Reve7339/FP_Robotics/articulo.pdf

Diseno e Implementaci ˜ | on de un Brazo Rob ´ | otico de ´
| 3 GDL para Corte Laser No-Coplanar ´

Ivan Yerry Hinojosa Zegarra EAP Ingeniería Mecatronica ´ Universidad Continental
Huancayo, Perú
72241950@continental.edu.pe

Brayan Omar Duran Arroyo
EAP Ingeniería Mecatronica ´ Universidad Continental
Huancayo, Perú
72542899@continental.edu.pe

Carlos Benedic Sosa Carhuamaca EAP Ingeniería Mecatronica ´ Universidad Continental
Huancayo, Perú
60847160@continental.edu.pe

Jorge Andre Tapia Patinõ
EAP Ingeniería Mecatronica ´ Universidad Continental
Huancayo, Perú
60761518@continental.edu.pe
Resumen—El presente artículo detalla el diseno, simulaci ˜ | on´
y construccion f ´ | ísica de un brazo manipulador antropomorfico ´
de 3 grados de libertad (GDL) orientado al corte y perfilado laser no-coplanar. El objetivo principal ha sido desarrollar ´ un sistema capaz de seguir trayectorias tridimensionales sobre superficies cilíndricas e irregulares mediante un emisor laser en ´ su efector final, controlado por un microcontrolador ESP32. Se han implementado los modelos de cinematica directa, inversa ´ y Jacobiana para garantizar el posicionamiento espacial en los tres ejes (X, Y, Z) y conservar la distancia focal del laser. La ´
estructura física se fabrico en impresi ´ | on 3D a partir de mallas ´
STL, con un firmware desarrollado en C++. La validacion´
cinematica se realiz ´ | o mediante simulaci ´ | on virtual en ROS 2 y ´
Gazebo de forma puramente offline.
Index Terms—Cinematica, brazo rob ´ | otico, ESP32, C++, ROS ´
2, simulacion virtual. ´
I. INTRODUCCION´

En la industria moderna, los brazos roboticos son he- ´ rramientas fundamentales para tareas de precision como la ´
soldadura y el corte laser. Comprender la cinem ´ | atica detr ´ | as´
de estos mecanismos es el primer paso para su control y programacion [1]. Este proyecto busca aplicar los conceptos ´ teoricos de modelado de robots —tales como matrices de ´
transformacion homog ´ | enea, representaci ´ | on de orientaci ´ | on y ´
cinematica diferencial— en un caso de uso pr ´ | actico. ´
Al estructurar el modelo con 3 grados de libertad (GDL)
(rotacion en la base, elevaci ´ | on en el hombro y elevaci ´ | on en ´
el codo), se simplifico el an ´ | alisis geom ´ | etrico sin perder la ´
capacidad de posicionar el efector final en un volumen de trabajo tridimensional. Ademas, el proyecto utiliza un emisor ´ laser de baja potencia (Clase 1/2) como efector final. A ´ diferencia de procesos de contacto como la soldadura por
arco, el laser permite una validaci ´ | on cinem ´ | atica de “no- ´
contacto”. Esto simplifica el control al eliminar la necesidad de
compensar fuerzas de friccion o colisiones mec ´ | anicas directas ´
contra la pieza de trabajo, permitiendo un seguimiento de trayectoria preciso y eficiente. Este enfoque es crucial para el corte y grabado sobre superficies irregulares y curvadas en tres dimensiones, donde el brazo debe seguir contornos tridimensionales curvos sobre una superficie no plana manteniendo constante la distancia focal del haz laser, una ´
operacion inviable para m ´ | aquinas cartesianas 2D tradicionales. ´
El desarrollo del software, simulacion, firmware embebido e ´ interfaz web se encuentra disponible de forma publica en el ´ repositorio de GitHub del proyecto [2].

II. OBJETIVOS

A. Objetivo General

Desarrollar, simular y construir un brazo robotico articulado ´ de 3 GDL orientado a procesos de corte laser no-coplanar ´ sobre superficies curvas e irregulares, validando los modelos
cinematicos en simulaci ´ | on virtual (ROS 2/Gazebo) y, de forma ´
independiente, en el prototipo físico controlado por un ESP32.
B. Objetivos Específicos

Definir los parametros de Denavit-Hartenberg y resolver ´ analíticamente la cinematica directa, inversa y Jacobiana ´ para garantizar el seguimiento espacial tridimensional (X, Y, Z) y la evasion de singularidades en superficies ´ no planas.
Modelar la estructura física en URDF/Xacro y simular el comportamiento del sistema utilizando el sistema operativo de robots (ROS 2, por sus siglas en ingles) y ´ Gazebo de manera exclusivamente virtual, sin conexion´ física con el prototipo.
Fabricar los eslabones y la base del robot utilizando tecnologías de impresion 3D a partir de archivos STL. ´ Implementar el control de bajo nivel del hardware mediante un microcontrolador ESP32, utilizando C++ para accionar las articulaciones físicas del prototipo.

III. MODELADO CINEMATICO ´

Se utiliza la convencion de Denavit-Hartenberg (D-H) cl ´ | asi- ´
ca para describir la geometría y cinematica del brazo manipu- ´ lador antropomorfico de 3 GDL. ´
A. Justificacion de la Morfolog ´ | ía y Comparacion de Alter- ´
nativas
El brazo robotico desarrollado se destina a la aplicaci ´ | on´
de corte y perfilado laser no-coplanar sobre piezas cil ´ | índricas.
Específicamente, el objetivo es seguir trayectorias espaciales complejas sobre una superficie cilíndrica con un diametro real ´ de 5,3 cm (radio Rtubo = 26,5 mm) montada sobre un soporte de 60 mm de altura. La pieza cilíndrica esta posicionada a ´ una distancia nominal de xtubo = 350 mm y una altura de base ztubo = 60 mm con respecto al origen de la base del robot. Para esta tarea, es indispensable posicionar el efector final de manera tridimensional (X, Y, Z) controlando dinami- ´ camente la altura del cabezal para mantener una distancia de enfoque constante normal al cilindro, evitando colisiones con la estructura del tubo.
Las restricciones físicas del proyecto imponen el uso de actuadores servo de bajo costo (dos MG996R y un MG90S) con un presupuesto de torque limitado. Esto restringe la masa
del efector final, lo que justifica la seleccion de un diodo l ´ | aser ´
semiconductor ligero de estado solido ( ´ | 10 g) que no introduce
esfuerzos inerciales significativos a diferencia de herramientas de mecanizado por contacto.
Con el fin de justificar la seleccion de la morfolog ´ | ía
antropomorfica de 3 GDL (RRR), se analizaron diferentes ´
arquitecturas roboticas est ´ | andar de 3 GDL (Tabla I). ´

Tabla I
COMPARACION DE ´ | MORFOLOGÍAS DE 3 GDL PARA CORTE LASER DE ´
PIEZAS CILÍNDRICAS
Morfología | Config. | Ventajas | Desventajas
Cartesiana | PPP | Alta | rigidez
| | mecanica, ´
| | linealidad | directa
en X, Y, Z.
Gran | volumen
| | | ocupado
| | | (footprint),
incapacidad | de
| | | esquivar obstaculos ´
sin | colisionar
| | | lateralmente.
SCARA | RRP | Alta velocidad en
plano horizontal.

Carrera vertical
(Z) reducida para
| | | geometrías curvas
| | | con gran pendiente
| | | vertical.

Cilíndrica / Polar RPP / RRP Facil alcance radial ´
| | y vertical. | La columna verti-
| | | cal rígida interfie-
| | | re físicamente con
| | | piezas curvas adya-
| | | centes.

Antropomorfica ´
(Seleccionada)

RRR Excelente relacion´
espacio de trabajo
/ huella base, flexibilidad para rodear el tubo y evitar colisiones.
| | | Ecuaciones
| | | cinematicas ´
no | lineales | y
| | | acoplamiento
| | | dinamico. ´
La morfología antropomorfica RRR resulta id ´ | | onea para esta ´
aplicacion al permitir que el brazo se “enrosque” o alcance ´ por encima de la curvatura de la pieza cilíndrica sin que sus eslabones interfieran con ella, manteniendo una alta rigidez en un diseno compacto. Su espacio de trabajo esperado se ˜ caracteriza por una envoltura esferica truncada determinada ´ por los límites de las articulaciones físicas del prototipo:
Articulacion 1 (Base): ´ | θ1 ∈ [−90◦
| | , 90◦ ] (debido a la
restriccion f ´ | ísica de 180◦ del servomotor).
Articulacion 2 (Hombro): ´ | θ2 ∈ [−90◦
| | , 90◦ ] (restringido
en firmware a [−10◦

, 90◦
] por seguridad estructural).
Articulacion 3 (Codo): ´ | θ3 ∈ [−90◦
| | , 90◦ ] (restringido en
firmware a [−120◦

, 10◦
] para evitar colision con el plano ´ de soporte).
Alcance radial maximo: ´ | Rmax | = a2 + a3 + a4 =
322,000 mm
B. Sistemas de Referencia y Parametros D-H ´

Se definen cuatro sistemas de referencia locales {0}, {1}, {2} y {3} asociados a cada articulacion m ´ ovil y al efector final ´ de la estructura, coincidiendo con los marcos de simulacion. ´

d1 = 60 mm: Altura del pedestal de la base.
d2 = 36 mm: Altura del hombro.
a2 = 15 mm: Desfase radial base-hombro.
a3 = 146 mm: Longitud del primer eslabon m ´ | ovil. ´
a4 = 161 mm: Longitud del segundo eslabon m ´ | ovil. ´
d4 = −7 mm: Desplazamiento transversal del efector.
θ1: Angulo de rotaci ´ | on de la base (alrededor del eje ´
vertical Z0).
θ2: Angulo del hombro. ´
θ3: Angulo del codo. ´
La convencion cl ´ | asica de D-H establece que la matriz de ´
transformacion homog ´ | enea entre eslabones consecutivos se ´
calcula mediante:

T

i−1
i =

cos θi | − sin θi cos αi | sin θi sin αi | ai cos θi
sin θi | cos θi cos αi | − cos θi sin αi | ai sin θi
0 | sin αi | cos αi | di
0 | 0 | 0 | 1

| | | (1)
A partir de los sistemas de referencia y dimensiones físicas asignados, se obtiene la Tabla de Parametros D-H (Tabla II). ´
La Fig. 1 ilustra la disposicion geom ´ | etrica de estos par ´ | ametros ´
sobre el modelo físico del brazo en su configuracion de reposo ´ (θ1 = θ2 = θ3 = 0).

Tabla II
PARAMETROS DE ´ | DENAVIT-HARTENBERG REALES DEL PROTOTIPO
Eslabon ( ´ | i) | di (mm) | θi | ai (mm) | αi
1 (0 → 1) | d1 + d2 = 96 θ1 | a2 = 15 | 90◦
2 (1 → 2) | 0 | θ2 | a3 = 146 | 0
3 (2 → 3) | d4 = −7 | θ3 | a4 = 161 | 0

Láser

Haz Láser

θ1

θ2 | θ3

d1
60 mm

d2
36 mm

a2 = 15 mm

a3 = 146 mm | a4 = 161 mm

a2 + a3 + a4 = 322 mm

d4 = −7 mm

Eje X (Rojo)

Eje Z (Azul)

Eje Y (Verde)

X0

Z0

Y0
{0}

X1 Z1

Y1

{1}
X2 Z2

Y2

{2}
X3 Z3

Y3

{3}

Figura 1. Disposicion geom ´ | etrica del brazo rob ´ | otico l ´ | aser en configuraci ´ | on´
de reposo (θ1 = θ2 = θ3 = 0). Se indican los sistemas de referencia D-H {0}–{3}, las longitudes de eslabon´ a3, a4, los desplazamientos d1, d2 y el desfase transversal d4.

B1. Mapeo de Variables Articulares y Desfases Geometri- ´ cos: Es fundamental destacar que las variables articulares θi de la Tabla II corresponden al modelo teorico de Denavit- ´ Hartenberg (donde el brazo totalmente extendido horizontal-
mente define los angulos de hombro y codo ´ | θ2 = θ3 = 0).
Sin embargo, en la construccion f ´ | ísica del prototipo y en el
modelo descriptor URDF de ROS 2/Gazebo, los servomotores se calibran en posiciones angulares relativas a sus ejes de montaje estructural. La correspondencia matematica exacta ´
entre los angulos te ´ | oricos de D-H ( ´ | θ

∗
2

, θ∗
3
) y los angulos f ´ | ísicos
comandados a los servomotores (θ2, θ3) esta definida por los ´ desfasajes angulares mecanicos ´ ϕ2 ≈ 59,017◦
(1,030041 rad)
y ϕ3 ≈ −10,966◦
(−0,191392 rad):

θ

∗
2 = θ2 + ϕ2 | (2)
θ

∗
3 = θ3 + ϕ3 − ϕ2 | (3)

Donde θ

∗
2 y θ

∗
3

son los angulos efectivos utilizados en las ´
matrices de transformacion homog ´ | enea y en el c ´ | alculo de ci- ´
nematica directa anal ´ | ítica, mientras que θ2 y θ3 son los angulos ´
comandados desde el software de control a las articulaciones físicas del robot.
C. Cinematica Directa ´

Sustituyendo los parametros de la Tabla II en (1), se ob- ´
tienen las matrices de transformacion homog ´ | enea individuales ´
para cada articulacion y eslab ´ | on: ´

T

0
1 =

cos θ1 | 0 | sin θ1 | a2 cos θ1
sin θ1 | 0 − cos θ1 | a2 sin θ1
0 | 1 | 0 | d1 + d2
0 | 0 | 0 | 1

(4)

T

1
2 =

cos θ2 | − sin θ2 | 0 a3 cos θ2
sin θ2 | cos θ2 | 0 a3 sin θ2
0 | 0 | 1 | 0
0 | 0 | 0 | 1

(5)

T

2
3 =

cos θ3 | − sin θ3 | 0 a4 cos θ3
sin θ3 | cos θ3 | 0 a4 sin θ3
0 | 0 | 1 | d4
0 | 0 | 0 | 1

(6)

Multiplicando consecutivamente estas matrices se obtiene
la matriz de transformacion homog ´ | enea total del efector final ´
respecto a la base del robot T

0
3 = T

0
| 1 T

1
2 T
2/3. Definimos
esta matriz en funcion de las coordenadas del efector final ´ [xE, yE, zE]

T dadas en (8)-(10):

T

0
3 =

C1C23 | −C1S23 | S1 | xE
S1C23 | −S1S23 | −C1 | yE
S23 | C23 | 0 | zE
0 | 0 | 0 | 1

(7)

donde se utiliza la notacion compacta ´ | C1 = cos θ1, S1 =
sin θ1, C23 = cos(θ2 + θ3) y S23 = sin(θ2 + θ3).
El vector de posicion del efector final ´ | PE = [xE, yE, zE]

T
esta dado por: ´

xE = cos θ1 (a2 + a3 cos θ2 + a4 cos(θ2 + θ3)) + d4 sin θ1 (8)
yE = sin θ1 (a2 + a3 cos θ2 + a4 cos(θ2 + θ3)) − d4 cos θ1 (9)
zE = d1 + d2 + a3 sin θ2 + a4 sin(θ2 + θ3) (10)

Para verificar la consistencia del modelo matematico de- ´
sarrollado, se evaluan las ecuaciones de cinem ´ | atica directa ´
bajo la configuracion de reposo del prototipo (con todas las ´ articulaciones en sus posiciones centrales θ1 = 0, θ2 = 0, θ3 = 0). En este estado, al sustituir los valores y las constantes físicas en (8)-(10), se obtiene:

xE = a2 + a3 cos(0) + a4 cos(0)
= 15 + 146 + 161 = 322 mm | (11)
yE = −d4 = 7 mm | (12)
zE = d1 + d2 + a3 sin(0) + a4 sin(0)
= 60 + 36 + 0 + 0 = 96 mm | (13)

Estos resultados analíticos coinciden exactamente con las coordenadas de la brida (efector final) obtenidas directamente
del arbol de transformadas (TF) de la simulaci ´ | on virtual de ´
ROS 2 (X = 322 mm, Y = 7 mm, Z = 96 mm). Esto valida
la precision del modelo cinem ´ | atico de 4 sistemas propuesto ´
para el guiado de trayectorias.
Para hallar la distancia total en 3D desde el origen del sistema de referencia {0} hasta el efector final en esta posicion´
de reposo, se descompone el calculo geom ´ | etrico en dos etapas ´
mediante el teorema de Pitagoras: 1) Primero, se considera ´ la proyeccion bidimensional sobre el plano longitudinal del ´ brazo (vista lateral, Fig. 2), omitiendo temporalmente el desplazamiento transversal d4. En esta vista, el vector de posicion´ proyectado tiene componentes (xplane, zplane), donde:
xplane = a2 + a3 + a4 = 15 + 146 + 161 = 322 mm | (14)
zplane = d1 + d2 = 60 + 36 = 96 mm | (15)

La distancia proyectada Dplane actua como la hipotenusa de ´
este primer triangulo rect ´ | angulo en el plano vertical: ´

Dplane =

q
x

2
plane + z

2
plane
=

p
322² + 96²

=

√
112900 = 336 mm

(16)

Es de destacar que esta combinacion de par ´ | ametros f ´ | ísicos
produce un valor entero exacto de 336 mm para la hipotenusa del plano de movimiento longitudinal. 2) Segundo, para determinar la distancia tridimensional real, se toma Dplane como el primer cateto y el desfase lateral d4 = 7 mm como el segundo
cateto de un nuevo triangulo rect ´ | angulo en el espacio 3D. La ´
hipotenusa resultante representa la distancia total del efector final al origen:

Dtotal =

q
D²
plane + d

2
4
=

p
336² + 7²

=

√
112949 ≈ 336,08 mm

(17)

Este metodo valida geom ´ | etricamente que las coordenadas ´
tridimensionales calculadas mediante el formalismo D-H son consistentes con la morfología del hardware real.

X0 (mm)

Z0 (mm)

d1 = 60

d2 = 36

a2 | = 15 H | a3 = 146 | C | a4 = 161 | E′

xplane = 322 mm

zplane = 96 mm

Dplane = 336 mm

Figura 2. Deduccion geom ´ | etrica de la distancia proyectada en vista lateral ´
(Dplane) en configuracion de reposo ( ´ | θ1 = 0, θ2 = 0, θ3 = 0). Los eslabones
se alinean horizontalmente formando un triangulo rect ´ | angulo con catetos de ´
322 mm y 96 mm, resultando en una distancia proyectada exacta de 336 mm.
D. Cinematica Inversa y An ´ | alisis de M ´ | ultiples Soluciones ´
La resolucion de la cinem ´ | atica inversa consiste en determi- ´
nar los angulos f ´ | ísicos de los servomotores (θ1, θ2, θ3) a partir
de una posicion cartesiana deseada ´ | | PE = [xE, yE, zE]

T
. Para
ello, desacoplamos el efecto de la rotacion de la base y del ´ desfase transversal d4 de la siguiente manera:
1) Calculo de ´ | θ1 (Rotacion de la Base): ´ | Geometricamente, ´
definimos el radio proyectado plano Rp como la longitud de la proyeccion horizontal de los eslabones principales del brazo ´ en el suelo (desde el eje central de rotacion de la base hasta la ´ punta del brazo). A partir de la cinematica directa en (8)-(9), ´
este radio esta determinado por los eslabones f ´ | | ísicos ai y los
angulos del hombro y codo como: ´
Rp = a2 + a3 cos θ2 + a4 cos(θ2 + θ3) | (18)
Para desacoplar el angulo de la base ´ | θ1, consideramos la
posicion de la punta del brazo en el marco de referencia local ´ del brazo {1} (el cual gira con la base un angulo ´ θ1). En dicho plano local, la coordenada a lo largo del brazo es x1 = Rp y la coordenada transversal debida al desfase transversal de la herramienta es y1 = −d4. La transformacion de estas ´ coordenadas locales al marco global {0} de la base se realiza
mediante una matriz de rotacion alrededor del eje vertical ´ | Z0:
xE
yE
=
cos θ1 | − sin θ1
sin θ1 | cos θ1

Rp
−d4
(19)

Al resolver el producto de la matriz anterior, obtenemos las ecuaciones de la cinematica directa: ´

xE = Rp cos θ1 + d4 sin θ1 | (20)
yE = Rp sin θ1 − d4 cos θ1 | (21)

Elevando al cuadrado y sumando ambas expresiones, el angulo ´ θ1 se elimina mediante la identidad trigonometrica funda- ´ mental sin²
θ1 + cos²
θ1 = 1, lo que nos permite calcular
directamente el valor numerico de ´ | Rp a partir de la coordenada
cartesiana de consigna (xE, yE):

x

2
E + y

2
E = R

2
p + d

2
4 =⇒ Rp =

q
x

2
E + y

2
E − d

2
4

(22)

Realizando la sustitucion de variables polares en el plano ´
XY mediante xE | = R cos β y yE | = R sin β (donde
R =

p
x

2
E + y

2
E

y β = atan2(yE, xE)), las ecuaciones se transforman en:

R cos(β − θ1) = Rp | (23)
R sin(β − θ1) = −d4 | (24)

Dividiendo ambas expresiones trigonometricas, obtenemos el ´
angulo diferencial respecto a la proyecci ´ | on cartesiana: ´
β − θ1 = atan2(−d4, Rp) | (25)
Despejando θ1, se deriva la solucion anal ´ | ítica exacta:
θ1 = atan2(yE, xE) − atan2(−d4, Rp) | (26)
2) Calculo de ´ | θ3 (Elevacion del Codo): ´ | Se define la proyec-
cion en el plano longitudinal del brazo. El radio proyectado ´ corregido r (distancia horizontal desde el eje del hombro al efector) y la altura corregida respecto al hombro z

′
se formulan
como:
r = Rp − a2 | (27)

z

′ = zE − (d1 + d2) | (28)

Aplicando la ley de los cosenos en el triangulo formado por ´ los eslabones a3 y a4 en el plano del brazo para resolver el
angulo del codo ´ | θ3:

r

2 + z

′2 = a

2
3 + a

2

4 − 2a3a4 cos(180◦ − θ3) (29)

Considerando que cos(180◦ − θ3) = − cos θ3, se tiene:

r

2 + z

′2 = a

2
3 + a

2
4 + 2a3a4 cos θ3 | (30)

Despejando el termino del coseno se obtiene: ´

cos θ3 =

r

2 + z

′2 − a

2
3 − a

2
4
2a3a4
= Ψ | (31)
Para la existencia de una solucion f ´ | ísica real libre de numeros ´
complejos, se debe cumplir estrictamente −1 ≤ Ψ ≤ 1. Físicamente, un valor fuera de este rango denota que la coordenada cartesiana solicitada se encuentra fuera del alcance del manipulador (ya sea por estar muy lejana o excesivamente cercana a la base). En lugar de calcular el angulo directamente ´
mediante la funcion de arco coseno ( ´ | θ3 = arc cos Ψ), la cual
presenta inestabilidad numerica en las fronteras ( ´ | Ψ ≈ ±1)
e incertidumbre respecto al signo del angulo, se recurre al ´
calculo del seno de ´ | θ3 mediante la identidad trigonometrica ´
fundamental, sin θ3 = ±

√
1 − Ψ². Esto permite resolver el
angulo de forma num ´ | ericamente robusta en todo el rango ´
[−π, π] mediante el operador arcotangente de dos argumentos:
| θ3 = atan2
±

p
1 − Ψ², Ψ
| | (32)

donde el signo positivo (+) representa la configuracion de ´ codo abajo (Elbow Down) y el signo negativo (−) representa la de codo arriba (Elbow Up).
En el firmware del microcontrolador ESP32 y en la interfaz
grafica, se selecciona de forma exclusiva la configuraci ´ | | on´
de codo arriba (utilizando el signo negativo). Esta decision´
de diseno mec ˜ | anico y de control evita colisiones f ´ | ísicas del
eslabon distal con la mesa de trabajo o la base de soporte, ´ asegurando un despeje maximo de la herramienta y mejorando ´ la operabilidad en superficies no planas.
3) Calculo de ´ | θ2 (Elevacion del Hombro): ´ | Una vez obtenido
θ3, se descompone la posicion cartesiana en el plano del brazo: ´
r = a3 cos θ2 + a4 cos(θ2 + θ3) | (33)
| z
′ = a3 sin θ2 + a4 sin(θ2 + θ3) | (34)

Expandiendo las identidades trigonometricas de la suma de ´
angulos y agrupando los t ´ | erminos: ´
r = (a3 + a4 cos θ3) cos θ2 − (a4 sin θ3) sin θ2 | (35)
z

′ = (a3 + a4 cos θ3) sin θ2 + (a4 sin θ3) cos θ2 (36)

Definiendo las constantes auxiliares sintonizadas k1 = a3 + a4 cos θ3 y k2 = a4 sin θ3, se reescribe el sistema lineal como:

| r = k1 cos θ2 − k2 sin θ2 | (37)
| z
| ′ = k1 sin θ2 + k2 cos θ2 | (38)
Resolviendo el sistema algebraico para los terminos de ´ | sin θ2
y cos θ2:
| sin θ2 =

k1z

′ − k2r
k

2
1 + k

2
2
| | (39)
| cos θ2 =

k1r + k2z

′
k

2
1 + k

2
2
| | (40)

Dividiendo ambas expresiones se determina de manera unica ´
el angulo de elevaci ´ | on del hombro: ´
| θ2 = atan2 (k1z | ′ − k2r, k1r + k2z ′
) | (41)
Alternativamente, aplicando el metodo geom ´ | etrico directo ´
para un manipulador planar de 2 GDL (con eslabones a3 y a4),
el angulo del hombro ´ | θ2 se formula a partir de la diferencia
de angulos en el tri ´ | angulo del brazo: ´

θ2 = atan2(z

| ′
, r) − atan2(a4 sin θ3, a3 + a4 cos θ3) (42)
La equivalencia matematica entre la soluci ´ | on algebraica (41) ´
y la solucion geom ´ | etrica (42) se demuestra mediante la ´

identidad de la diferencia de arcotangentes, atan2(A, B) − atan2(C, D) = atan2(AD − BC, BD + AC), lo que valida la coherencia cinematica del modelo embebido en el micro- ´ controlador.
D1. Gestion de L ´ | ímites Articulares y Puntos Inalcanza-
bles: Para garantizar la integridad física del manipulador y
evitar fallas críticas de ejecucion en el resolvedor matem ´ | atico: ´
Deteccion de Coordenadas Fuera de Alcance: ´ | El
algoritmo evalua el valor de ´ | Ψ en (31) antes de calcular
la raíz cuadrada en (32). Si |Ψ| > 1,0, la coordenada solicitada se encuentra geometricamente fuera de ´ la frontera de alcance del robot (muy lejana o muy cercana a la base). En este caso, el software descarta la consigna cartesiana, genera una alerta visual de tipo OUT_OF_RANGE y detiene el movimiento del laser. Se ´
aplica una pequena tolerancia de ˜ | ±0,005 para compensar
errores de truncamiento decimal de punto flotante en las fronteras extremas del espacio de trabajo.
Filtro de Límites Articulares: Una vez calculada la terna (θ1, θ2, θ3), se comprueba que se cumplan las restricciones físicas de giro de los actuadores del prototipo real (limitados a un rango de operacion f ´ ísica de 180◦ ):

−90◦ ≤ θ1 ≤ 90◦
(43)
−90◦ ≤ θ2 ≤ 90◦
(44)
−90◦ ≤ θ3 ≤ 90◦
(45)

Adicionalmente, el firmware del ESP32 restringe de for-
ma mas estricta estos m ´ | argenes angulares para garantizar ´
la seguridad del hardware frente a sobrecorrientes o colisiones con la mesa de trabajo:

−10◦ ≤ θ2 ≤ 90◦
(46)
−120◦ ≤ θ3 ≤ 10◦
(47)

Cualquier consigna que viole estos límites se descarta au-
tomaticamente para evitar colisiones mec ´ | anicas directas ´
o sobre-esfuerzo de los servomotores.
E. Jacobiano, Singularidades y Caracterizacion del Espacio ´ de Trabajo

La cinematica diferencial del manipulador relaciona las ´ velocidades del espacio articular con las velocidades lineales del efector en el espacio cartesiano. Para obtener la matriz Jacobiana Jv ∈ R

3×3
, se recurre al metodo geom ´ | etrico (pro- ´
ductos vectoriales basados en los sistemas de referencia D-H), siendo el mas conveniente por su simplicidad en articulaciones ´ rotacionales, expresandose columna por columna como: ´
Jvi = zi−1 × (pe − pi−1) | (48)

Al aplicar esta metodología a nuestro manipulador de 3 GDL, se definen los ejes de rotacion en el sistema de referencia ´ global:

z0 =

0
0
1
- , z1 = z2 =

sin θ1
− cos θ1
0
- (49)

y los vectores de posicion relativos del efector ´ | pe respecto a
la base p0 y al codo p2:

pe − p0 =

Rp cos θ1 + d4 sin θ1
Rp sin θ1 − d4 cos θ1
ze
| (50)

pe − p2 =

a4 cos(θ2 + θ3) cos θ1 + d4 sin θ1 a4 cos(θ2 + θ3) sin θ1 − d4 cos θ1 a4 sin(θ2 + θ3)

- (51)

donde Rp = a2 + a3 cos θ2 + a4 cos(θ2 + θ3) es el radio proyectado del brazo. Al calcular los productos vectoriales cruzados, se obtienen las columnas de la velocidad lineal:

Jv1 = z0 × (pe − p0) =

−Rp sin θ1 + d4 cos θ1
Rp cos θ1 + d4 sin θ1
0
- (52)

Jv3 = z2 × (pe − p2) =

−a4 cos θ1 sin(θ2 + θ3)
−a4 sin θ1 sin(θ2 + θ3)
a4 cos(θ2 + θ3)
- (53)

Al agrupar las tres columnas del manipulador, se conforma la matriz Jacobiana lineal final:

Jv =

−S1Rp + d4C1 | −C1(a3S2 + a4S23) −C1a4S23
C1Rp + d4S1 | −S1(a3S2 + a4S23) −S1a4S23
0 | a3C2 + a4C23 | a4C23
| | (54)
donde se emplea la notacion compacta ´ | Si , Ci | , S23 y C23 para
representar los senos y cosenos directos. Esto demuestra de
forma analítica que el metodo geom ´ | etrico entrega exactamente ´
el mismo resultado que la diferenciacion anal ´ | ítica.
E1. Calculo Simplificado del Determinante: ´ | | El determi-
nante de la matriz Jacobiana Jv es una herramienta analítica clave para determinar las singularidades cinematicas del robot. ´ Para calcularlo de forma simplificada, se realiza la expansion´ por cofactores a lo largo de la tercera fila de Jv en (54). Dado que esta fila posee un elemento nulo (J31 = 0), el determinante se reduce a la suma de dos terminos: ´

det(Jv) = −J32(J11J23 − J13J21) + J33(J11J22 − J12J21)
| | (55)
Este calculo se puede simplificar sustancialmente mediante ´ tres pasos clave:
1. Eliminacion de la orientaci ´ | on de la base ( ´ | θ1): Al
expandir los productos cruzados dentro de los parentesis ´
de (55), se factoriza de forma natural el termino ´ | sin²
| | θ1+
cos²
θ1 (utilizando la notacion compacta ´ | S

2
| | 1+C 2/1). Por la
identidad pitagorica fundamental, este t ´ | ermino es igual ´
a 1, eliminando por completo la influencia de θ1:
J11J23 − J13J21 = a4S23Rp | (56)
J11J22 − J12J21 = (a3S2 + a4S23)Rp | (57)

Esto demuestra analíticamente que la orientacion angular ´ de la base no afecta las singularidades de posicionamiento del brazo.
2. Agrupamiento de terminos en el plano: ´ | | Al sustituir
las simplificaciones anteriores y los coeficientes de la tercera fila J32 = a3C2 +a4C23 y J33 = a4C23 en (55),
se cancelan los terminos que contienen ´ | a
2/4, reduciendo
la expresion a: ´
det(Jv) = a3a4Rp(S2C23 − C2S23) | (58)
o de forma equivalente en terminos trigonom ´ | etricos ´
expandidos:

det(Jv) = a3a4Rp(sin θ2 cos(θ2 + θ3)
− cos θ2 sin(θ2 + θ3)) | (59)
3. Identidad del seno de la diferencia de angulos: ´
Utilizando la conocida identidad trigonometrica ´ | | sin(A−
B) = sin A cos B − cos A sin B (donde definimos A = θ2 y B = θ2 + θ3, de modo que A − B = −θ3 y sin(−θ3) = − sin θ3), se llega de forma directa a la formulacion final compacta del determinante: ´
det(Jv) = −a3a4Rp sin θ3 | (60)

Esta expresion demuestra que el determinante es independiente ´ del desfase transversal d4, lo que significa que el descentramiento lateral de la herramienta no influye en las condiciones de bloqueo del brazo.
E2. Cinematica Diferencial Inversa y Aplicaci ´ | on Num ´ | eri- ´
ca: Para controlar la velocidad de avance del cabezal laser a ´ lo largo del contorno y mantener un haz de corte homogeneo, ´ se calcula la cinematica diferencial inversa, la cual relaciona ´ la velocidad cartesiana lineal de consigna P˙ = [ ẋ, y,˙ z˙]
T
con las velocidades angulares requeridas en las articulaciones q˙ = [ ˙θ1,

˙θ2,

˙θ3]
T
a traves de ´ q˙ = J

−1

v P˙
Debido a que el determinante de Jv se dedujo en (60), es posible invertir la matriz de forma analítica desacoplando el movimiento en el plano radial y transversal. Al proyectar la velocidad cartesiana sobre el marco giratorio de la base, la velocidad angular de la base y la tasa de cambio del radio proyectado se expresan como:

˙θ1 =

−x˙ sin θ1 + ẏ cos θ1
Rp

(61)

R˙
p = ẋ cos θ1 + ẏ sin θ1 − d4
˙θ1 | (62)

Con el valor de R˙
p y la velocidad vertical deseada z˙, se resuelve el sistema coplanar para el hombro y el codo empleando la inversa de la submatriz planar Jplanar:

˙θ2 =

a

′

4C23R˙
p + a

′
4S23z˙
a3a

′
4S3

(63)

˙θ3 =

−(a3C2 + a

′

4C23)R˙
p − (a3S2 + a

′
4S23) ż
a3a

′
4S3

(64)

donde se emplea la notacion compacta ´ | S3 = sin θ3, C2 =
cos θ2, S2 = sin θ2, C23 = cos(θ2 +θ3) y S23 = sin(θ2 +θ3).
A modo de verificacion pr ´ | actica de estas ecuaciones de ve- ´
locidad, se evalua num ´ | ericamente el comportamiento din ´ | ami- ´
co del manipulador real con el eslabon extendido del l ´ | aser ´
a

′

4 = 361 mm en la configuracion articular ´ | θ1 = 0, θ2 = 30◦
(0,5236 rad) y θ3 = −45◦
(−0,7854 rad), asumiendo un requerimiento de velocidad lineal pura en sentido transversal

(eje Y ) de P˙ = [0, 100, 0]T mm/s (equivalente a un barrido transversal de 10 cm/s sobre la pieza):
1) Calculo del radio proyectado ´ | Rp:

Rp = a2 + a3 cos θ2 + a

′
4

cos(θ2 + θ3)
= 15 + 146 cos(30◦

) + 361 cos(−15◦
)
≈ 15 + 126,44 + 348,69 = 490,13 mm
2) Determinacion de las velocidades articulares: ´ Sustituyendo en (61) con sin(0) = 0 y cos(0) = 1:

˙θ1 =

−0 · 0 + 100 · 1
490,13

≈ 0,2040 rad/s (≈ 11,69◦
/s)

A partir del valor de ˙θ1, calculamos R˙
p mediante (62):

R˙
p = 0 · 1 + 100 · 0 − (−7) · 0,2040 ≈ 1,428 mm/s

Con R˙
p = 1,428 mm/s y z˙ = 0, resolvemos las velocidades angulares del hombro y del codo a traves´ de (63) y (64):

˙θ2 =

361 cos(−15◦
) · 1,428 + 0
146 · 361 sin(−45◦)

=

497,93
−37267,4

≈ −0,0134 rad/s (≈ −0,77◦
/s)

˙θ3 =

−(146 cos(30◦

) + 361 cos(−15◦
)) · 1,428 − 0
146 · 361 sin(−45◦)

=

−678,53
−37267,4

≈ 0,0182 rad/s (≈ 1,04◦
/s)
Este calculo demuestra c ´ | omo se distribuye vectorialmente la ´
velocidad de consigna cartesiana en las juntas mecanicas, ´ permitiendo que el software en la computadora host controle la dinamica del movimiento sin saturar el torque de los ´ servomotores físicos.
E3. Analisis F ´ ísico de Singularidades: Las singularidades cinematicas son configuraciones o ”posturas. ´

específicas donde
el robot se bloquea y pierde la capacidad de moverse en al-
guna direccion del espacio. Matem ´ | aticamente ocurren cuando ´
det(Jv) = 0, lo que provoca que el sistema exija velocidades infinitas en los servomotores para realizar movimientos cartesianos mínimos, generando sobrecorrientes y fallos. En este manipulador se identifican dos singularidades críticas: Singularidad del Codo (sin θ3 = 0 =⇒ θ3 = 0 ó θ3 = −π): Ocurre cuando el brazo esta completamente estira- ´ do o totalmente encogido. En esta posicion, el efector no ´
puede realizar ningun movimiento en la direcci ´ | on radial ´
del brazo (no puede estirarse ni encogerse mas). Si se ´ le ordena avanzar en esa direccion, los servomotores del ´ hombro y del codo tendrían que moverse a una velocidad teoricamente infinita para obedecer la consigna, lo que ´
en la practica produce un bloqueo mec ´ | anico del brazo, ´
picos extremos de corriente electrica que pueden da ´ | nar ˜
los motores y el reinicio del microcontrolador ESP32 debido a la sobrecarga.
Singularidad de la Base (Rp = 0): Ocurre cuando el codo se repliega de tal manera que el efector final queda alineado exactamente sobre el eje vertical de rotacion de ´ la base (Z0). En esta pose, si se le ordena al laser un ´ movimiento horizontal perpendicular al brazo, la base
tendría que girar instantaneamente un ´ | angulo de ´ | 90◦
(velocidad de giro teoricamente infinita, ´

˙θ1 → ∞). Esto
genera fuertes oscilaciones, vibraciones inestables y la perdida del control de posicionamiento en el prototipo ´ físico.
E4. Caracterizacion y An ´ | alisis Gr ´ | afico del Espacio de ´
Trabajo: El espacio de trabajo util del brazo manipulador ´
antropomorfico est ´ | a delimitado geom ´ | etricamente por los al- ´
cances mínimos y maximos de la cadena cinem ´ | atica, truncados ´
por las restricciones angulares de los servomotores. La Fig. 3 representa la seccion transversal de la envolvente de trabajo ´ en el plano vertical (Rp–Z).

Hombro

Codo

Límite θ2 = 90◦

Límite θ2 = −10◦

Rmax

= 307,0 mm

Rmin

Rp (mm)

Z (mm)

Camara ´

Soporte

Cilindro

Laser ´

Sing. Base (Rp = 0)

Sing. Codo Extendido (θ3 = 0◦)

Sing. Codo Plegado (θ3 = −180◦)

Figura 3. Espacio de trabajo (seccion transversal ´ | Rp–Z) con eslabones en
posicion de enfoque y l ´ | ímites de θ2 ∈ [−10◦, 90◦]. Se destacan en líneas
discontinuas rojas las zonas de singularidad del Jacobiano: base (Rp = 0) y codo (fronteras Rmin y Rmax).
F. Generacion de Trayectorias y Planificaci ´ | on en el Espacio ´
Cartesiano
Para garantizar la calidad y precision del corte l ´ | aser, se ´
implementa una planificacion en el espacio cartesiano. La ´ trayectoria requerida sobre la pieza cilíndrica se discretiza en una secuencia ordenada de puntos tridimensionales. Para cada punto de esta secuencia, la computadora host calcula la
solucion exacta del modelo de cinem ´ | atica inversa y transmite ´
los angulos de articulaci ´ | on resultantes al microcontrolador ´
ESP32 a una frecuencia constante de 20 Hz.
El algoritmo de planificacion proyecta cada p ´ | íxel del dibujo
2D (px, py) en una imagen de dimensiones Wu × Hu a una coordenada cartesiana tridimensional sobre la superficie del cilindro (xs, ys, zs) usando el mapeo inverso:
xs = Xc − Rc cos θ | (65)

ys = Yc −

px
Wu − 1

− 0,5

- Wflat | (66)
zs = Zc + Rc sin θ | (67)

donde Xc = 500 mm, Yc = 0 mm, Zc = 55 mm es la
posicion central del cilindro, ´ | Rc = 15 mm es su radio, Wflat =
60 mm es el ancho plano extendido y θ = θmax −

py
Hu−1

·2θmax
(con θmax = 1,25 rad) representa la rotacion angular del ´ envoltorio.
Para que el haz laser corte de manera efectiva, el efec- ´ tor final físico (punto de salida del haz en la brida) debe situarse a una distancia focal constante de df = 200 mm respecto a la superficie del cilindro. Para implementar esta
restriccion sin agregar complejidad geom ´ | etrica al resolvedor ´
de cinematica inversa, se aplica una compensaci ´ | on virtual del ´
largo del eslabon terminal en el resolvedor IK. En lugar de ´
resolver la cinematica inversa con la longitud f ´ | | ísica del tercer
eslabon´ a4 = 161 mm, el resolvedor utiliza un eslabon ficticio ´ extendido:

a

′
4 = a4 + df = 161 + 200 = 361 mm | (68)

Al ingresar las coordenadas de superficie (xs, ys, zs) como
objetivo en la cinematica inversa usando ´ | a

′
4
| | , la junta del
codo se posiciona de tal forma que la brida física se situá exactamente a 200 mm normales de la superficie del cilindro, manteniendo constante el enfoque del laser durante todo el ´ movimiento.
A modo de ejemplo numerico de aplicaci ´ | on del algoritmo ´
de planificacion de trayectorias, se realiza el c ´ | alculo completo ´
para un punto de consigna ubicado en el centro de la imagen de entrada (px = 100, py = 100) en una cuadrícula de 200×200 píxeles (Wu = 200, Hu = 200):
1) Calculo de la coordenada angular ´ | | θ sobre el cilindro:

θ = 1,25 −

100
199
| · 2,50 ≈ −0,0063 rad
2) Mapeo a coordenadas cartesianas 3D sobre la superficie mediante (65)-(67):

xs = 500 − 15 cos(−0,0063) ≈ 485,00 mm

ys = 0 −

100
199

− 0,5

- 60 ≈ −0,15 mm

zs = 55 + 15 sin(−0,0063) ≈ 54,91 mm

3) Compensacion focal y resoluci ´ | on de la cinem ´ | atica inver- ´
sa:
- Radio proyectado en la base Rp: Usando el eslabon´ extendido a

′
4 = 361 mm, calculamos el radio proyectado Rp:

rs =

p
x

2
s + y

2
s
=

p
485,00² + (−0,15)² ≈ 485,00 mm

Rp =

q
r

2
s − d

2
4
=

p
485,00² − (−7)² ≈ 484,95 mm
- Angulo de la articulaci ´ | on de la base ´ | θ1:

θ1 = atan2(−0,15, 485) − atan2(7, 484,95)
| ≈ −0,0147 rad (≈ −0,84◦
)
- Variables coplanares corregidas respecto al hombro:

xc = Rp − a2 = 484,95 − 15 = 469,95 mm
zc = zs − (d1 + d2) = 54,91 − 96 = −41,09 mm
- Angulo de la articulaci ´ | on del codo ´ | θ3 (configuracion´
codo-arriba):
Ψ = 469,95² + (−41,09)² − 146² − 361²
| 2 · 146 · 361
≈ 0,6724
θ3 = atan2
−

p

1 − 0,6724², 0,6724

≈ −0,8335 rad (≈ −47,76◦
)
- Angulo de la articulaci ´ | on del hombro ´ | θ2:

k1 = a3 + a

′
4
| cos θ3
= 146 + 361(0,6724) ≈ 388,74 mm k2 = a

′
4

sin θ3
= 361 sin(−0,8335) ≈ −267,22 mm θ2 = atan2(k1zc − k2xc, k1xc + k2zc)
| ≈ 0,5147 rad (≈ 29,49◦
)

El resolvedor cartesiano ejecuta estas operaciones para cada punto de la trayectoria en la laptop de forma instantanea y sin ´
experimentar ningun retraso en los c ´ | alculos, transmitiendo de ´
manera determinista los angulos articulares al microcontrola- ´ dor mediante conexion serie. ´

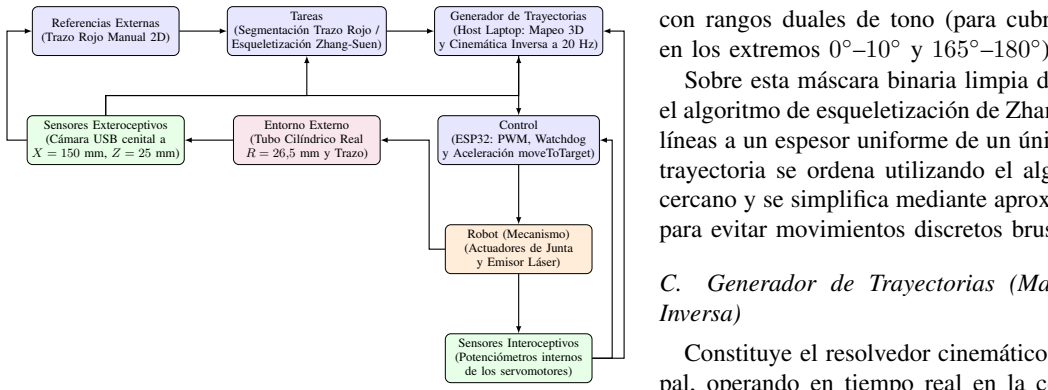
[picture p1: figure]
Referencias Externas (Trazo Rojo Manual 2D); Sensores Exteroceptivos; Tareas (Segmentacion Trazo Rojo / ´ Esqueletizacion Zhang-Suen) ´; Entorno Externo (Tubo Cilíndrico Real R = 26,5 mm y Trazo); Generador de Trayectorias (Host Laptop: Mapeo 3D y Cinematica Inversa a 20 Hz) ´; Control (ESP32: PWM, Watchdog y Aceleracion moveToTarget) ´; Robot (Mecanismo) (Actuadores de Junta y Emisor Laser) ´; Sensores Interoceptivos (Potenciometros internos ´ de los servomotores); en los extremos 0; Inversa)

(Camara USB cenital a ´ X = 150 mm, Z = 25 mm)

Figura 4. Esquema funcional de lazo de control del brazo robotico de 3 GDL ´ para corte y grabado laser no-coplanar en formato de columna simple (media ´ pagina). ´

IV. ARQUITECTURA Y ESQUEMA FUNCIONAL DEL ROBOT

Para comprender de manera integral la operacion y el guiado ´
automatico del manipulador rob ´ | otico de 3 GDL, se estructur ´ | ó
una arquitectura de control en lazo cerrado basada en el flujo de informacion entre las consignas de usuario, los resolvedores ´
matematicos del host, el controlador f ´ | | ísico de bajo nivel y los
sistemas de retroalimentacion sensorial. En la Fig. 4 se detalla ´ el esquema funcional propuesto, el cual adapta el modelo de control en lazo cerrado clasico con sensores exteroceptivos e ´ interoceptivos.
A continuacion, se detalla el funcionamiento de cada uno ´
de los bloques y su integracion en el sistema f ´ | ísico real:
A. Referencias Externas (Trazo Rojo Manual 2D)
Este bloque representa la consigna de entrada o la trayectoria de referencia deseada en el espacio de la tarea. En el sistema desarrollado, si bien en el entorno de simulacion´ virtual se cargaban letras o vectores predefinidos, en la realidad la referencia consiste en un trazo continuo dibujado a mano alzada con un rotulador de color Rojo directamente sobre la superficie cilíndrica de trabajo. El brazo robotico debe detectar ´ y seguir físicamente este contorno dibujado, permitiendo una
interaccion directa y guiada por el trazo real en la pieza f ´ | | ísica.
B. Tareas (Segmentacion Trazo Rojo y Esqueletizaci ´ | on´
Zhang-Suen)
Es la primera etapa de procesamiento de software ejecutada en la computadora host (laptop). Su objetivo es procesar la
informacion de imagen capturada por la c ´ | amara USB cenital ´
y extraer de forma determinista la trayectoria geometrica ´ ordenada del trazo físico. Inicialmente, el sistema realiza una mascarilla cian sobre la imagen para aislar y modelar la
posicion tridimensional del cilindro f ´ | | ísico (cuyo cuerpo es
de color cian). Posteriormente, para la tarea de guiado de corte, el software segmenta específicamente el Trazo Rojo manual aplicando una mascara de color en el espacio HSV ´ con rangos duales de tono (para cubrir la transicion de rojo ´ ).
Sobre esta mascara binaria limpia del trazo rojo, se ejecuta ´ el algoritmo de esqueletizacion de Zhang-Suen para reducir las ´
líneas a un espesor uniforme de un unico p ´ | | íxel. Finalmente, la
trayectoria se ordena utilizando el algoritmo del vecino mas´ cercano y se simplifica mediante aproximacion poligonal RDP ´ para evitar movimientos discretos bruscos en los actuadores.
C. Generador de Trayectorias (Mapeo 3D y Cinematica ´

Constituye el resolvedor cinematico y de trayectoria princi- ´ pal, operando en tiempo real en la computadora host a una frecuencia constante de 20 Hz. Este bloque recibe la ruta de píxeles secuenciada y realiza las siguientes operaciones consecutivas en la CPU de la laptop:
1. Proyeccion espacial sobre el cilindro mediante las ecua- ´ ciones de mapeo inverso (65)-(67), transformando las coordenadas de píxeles (px, py) a coordenadas cartesianas tridimensionales reales (xs, ys, zs) en milímetros sobre la superficie curva.
2. Aplicacion de la compensaci ´ | on de la distancia de ´
enfoque, la cual utiliza el eslabon extendido virtual ´ a

′
4 = a4 + df = 361 mm de (68) en lugar de la longitud física de la brida (a4 = 161 mm), forzando
mecanicamente al cabezal del l ´ | aser a permanecer a una ´
distancia focal constante de 200 mm perpendicular a la superficie cilíndrica.
3. Resolucion del resolvedor cinem ´ | atico inverso anal ´ | ítico
codo-arriba para cada punto de la trayectoria 3D, pro-
duciendo la secuencia de angulos articulares ´ | | (θ1, θ2, θ3)
que se transmiten de manera determinista al hardware a
traves de la conexi ´ | on serial. ´
El resolvedor cartesiano ejecuta estas operaciones en la CPU del host de forma síncrona, eliminando los retrasos de calculo ´ en el lazo.
D. Control (Microcontrolador ESP32)

Este bloque representa el controlador digital de bajo nivel de hardware embebido en el microcontrolador físico ESP32. Su funcion principal es recibir las posiciones articulares ´ (θ1, θ2, θ3) en radianes provenientes del host, validar que cumplan estrictamente con las restricciones de límites angulares físicos para evitar colisiones estructurales, y convertirlas a anchos de pulso de microsegundos de la senal PWM para ˜ accionar los servomotores físicos. La recepcion se implementa ´ a traves de la interfaz UART a 115200 bps mediante tramas ´ de texto estructuradas.
Adicionalmente, el controlador ejecuta tres rutinas críticas en su bucle periodico: ´
Aceleracion moveToTarget(): ´ | Un algoritmo de interpo-
lacion lineal s ´ | íncrono que divide los cambios angulares
repentinos en incrementos maximos de ´ | | 15 µs (≈ 1,35◦ )
espaciados por retardos temporales fijos de 15 ms, eliminando los picos de corriente instantaneos en la fuente ´

de alimentacion externa que provocan ca ´ | ídas de tension´
y el apagado del microcontrolador.
Conmutacion S ´ | íncrona del Laser: ´ | Gestiona de manera
coordinada el pin digital GPIO 25 para encender y apagar el haz de luz coherente de forma sincronizada con el perfil cinematico de movimiento, previniendo marcas ´ quemadas accidentales en fases de reposo.
Watchdog de Seguridad: Un temporizador por software que comprueba la llegada periodica de comandos seriales. ´ Si transcurren mas de ´ 1000 ms sin recibir comandos validos del host, el microcontrolador desactiva inme- ´ diatamente el laser digital para prevenir quemaduras ´ incidentales o incendios en la pieza de trabajo por perdida ´ de conexion. ´
E. Robot (Mecanismo)

Consiste en la planta física y mecanica del brazo manipu- ´
lador antropomorfico de 3 GDL. Est ´ | a estructurado por la base ´
giratoria y los eslabones articulados fabricados en impresion´ 3D FDM utilizando plastico PETG de alta rigidez, los tres ´ servomotores que actuan sobre las juntas activas (un MG996R ´ en la base, un MG996R en el hombro y un MG90S en el codo) y el emisor de diodo laser montado en la brida final. ´ Este bloque ejecuta mecanicamente los comandos angulares de ´ junta transformando las senales el ˜ ectricas de PWM en torques ´ de eje que desplazan angularmente los eslabones, posicionando espacialmente el emisor y proyectando el haz de luz sobre el entorno cilíndrico.
F. Entorno Externo (Pieza Cilíndrica de Trabajo)

Es el plano y volumen físico sobre el cual interacciona la herramienta final del robot. En este sistema de estudio, el entorno consiste en un tubo cilíndrico de radio real Rtubo = 26,5 mm
(diametro ´ | 5,3 cm) montado sobre un soporte horizontal con
una altura de base de 60 mm y situado a una distancia radial fija de xtubo = 350 mm con respecto al origen de la base del brazo. La superficie del tubo cilíndrico es la que recibe la
proyeccion de la trayectoria y experimenta la alteraci ´ | on f ´ | ísica
(grabado o corte termico) provocada por la colisi ´ | on del haz ´
de luz laser enfocado. Su geometr ´ | ía introduce una variacion´
no lineal de altura en funcion del radio de giro. ´
G. Sensores Exteroceptivos (Camara USB Cenital) ´

Este bloque de sensores proporciona el lazo de realimen-
tacion visual externo. Una c ´ | amara USB f ´ | ísica externa está
montada de forma rígida a una distancia fija de X = 150 mm y una altura de Z = 25 mm con respecto a la base del
robot. La camara captura continuamente la escena f ´ | ísica (el
cilindro y el trazo dibujado) y transmite la senal de video ˜ (RGB de 640x480 píxeles a 30 fps) a la laptop host. El software utiliza este feed de video optico cenital para cerrar el ´ lazo, permitiendo la auto-deteccion del color cian de la pieza ´
cilíndrica, el calculo de la homograf ´ | ía y la proyeccion inversa ´
de dibujo plano sobre el contorno físico curvo en tiempo real, compensando cualquier error de alineacion estructural. ´
H. Sensores Interoceptivos (Potenciometros de Servomoto- ´ res)
Constituyen el lazo de realimentacion interno de posici ´ | on´
de las articulaciones del manipulador. Cada servomotor físico (MG996R y MG90S) cuenta en su interior con un potenciome- ´
tro analogico de precisi ´ | on montado solidariamente al eje de ´
salida de los engranajes reductores y un controlador de control
local analogico integrado. El potenci ´ | ometro lee constantemen- ´
te el angulo de giro real de la junta mec ´ | anica y el circuito ´
comparador del servo ajusta instantaneamente la tensi ´ | on del ´
motor de corriente continua para anular la diferencia respecto a la senal de referencia PWM comandada por el ESP32. ˜ Esta realimentacion ocurre internamente en cada servomotor ´ a una frecuencia de aproximadamente 1 kHz, garantizando un posicionamiento articular preciso frente a torques de gravedad y fuerzas dinamicas externas sin sobrecargar el procesador del ´ ESP32.
V. METODOLOGÍA Y ALCANCE
La ejecucion del proyecto se estructur ´ | o en dos fases meto- ´
dologicas consecutivas: ´
A. Fase 1: Modelado Mecanico y Simulaci ´ | on Virtual ´

Se disenaron las piezas tridimensionales del manipulador ˜ en CAD. Los modelos tridimensionales de los eslabones se exportaron en formato STL para el proceso de manufactura, y se compilaron en un archivo descriptor URDF (con formato de mallas colisionables e inerciales). En el entorno de ROS 2
y Gazebo, se programo un nodo de simulaci ´ | on independiente ´
para validar computacionalmente los modelos de cinematica ´ directa e inversa, garantizando que el seguimiento de las trayectorias cartesianas de corte ocurra libre de colisiones
mecanicas directas o singularidades. Esta simulaci ´ | on en ROS ´
2 y Gazebo se mantiene de forma puramente virtual, sin establecer conexiones directas de comunicacion o control hacia ´ el prototipo físico.
B. Fase 2: Fabricacion e Integraci ´ | on de Hardware ´
La estructura mecanica se fabric ´ | o mediante impresi ´ | on 3D ´
FDM de los archivos STL utilizando plastico PETG con un ´ patron de relleno de alta densidad (40 % o superior) para ´ absorber esfuerzos de flexion. Se integraron los actuadores ´ en sus correspondientes articulaciones físicas: un servomotor MG996R en la base (giro izquierdo/derecha), un servomotor MG996R en el hombro (para soportar el torque gravitacional) y un servomotor MG90S en el codo.
VI. IMPLEMENTACION DE ´ | SOFTWARE Y ALGORITMOS DE
| CONTROL

El ecosistema de software del manipulador se divide en tres capas fundamentales que operan coordinadamente de forma puramente virtual para el entorno de simulacion (la ´ interfaz web interactiva de usuario, el generador síncrono de trayectorias en ROS 2 y el puente de comunicacion de red): ´

A. Arquitectura de Comunicacion e Intercambio de Datos ´ El ecosistema de software opera en un esquema coordinado donde la interfaz de usuario interactiva y el resolvedor
dinamico de la simulaci ´ | on f ´ | ísica se comunican en tiempo real
a traves de un puente HTTP y t ´ | opicos de ROS 2. El flujo de ´
datos e integracion de los componentes clave se describe a ´ continuacion: ´
Capa de Interfaz Grafica (Frontend): ´ | Implementa-
da en HTML/JS (app.js), captura la interaccion del ´ operador mediante barras de desplazamiento para los angulos articulares o entradas cartesianas tridimensiona- ´
les de posicion ( ´ | X, Y, Z) calculadas localmente mediante
cinematica inversa. Cuando ocurre un cambio, la funci ´ | on´
sendJointsToROS() serializa los angulos de las ar- ´ ticulaciones J1, J2, J3 (en grados sexagesimales) dentro de un objeto JSON y realiza una peticion HTTP POST ´ throttleada (con un intervalo mínimo de 50 ms) hacia el endpoint local de la API /api/move.
Capa del Puente de Red (Web Bridge): El script en Python web_bridge.py inicializa de forma concurrente un servidor HTTP en el puerto 8080 y un nodo de ROS 2. Al recibir la peticion POST en la ruta ´ /api/move, el manejador de peticiones del servidor decodifica el objeto JSON, recupera los valores angulares y ejecuta la funcion´ publish_joints() del nodo.
Esta funcion convierte de forma instant ´ | anea las variables ´
articulares de grados sexagesimales a radianes y las
publica en el topico ´ /arm_controller/commands
de ROS 2.
Capa de Simulacion Virtual (ROS 2 / Gazebo): ´ | El
resolvedor físico y dinamico de Gazebo est ´ | a suscrito ´
de forma nativa a /arm_controller/commands. Al
recibir los radianes de consigna, los controladores de posicion articulares virtuales aplican torques proporcionales ´ para llevar los eslabones simulados del robot a la pose deseada.
Generacion de Trayectorias Aut ´ | onomas: ´ | De manera
paralela e independiente de la interfaz grafica, el script ´ trajectory_generator.py publica directamente
en el topico ´ | /arm_controller/commands a una
frecuencia de 50 Hz. Este nodo interpola entre una secuencia programada de keyframes utilizando un perfil de velocidad cosenoidal (S-curve), permitiendo realizar
validaciones dinamicas autom ´ | aticas dentro del simulador ´
físico Gazebo de forma desacoplada del frontend web.
B. Interfaz Web de Control e Interaccion Din ´ amica (app.js) ´ La interfaz de usuario esta desarrollada en JavaScript de ´ cliente puro y HTML5. Permite realizar simulacion en l ´ ínea y resolvedor de cinematica inversa interactiva. El algoritmo ´
detallado de la cinematica inversa se presenta en el C ´ | odigo 1 ´
en el Apendice A. Los componentes de la capa de interfaz ´ web realizan las siguientes tareas:
Lienzo de Dibujo Interactivo (Canvas): La rutina drawRobot() proyecta en tiempo real el comportamiento dinamico bidimensional del robot sobre un lienzo ´

Canvas HTML5, mostrando vistas superior (X-Y ) y lateral (X-Z) para dar retroalimentacion visual al operador ´ sobre la trayectoria de corte.
Interpolacion de Suavizado de Movimiento: ´ | | Para
transicionar sin saltos discretos hacia las coordenadas
indicadas, la funcion´ | animateToJoints() aplica
un algoritmo de facilidad cubica ( ´ | Cubic Ease-Out) a
60 cuadros por segundo, emulando el amortiguamiento físico de los servomotores reales.
C. Generador de Trayectorias de Simulacion (trajec- ´ tory generator.py)
El nodo generador de trayectorias en Python modela el
perfil cinematico de interpolaci ´ | on de simulaci ´ | on en ROS 2 ´
y Gazebo. El lazo periodico de control temporal de este script ´
se detalla en el Codigo 2 en el Ap ´ | endice B. Este nodo realiza ´
la generacion y control s ´ | íncrono mediante:
Interpolacion Cosenoidal (S-curve): ´ | | La ecuacion co- ´
senoidal suaviza el incremento de velocidad al inicio y
finalizacion del movimiento de cada eslab ´ | | on, eliminando ´
las aceleraciones abruptas que provocan oscilaciones inerciales o colisiones mecanicas virtuales en el resol- ´ vedor de física de Gazebo.
Bucle Síncrono a 50 Hz: Garantiza una comunicacion´ continua hacia los controladores articulares virtuales a intervalos exactos de 20 ms.
D. Puente de Comunicacion ROS 2 y Control de Hardware ´ (web bridge.py)
La comunicacion intermedia entre la simulaci ´ | | on virtual, la ´
interfaz web y el prototipo físico se centraliza en un script multi-hilo desarrollado en Python. Este puente no solo traduce y publica tramas en ROS 2 para Gazebo, sino que integra el control del hardware físico real mediante las siguientes bases tecnicas: ´
Servidor HTTP Multihilo y Endpoints de Hardware: Inicializa un servidor HTTP en el puerto 8080. Para controlar el prototipo real, expone los endpoints /api/ physical/connect (conexion UART a 115200 bps), ´ /api/physical/move (envío síncrono de comandos a los servomotores), /api/physical/list_ports
(listado y deteccion autom ´ | atica de puertos ´ | /dev/
ttyUSB* / /dev/ttyACM*) y /api/physical/
status (estado de conexion y respuesta del firmware). ´ SerialManager Thread-safe: Implementa una clase
de gestion serial con bloqueos de exclusi ´ | | on mutua ´
(threading.Lock). Esto previene condiciones de carrera cuando se envían tramas síncronas periodicas a la ´ planta física. El puente autodetecta el ESP32 a partir de identificadores VID/PID de conversores USB-TTL típicos (CH340, CP210x) y ofrece reconexion din ´ amica ´ transparente.
Servicios y Streaming de Video en Tiempo Real: Expone el endpoint /api/list_cameras que escanea y enumera los dispositivos de video opticos co- ´
nectados. Ademas, mediante ´ | | /api/real_camera_

stream, sirve un flujo de video cenital en formato multipart/x-mixed-replace (MJPEG) con tasa constan-
te de 16 FPS. Si la camara real (priorizando ´ | /dev/
video2) se desconecta físicamente, el endpoint dibuja dinamicamente un fotograma de error y entra en bucle ´ de reintento automatico sin colapsar el hilo servidor. ´
E. Procesamiento de Imagen, HSV Red Mask y Trayectoria 3D (web bridge.py)
Para permitir que el brazo robotico f ´ ísico siga trazos hechos a mano alzada en el mundo real, se disenõ un pipeline de ´
vision artificial y reconstrucci ´ | on tridimensional: ´
Deteccion y Homograf ´ | ía del Cilindro: Utilizando
OpenCV, se aísla el cuerpo del cilindro de PETG mediante un filtrado por color en el espacio HSV con una mascarilla cian (rango [75, 30, 30] a [140, 255, 255]). Se calcula su caja delimitadora rectangular para proyectar inversamente y desenrollar geometricamente el cilindro ´ físico en un plano de visualizacion ( ´ Wu×Hu = 512×256 píxeles).
Segmentacion del Trazo Rojo y Zhang-Suen: ´ | Una vez
desenrollada la superficie, se extrae el trazo dibujado a mano. Para ello, se aplica una mascarilla de color **Rojo** en el espacio HSV utilizando una union de rangos ´ duales para abarcar la naturaleza periodica del matiz ´ (Hue): de [0, 50, 40] a [10, 255, 255] (límites inferiores) y de [165, 50, 40] a [180, 255, 255] (límites superiores). La mascara resultante se erosiona para remover ruido de ´ bordes y se procesa mediante el algoritmo vectorizado de Zhang-Suen para reducir el trazo a un espesor unitario manteniendo la topología original.
Reconstruccion y Conversi ´ | on Espacial 3D: ´ | Los píxeles
del esqueleto del trazo rojo se ordenan por vecindad y se simplifican mediante Ramer-Douglas-Peucker (RDP). Finalmente, cada píxel (px, py) se proyecta a coordenadas tridimensionales en milímetros sobre la superficie curva real mediante el mapeo inverso cilíndrico, agregando el
estado de conmutacion del emisor l ´ | aser. ´
F. Orquestacion y Lanzamiento de Simulaci ´ | on (gaze- ´
bo.launch.py)
La configuracion y el inicio coordinado de los nodos de ´ simulacion f ´ ísica en ROS 2 se gestionan mediante un archivo de lanzamiento desarrollado en Python. El flujo secuencial
y la configuracion del entorno se detallan en el C ´ | odigo 4 ´
en el Apendice D. Este orquestador realiza las siguientes ´ operaciones:
Carga y Procesamiento Dinamico de URDF/Xacro: ´ El script utiliza la utilidad xacro.process_file() para interpretar el modelo XML parametrizado. Posteriormente, aplica expresiones regulares para remover los comentarios XML redundantes con el fin de prevenir errores en el parser de ROS 2 y evitar inconsistencias en el plugin de Gazebo.
Gestion | de | Rutas | de | Modelos | de | Gazebo: ´
Actualiza dinamicamente la variable de entorno ´

GAZEBO_MODEL_PATH para incluir el directorio local de mallas STL del brazo, garantizando la carga correcta de las geometrías de visualizacion en Gazebo Classic. ´ Secuenciacion de Nodos mediante Manejo de Even- ´ tos: Para evitar condiciones de carrera donde los controladores articulares intentan enlazarse antes de que el robot exista físicamente en la física del simulador, el script utiliza manejadores de eventos
RegisterEventHandler y OnProcessExit. Esto
fuerza que el controlador de posicion de las articulacio- ´
nes (arm_controller) se lance unicamente despu ´ | es´
de que el robot haya sido instanciado por el nodo
spawn_entity.
G. Modelo Descriptor de la Estructura y Actuadores (arm.urdf.xacro)
El diseno estructural, los l ˜ | ímites de movimiento y la confi-
guracion de hardware de control del gemelo virtual se definen ´ jerarquicamente en un archivo descriptor Xacro, presentado en ´
el Codigo 5 en el Ap ´ | endice E. Este descriptor se estructura a ´
partir de los siguientes elementos clave:
Geometría de Eslabones y Mallas STL: Vincula directamente los archivos STL exportados de CAD (base.stl, link1.stl, etc.) escalados a metros (factor 0,001), definiendo la apariencia visual del robot en el simulador.
Límites y Dinamica de Articulaciones: ´ | | Modela los
límites físicos angulares en radianes equivalentes a los límites de los servomotores físicos del prototipo. Adi-
cionalmente, incluye parametros din ´ | amicos de fricci ´ | on y ´
amortiguamiento (friction y damping) para modelar el rozamiento de las articulaciones en Gazebo.
Integracion con ros2 ´ | control: Declara el elemento
<ros2_control> que mapea las interfaces de comando y de estado (posiciones articulares y velocidades) del resolvedor de física de Gazebo Classic
(gazebo_ros2_control/GazeboSystem), permi-
tiendo la inyeccion directa de se ´ | nales desde el puente ˜
de comunicacion HTTP. Esta declaraci ´ | on se comple- ´
menta en la arquitectura de ROS 2 con el archivo de configuracion´ controllers.yaml, el cual especifica la tasa de actualizacion de los bucles de control ´ a 100 Hz y define un controlador síncrono del tipo
JointGroupPositionController asociado a las
tres articulaciones activas del robot.
H. Automatizacion de Configuraci ´ | on y Compilaci ´ | on (se- ´
tup.sh)

Para simplificar la inicializacion del entorno y garantizar ´ la reproducibilidad de las pruebas, se programo un script de ´
automatizacion en Bash. El funcionamiento y la l ´ | ogica de este ´
script se detallan en el Codigo 6 en el Ap ´ | endice F. Este script ´
realiza las siguientes operaciones secuenciales:
Verificacion del Entorno Aislado: ´ | Comprueba la exis-
tencia del contenedor Distrobox (ros2-humble) y, en caso de no encontrarse activo, lo crea automaticamente ´ instalando una base de Ubuntu 22.04.
Compilacion S ´ íncrona del Workspace: Accede al contenedor, carga las variables de entorno de ROS 2 Humble y compila exclusivamente el paquete
arm_simulation mediante el comando colcon build.
Generacion de Scripts Lanzadores: ´ | | | | | | Escribe y otor-
ga permisos de ejecucion a los tres scripts r ´ | api- ´
dos (launch_gazebo.sh, run_trajectory.sh y
start_ui.sh) en la raíz del proyecto para facilitar el uso diario.
I. Scripts Lanzadores del Entorno y Ejecutables

Para agilizar el flujo de trabajo del operador sin requerir la memorizacion de comandos de contenedor o de ROS 2, ´ se desarrollaron tres scripts lanzadores. Su codigo fuente se ´
presenta en el Codigo 7 en el Ap ´ | endice G. Cada script cumple ´
una funcion espec ´ | ífica dentro de la arquitectura distribuida:
Lanzamiento de Simulacion (launch ´ | gazebo.sh): Lim-
pia la variable de entorno PATH para remover rutas de Conda (previniendo conflictos de interprete de Python ´ con las dependencias de ROS 2), carga los entornos locales y ejecuta el launch de Gazebo.
Generador de Trayectorias (run trajectory.sh): Realiza la misma sanitizacion del entorno y ejecuta directa- ´ mente el nodo controlador de interpolacion cosenoidal. ´
Inicio de la Interfaz Grafica (start ´ | ui.sh): Lanza de
manera asíncrona el navegador predeterminado apuntando a http://localhost:8080 y arranca concurrentemente el puente HTTP/ROS 2 (web_bridge.py) en segundo plano.
J. Firmware | Embebido | del | Microcontrolador | Físico
(main.cpp)

Para el control directo y la coordinacion de los actuadores ´ del prototipo físico, se desarrollo un firmware embebido en ´ C++ ejecutado sobre el microcontrolador ESP32. Su imple-
mentacion completa se detalla en el C ´ | odigo 10 en el Ap ´ | endi- ´
ce H. Las principales funcionalidades de control, decodifica-
cion y seguridad implementadas se describen a continuaci ´ | on: ´
Configuracion | de | Perif ´ | ericos | e | Inicializaci ´ | on´
de Actuadores: El firmware utiliza la biblioteca ESP32Servo reservando tres temporizadores de hardware a una frecuencia de control de 50 Hz para
generar las senales de modulaci ˜ | | | on por ancho de pulso ´
(PWM) destinadas a los servomotores de la base (GPIO 27), hombro (GPIO 14) y codo (GPIO 21). Adicionalmente, el pin GPIO 22 se define como una
salida digital para la conmutacion del emisor l ´ | aser. ´
Decodificacion Bidireccional y Parser de Tramas Dua- ´ les: El firmware en su bucle periodico ‘loop()‘ decodifica ´ tramas provenientes de la interfaz serial UART a una tasa de 115200 bps. El parser soporta dos modos de entrada dinamicos: ´
1. Modo Cartesiano (X:val,Y:val,Z:val): El microcontrolador ejecuta localmente el modelo de cinematica ´ inversa analítico codo-arriba. Si las coordenadas se envían en milímetros (valores absolutos > 2,0), el firmware las escala a metros de forma automatica. ´
2. Modo | Directo | de | Juntas
(J1:val,J2:val,J3:val,L:val): | La | interfaz | web
envía directamente los angulos articulares en ´ grados sexagesimales junto con el estado del laser ´ (‘L:0‘ o ‘L:1‘). El firmware los convierte a radianes y asocia el control de PWM de forma directa.
Conversion Articular y Mapeo PWM de Precisi ´ | on: ´ | La
funcion´ | angleToMicroseconds() toma el angulo ´
articular en radianes, valida y restringe su valor segun´ los límites angulares permitidos (para evitar colisiones destructivas) y realiza el mapeo lineal al ancho de pulso:

tµs = 1500 + θ ·

2000
π

(69)

clampando el resultado estrictamente en la banda de seguridad de [500, 2500] µs.
Algoritmo de Movimiento Gradual Simultaneo (mo- ´ veToTarget): Para evitar picos severos de corriente instantanea debido a la inercia del manipulador (que ´ activarían el circuito de proteccion OCP de la fuente ´ ATX, apagando el ESP32), se programo un perfilador ´ de movimiento gradual. La rutina moveToTarget() interpola linealmente el ancho de pulso de los tres
servos en pasos simultaneos m ´ | aximos de ´ | 15 µs (≈ 1,35◦
)
espaciados por retardos temporales fijos de 15 ms, eliminando los transitorios de corriente daninos. ˜ Watchdog por Software y Parada de Emergencia: Para prevenir incendios o marcas incidentales en la pieza de trabajo por fallos de comunicacion en el lazo de control, se im- ´ plemento un temporizador de watchdog por software. Si ´
transcurren mas de ´ | 1000 ms sin la llegada de comandos
validos, el l ´ | aser se apaga autom ´ | aticamente. Asimismo, ´
ante la trama ‘ESTOP‘ o ‘EMERGENCY‘, la rutina triggerEmergency() realiza el apagado inmediato
del emisor laser y desasocia (‘detach()‘) las se ´ | nales PWM ˜
para liberar la tension en los servomotores. ´
K. Scripts de Validacion Cinem ´ | atica y Alineaci ´ | on de Marcos ´
Con el fin de verificar la correccion del URDF, el ´ | arbol de ´
transformaciones (TF) y las ecuaciones cinematicas antes de ´ operar el hardware, se programaron diversos scripts de prueba en Python:
Prueba | Cinematica | y | Comparaci ´ | on | DH ´
(test kinematics.py): | Compara | analíticamente | dos
formulaciones de Denavit-Hartenberg (una estandar y ´ otra con desfases angulares compensados ϕ2 y ϕ3),
validando la consistencia matematica de la cinem ´ | atica ´
directa. El codigo se detalla en el C ´ | odigo 12 en el ´
Apendice J. ´
Validacion | de | Alineaci ´ | on | TF | en | Gazebo ´
(test tf alignment.py): Se conecta como nodo de

ROS 2 para leer las transformaciones del arbol de TFs ´ en tiempo real de la simulacion activa. Comprueba que ´ en la pose cero de calibracion del robot, todos los ejes ´ longitudinales X de las articulaciones sean coplanares
y paralelos (Angulo Pitch ´ | ≈ 0
- y desviacion lateral ´
Y ≈ 0). Su codigo se presenta en el C ´ | odigo 13 en el ´
Apendice K. ´
Verificacion | Anal ´ | ítica | de | URDF
(test urdf tf alignment.py): | Realiza | un | analisis ´
algebraico de las transformaciones de rotacion RPY ´ declaradas en el modelo descriptor URDF/Xacro, comprobando si los ejes longitudinales X resultan paralelos y horizontales en el plano de movimiento
vertical. Su codigo se detalla en el C ´ | odigo 14 en el ´
Apendice L. ´
Lectura | de | Marcos | de | Referencia | Activos
(get tf distances.py): | Consulta | el | servicio | de
transformaciones de ROS 2 en tiempo real para imprimir las traslaciones y cuaterniones de rotacion´ de cada eslabon con respecto a la base del robot. Su ´
implementacion se muestra en el C ´ | odigo 15 en el ´
Apendice M. ´
Parser | de | Geometría | Xacro
(get gazebo distances.py): Analiza el arbol XML ´ del archivo Xacro descriptor del brazo para extraer
automaticamente los l ´ | ímites físicos, desfases de juntas
y longitudes calculadas de los eslabones moviles. Su ´
codigo se detalla en el C ´ | odigo 16 en el Ap ´ | endice N. ´
VII. SELECCION DE ´ | ACTUADORES Y SENSORES
Para garantizar el exito de la implementaci ´ | on f ´ | ísica y
su congruencia con el entorno de simulacion, se detalla la ´ seleccion de componentes de hardware: ´
A. Actuadores
La arquitectura cinematica de 3 GDL resulta id ´ | onea para ´
este caso de estudio; dado que la herramienta es un haz laser ´ unidireccional colineal con el eje de aproximacion, y el objeti- ´ vo es el corte y grabado sobre superficies cilíndricas, el control del posicionamiento cartesiano en los tres ejes (X, Y, Z) es crítico para compensar la curvatura de la pieza y mantener la distancia focal constante del haz. La omision del control ´
de orientacion redundante (pitch/roll) disminuye dr ´ | | | | asticamente ´
el torque estatico requerido en las articulaciones proximales ´ (base y hombro), lo que mitiga las deflexiones estructurales y maximiza la rigidez y repetibilidad del sistema. El disenõ se complementa ubicando estrategicamente actuadores de baja ´ masa en los eslabones distales para minimizar el tensor de inercia del mecanismo.
Actuador de rotacion principal (Base): ´ | Se implementó
un servomotor de alto torque y engranajes metalicos ´ (MG996R) en la base para accionar el giro del brazo a la izquierda y derecha. Este actuador soporta las cargas dinamicas y el momento de inercia de toda la estructura ´ movil. ´
Actuadores de elevacion (Hombro y Codo): ´ | | | Se utilizó
un servomotor de alto torque MG996R para el hombro (articulacion pegada a la base que hace elevar el brazo) ´ para soportar el peso y los esfuerzos de flexion de ´ los eslabones, y un servomotor de engranajes metalicos ´ MG90S en la articulacion del codo para controlar la ´ elevacion distal. ´
Efector final (Modulo L ´ | aser de estado s ´ | olido): ´ | Consis-
te en un diodo laser de baja potencia con l ´ | | ogica transistor- ´
transistor (TTL) de 5V, el cual es conmutado como
un nivel logico de entrada/salida de prop ´ | osito general ´
(GPIO) o vía PWM desde el ESP32. Esto permite una
activacion s ´ | íncrona y de baja latencia acoplada al perfil
cinematico de la trayectoria, emulando la din ´ | amica de ´
interpolacion de un proceso industrial de corte l ´ | | | aser ´
CNC.
B. Sensores
Potenciometros internos: ´ | Los servomotores ya incluyen
sensores de posicion (potenci ´ | ometros) internamente. Esto ´
mantiene el diseno mec ˜ | anico limpio ya que no se requiere ´
acoplar encoders opticos externos para leer los ´ | angulos de ´
las articulaciones, eliminando la necesidad de cableado para sensores externos de posicion o corriente. ´
Camara f ´ | ísica de monitoreo: Se integra una camara ´
USB externa para la captura y monitoreo del proceso de guiado en tiempo real. Físicamente, el lente de la
camara se ubica fijamente a una distancia de ´ | | | 15 cm
(150 mm) desde el origen del sistema de referencia de la base {0} a lo largo de su eje longitudinal X0, y a una altura de 2,5 cm (25 mm) a lo largo del eje vertical Z0. Esta colocacion r ´ ígida permite obtener una visualizacion´ cenital despejada de la superficie cilíndrica a mecanizar.
C. Especificacion de Componentes ´
En la Tabla III se detallan las especificaciones y funciones de los componentes de hardware seleccionados.

Tabla III
ESPECIFICACIONES DE LOS COMPONENTES DE HARDWARE
Componente | Modelo | Funcion en el Sistema ´
Controlador | ESP32 | Control de bajo nivel y
PWM.
Actuador base | MG996R (1 ud.) | Rotacion | izquier- ´
da/derecha.
Actuador hombro | MG996R (1 ud.) | Elevacion del hombro. ´
Actuador codo | MG90S (1 ud.) | Elevacion del codo. ´
Efector final | Diodo Laser (5V) | Haz de corte de baja po- ´
tencia.
Camara | USB/Monitoreo | Captura visual del cilindro ´
de trabajo.
Estructura | PETG | Piezas impresas en 3D.
Alimentacion | Fuente 5V 5A | Energ ´ | ía para actuadores y
laser. ´
D. Presupuesto de Masa y Dimensiones
En la Tabla IV se detalla la masa y dimensiones físicas estimadas para los diferentes componentes del brazo manipulador.

Tabla IV
PRESUPUESTO DE MASA Y DIMENSIONES DE LOS COMPONENTES
Componente | Masa (g) | Cant. | Dimensiones (mm)
ESP32 NodeMCU | 10 | 1 | 48.0 × 26.0 × 12.0
Servo MG996R | 55 | 2 | 40.7 × 19.7 × 42.9
Servo MG90S | 13.4 | 1 | 22.8 × 12.2 × 28.5
Diodo Laser 5V | 10 | 1 ´ | ϕ 12.0 × 35.0
Estructura 3D (PETG) | 350 | 1 | Envolvente ≈ 250 ×
| | | 150
Fuente 5V 5A | 150 | 1 | 110.0 × 78.0 × 36.0
Cables y tornillería | 50 | 1 | N/A
Masa Total | 693 g | (≈ 0.69 kg)
E. Presupuesto y Consumo de Energía

La Tabla V detalla el voltaje nominal y las corrientes de funcionamiento promedio y de pico para estimar la potencia del sistema.

Tabla V
PRESUPUESTO Y CONSUMO DE ENERGÍA DE LOS COMPONENTES
Componente | Voltaje (V) | Corr. Prom. | Corr. Pico
ESP32 | 5.0 | 120 mA | 240 mA
MG996R (2 ud.) | 5.0 | 1000 mA | 5.0 A
MG90S (1 ud.) | 5.0 | 180 mA | 0.8 A
Laser 5V | 5.0 | 30 mA | 30 mA ´
Consumo Promedio | 1.33 A (≈ 6.7 W)
Consumo Pico | 6.07 A (≈ 30.4 W)
F. Estimacion de Costos ´

El presupuesto estimado para la adquisicion de los compo- ´ nentes de hardware requeridos se presenta en la Tabla VI.

Tabla VI
PRESUPUESTO Y ESTIMACION DE ´ | COSTOS
Descripcion | Cant. | Unit. ´ | (S/.) | Total (S/.)
ESP32 NodeMCU | 1 | 20.00 | 20.00
Servomotor MG996R | 2 | 26.00 | 52.00
Servomotor MG90S | 1 | 8.00 | 8.00
Modulo L ´ | aser 5V | 1 | 3.50 | 3.50 ´
Impresion 3D (Estructura) | 1 | 93.00 | 93.00 ´
Cables y tornillería | - | 10.00 | 10.00
Total Estimado | S/. 186.50
G. Esquema de Conexiones Electricas ´

La integracion f ´ ísica del sistema requiere una arquitectura de alimentacion y control claramente definida. El ESP32 es ´ alimentado directamente por la laptop vía USB, mientras
que los servomotores y el diodo laser reciben su tensi ´ | on de ´
operacion de +5 V desde la fuente de PC. El encendido del ´ laser se gestiona mediante un transistor NPN 2N2222 con ´ resistencia de base de 220 Ω, accionado por el pin GPIO 25 del ESP32. La Fig. 5 muestra el esquema completo de conexiones.

VIII. APLICACION´ INDUSTRIAL

A diferencia de los pantografos y cortadoras l ´ | aser carte- ´
sianas convencionales, los cuales estan limitados a trazar tra- ´ yectorias coplanares bidimensionales (2D) en laminas planas, ´
la configuracion antropom ´ | orfica de 3 GDL permite posicionar ´
la herramienta en un espacio tridimensional (X, Y, Z). Esta característica habilita la aplicacion del robot en procesos ´ industriales de corte y grabado sobre superficies irregulares y no coplanares, tales como el perfilado de cuerpos curvados y el calado de piezas cilíndricas.
En la industria de manufactura mecanica, el procesamiento ´ de piezas no planas requiere realizar cortes y grabados con perfiles tridimensionales complejos (por ejemplo, intersecciones de geometrías cilíndricas o marcas en piezas curvas). Al colocar un haz laser en el efector final del robot, es posible ´ realizar este proceso sin contacto mecanico directo. A partir ´ del modelo de la superficie cilíndrica de una pieza de radio Rtubo colocada de forma horizontal a lo largo del eje Y0 a una distancia xtubo y a una altura de desfase ztubo, la coordenada
vertical de corte zE se calcula dinamicamente en funci ´ | on de ´
la posicion radial ´ | xE:

zE = ztubo +

q
R²
tubo − (xE − xtubo)
2 | (70)

El resolvedor de cinematica inversa desarrollado en (26)- ´
(41) calcula de manera instantanea las posiciones articulares ´ (θ1, θ2, θ3) para que el laser siga esta trayectoria no planar, ´ manteniendo la distancia focal constante respecto a la pared de la pieza. Esto demuestra el valor industrial del manipulador propuesto frente a las soluciones cartesianas convencionales de bajo costo, ampliando el alcance de automatizacion hacia ´ geometrías complejas no convencionales.

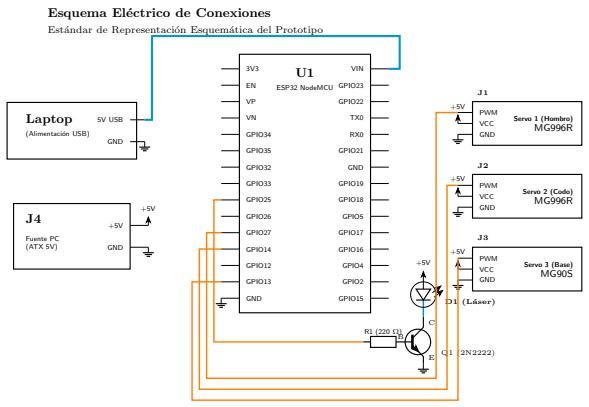
[picture p2: figure]
Laptop; (Alimentación USB); 5V USB; GND; Fuente PC (ATX 5V); ESP32 NodeMCU; GPIO13; GPIO12; GPIO14; GPIO27; GPIO26; GPIO25; GPIO33; GPIO32; GPIO35; GPIO34; GPIO15; GPIO2; GPIO4; GPIO16; GPIO17; GPIO5; GPIO18; GPIO19; GPIO21; GPIO22; GPIO23; VIN; Servo 1 (Hombro) MG996R; PWM VCC GND; Servo 2 (Codo) MG996R; Servo 3 (Base) MG90S; D1 (Láser); Esquema Eléctrico de Conexiones

Estándar de Representación Esquemática del Prototipo

Figura 5. Esquema de conexiones electricas del prototipo. Se detallan las ´ líneas de alimentacion desde la fuente de PC (+5 V y GND) hacia los ´ servomotores Servo 1 (MG996R), Servo 2 (MG996R) y Servo 3 (MG90S), el circuito de control del diodo laser con transistor NPN 2N2222 y resistencia ´
de base de 220 Ω, y la conexion USB de alimentaci ´ | on del ESP32 NodeMCU ´
de 38 pines.

APENDICE ´ | A
CODIGO DEL ´ | RESOLVEDOR DE CINEMATICA ´ | INVERSA EN
| LA INTERFAZ WEB (APP.JS)
1 | function solveIK(x, y, z, customL2) {
2 | const targetX = parseFloat(x);
3 | const targetY = parseFloat(y);
4 | const targetZ = parseFloat(z);
5
6 const currentL2 = (customL2 !== undefined) ? customL2 : L2;
7
8 | if (isNaN(targetX) || isNaN(targetY) || isNaN(targetZ)) {
9 | return { error: ’VALORES_INVALIDOS’, msg: ’Ingresa valores numericos validos.’
};
10 }
11
12 | let r = Math.sqrt(targetX * targetX + targetY * targetY);
13 | if (r < Math.abs(d4)) {
14 | r = Math.abs(d4);
15 | }
16 | const Rp = Math.sqrt(r * r - d4 * d4);
17 | const theta1 = (targetX === 0 && targetY === 0) ? -Math.PI / 2 : Math.atan2(
targetY, targetX) - Math.atan2(-d4, Rp);
18 const j1 = theta1 * 180 / Math.PI;
19
20 | if (j1 < jointsConfig[1].min || j1 > jointsConfig[1].max) {
21 | return { error: ’FUERA DE ALCANCE’, msg: ’Rotacion base J1 fuera de limites
(-165 a 165).’ };
22 }
23
24 | const xc = Rp - a2;
25 | const zc = targetZ - (d1 + d2);
26
27 | const psi_numerator = xc * xc + zc * zc - L1 * L1 - currentL2 * currentL2;
28 | const psi_denominator = 2.0 * L1 * currentL2;
29 | let psi = psi_numerator / psi_denominator;
30
31 | if (psi > 1.0 && psi <= 1.005) {
32 | psi = 1.0;
33 | } else if (psi < -1.0 && psi >= -1.005) {
34 | psi = -1.0;
35 | }
36
37 | if (psi < -1.0 || psi > 1.0) {
38 | return { error: ’FUERA DE ALCANCE’, msg: ’Coordenadas fuera del alcance del
brazo.’ };
39 }
40
41 | const solutions = [-1, 1];
42 | for (let s of solutions) {
43 | const sinTheta3_star = s * Math.sqrt(1.0 - psi * psi);
44 | const theta3_star = Math.atan2(sinTheta3_star, psi);
45
46 | const theta2_star = Math.atan2(zc, xc) - Math.atan2(currentL2 * sinTheta3_star,
L1 + currentL2 * psi);
47
48 | const theta2 = theta2_star;
49 | const theta3 = theta3_star;
50
51 | const j2 = theta2 * 180 / Math.PI;
52 | const j3 = theta3 * 180 / Math.PI;
53
54 | if (j2 >= jointsConfig[2].min && j2 <= jointsConfig[2].max &&
55 | j3 >= jointsConfig[3].min && j3 <= jointsConfig[3].max) {
56 | return { j1, j2, j3 };
57 | }
58 | }
59
60 return { error: ’FUERA DE ALCANCE’, msg: ’Posicion cinematicamente inalcanzable por limites de articulacion.’ };
61 }
Listing 1. Resolvedor interactivo de cinematica inversa en JS (app.js). ´
APENDICE ´ | B
CODIGO DEL ´ | GENERADOR DE TRAYECTORIAS DE
SIMULACION´ (TRAJECTORY GENERATOR.PY)
1 | #!/usr/bin/env python3
2 | import rclpy
3 | from rclpy.node import Node
4 | from std_msgs.msg import Float64MultiArray
5 | import time
6 | import math
7
8 | class TrajectoryGenerator(Node):
9 | def __init__(self):
10 | """
11 | Inicializa el nodo de ROS 2, configura el publicador de comandos de control
| ,
12 | define los keyframes de la secuencia de corte industrial y arranca el
| temporizador de interpolacion.
13 | """
14 | super().__init__(’trajectory_generator’)
15 | self.publisher_ = self.create_publisher(Float64MultiArray, ’/arm_controller
| /commands’, 10)
16
17 | self.rate = 50.0
18 | self.timer = self.create_timer(1.0 / self.rate, self.timer_callback)
19
20 | self.keyframes = [
21 | {"pose": [0.0, 0.0, 0.0], "time": 3.0},
22 | {"pose": [-0.6, 0.4, -0.4], "time": 3.0},
23 | {"pose": [0.6, 0.4, -0.4], "time": 4.0},
24 | {"pose": [0.6, 0.6, -0.7], "time": 2.0},
25 | {"pose": [-0.6, 0.6, -0.7], "time": 4.0},
26 | {"pose": [0.0, 0.0, 0.0], "time": 3.0}
27 | ]
28
29 | self.current_keyframe_idx = 0
30 | self.step_counter = 0
31 | self.total_steps_for_transition = 0
32 | self.start_pose = [0.0, 0.0, 0.0]
33 | self.target_pose = self.keyframes[0]["pose"]
34
35 | self.get_logger().info("Nodo de trayectoria inicializado. Iniciando ciclo
de corte...")
36 | self.prepare_next_transition()
37
38 | def prepare_next_transition(self):
39 | """
40 | Prepara los parametros cinematicos y de interpolacion para la transicion
hacia el
41 | siguiente keyframe de la secuencia, incrementando el indice de trayectoria.
42 | """
43 | self.start_pose = list(self.target_pose)
44 | keyframe = self.keyframes[self.current_keyframe_idx]
45 | self.target_pose = keyframe["pose"]
46 | duration = keyframe["time"]
47
48 | self.total_steps_for_transition = int(duration * self.rate)
49 | self.step_counter = 0
50
51 | self.get_logger().info(
52 | f"Transicionando a Keyframe {self.current_keyframe_idx}: {self.
target_pose} en {duration}s"
53 | )
54
55 | self.current_keyframe_idx = (self.current_keyframe_idx + 1) % len(self.
keyframes)
56
57 | def timer_callback(self):
58 | """
59 | Ejecuta periodicamente la interpolacion cosenoidal (S-curve) entre poses
conjuntas
60 | sucesivas y publica el vector de comandos correspondiente a la tasa del
bucle.
61 | """
62 | if self.step_counter >= self.total_steps_for_transition:
63 | self.prepare_next_transition()
64
65 | t = float(self.step_counter) / float(self.total_steps_for_transition)
66 | smooth_t = (1.0 - math.cos(t * math.pi)) / 2.0
67
68 | current_command = []
69 | for start, target in zip(self.start_pose, self.target_pose):
70 | val = start + (target - start) * smooth_t
71 | current_command.append(val)
72
73 | msg = Float64MultiArray()
74 | msg.data = current_command
75 | self.publisher_.publish(msg)
76
77 | self.step_counter += 1
78
79
80 | def main(args=None):
81 | """
82 | Funcion de entrada que inicializa el entorno de ROS 2, instancia el generador
de trayectoria,
83 | mantiene el ciclo de ejecucion activo y maneja el apagado limpio del nodo.
84 | """
85 | rclpy.init(args=args)
86 | node = TrajectoryGenerator()
87 | try:
88 | rclpy.spin(node)
89 | except KeyboardInterrupt:
90 | node.get_logger().info("Generador de trayectoria detenido por el usuario.")
91 | finally:
92 | node.destroy_node()
93 | rclpy.shutdown()
94
95 | if __name__ == ’__main__’:
96 | main()
Listing 2. Generacion de perfiles S-curve por interpolaci ´ | on cosenoidal ´
y control de keyframes (trajectory generator.py).
APENDICE ´ | C
CODIGO DEL ´ | PUENTE DE COMUNICACION´ ROS 2 -

INTERFAZ WEB (WEB BRIDGE.PY)

1 | def publish_joints(self, j1_deg, j2_deg, j3_deg):
2 | j1_rad = float(j1_deg) * math.pi / 180.0
3 | j2_rad = float(j2_deg) * math.pi / 180.0
4 | j3_rad = float(j3_deg) * math.pi / 180.0
5 | msg = Float64MultiArray()
6 | msg.data = [j1_rad, j2_rad, j3_rad]
7 | self.publisher_.publish(msg)
8 | self.get_logger().info(f’Publicado en ROS -> J1: {j1_rad:.4f} rad, J2: {j2_rad
:.4f} rad, J3: {j3_rad:.4f} rad’)
Listing 3. | Conversion de unidades y env ´ | ío al simulador
(web bridge.py).

APENDICE ´ | D
CODIGO DEL ´ | LANZAMIENTO DE SIMULACION EN ´ | ROS 2
| (GAZEBO.LAUNCH.PY)
1 | import os
2 | from ament_index_python.packages import get_package_share_directory
3 | from launch import LaunchDescription
4 | from launch.actions import IncludeLaunchDescription, RegisterEventHandler
5 | from launch.event_handlers import OnProcessExit
6 | from launch.launch_description_sources import PythonLaunchDescriptionSource
7 | from launch_ros.actions import Node
8 | import xacro
9
10 | def generate_launch_description():
11 | pkg_share = get_package_share_directory(’arm_simulation’)
12 | xacro_file = os.path.join(pkg_share, ’urdf’, ’arm.urdf.xacro’)
13
14 | pkg_share_parent = os.path.dirname(pkg_share)
15 | default_gazebo_models = ’/usr/share/gazebo-11/models:/usr/share/gazebo/models’
16 | if ’GAZEBO_MODEL_PATH’ in os.environ:
17 | os.environ[’GAZEBO_MODEL_PATH’] = pkg_share_parent + ’:’ +
default_gazebo_models + ’:’ + os.environ[’GAZEBO_MODEL_PATH’]
18 | else:
19 | os.environ[’GAZEBO_MODEL_PATH’] = pkg_share_parent + ’:’ +
default_gazebo_models
20
21 | os.environ[’GAZEBO_MODEL_DATABASE_URI’] = ’’
22
23 | import re
24 | robot_description_config = xacro.process_file(xacro_file)
25 | robot_desc = robot_description_config.toxml()
26 | robot_desc = re.sub(r’<!--.*?-->’, ’’, robot_desc, flags=re.DOTALL)
27
28 | robot_state_publisher_node = Node(
29 | package=’robot_state_publisher’,
30 | executable=’robot_state_publisher’,
31 | name=’robot_state_publisher’,
32 | output=’screen’,
33 | parameters=[{’robot_description’: robot_desc, ’use_sim_time’: True}]
34 | )
35
36 | gazebo = IncludeLaunchDescription(
37 | PythonLaunchDescriptionSource([os.path.join(
38 | get_package_share_directory(’gazebo_ros’), ’launch’, ’gazebo.launch.py’
)]),
39 | launch_arguments={’verbose’: ’true’}.items()
40 | )
41
42 | spawn_entity = Node(
43 | package=’gazebo_ros’,
44 | executable=’spawn_entity.py’,
45 | arguments=[’-topic’, ’robot_description’, ’-entity’, ’arm_3gdl’, ’-timeout’
, ’120’],
46 | output=’screen’
47 | )
48
49 | spawn_joint_state_broadcaster = Node(
50 | package="controller_manager",
51 | executable="spawner",
52 | arguments=["joint_state_broadcaster", "--controller-manager", "/
controller_manager"],
53 | output=’screen’
54 | )
55
56 | spawn_arm_controller = Node(
57 | package="controller_manager",
58 | executable="spawner",
59 | arguments=["arm_controller", "--controller-manager", "/controller_manager"
],
60 | output=’screen’
61 | )
62
63 | return LaunchDescription([
64 | gazebo,
65 | robot_state_publisher_node,
66 | spawn_entity,
67 | RegisterEventHandler(
68 | event_handler=OnProcessExit(
69 | target_action=spawn_entity,
70 | on_exit=[spawn_joint_state_broadcaster],
71 | )
72 | ),
73 | RegisterEventHandler(
74 | event_handler=OnProcessExit(
75 | target_action=spawn_joint_state_broadcaster,
76 | on_exit=[spawn_arm_controller],
77 | )
78 | )
79 | ])
Listing 4. | Script de lanzamiento y control secuencial en ROS 2
(gazebo.launch.py).
APENDICE ´ | E
ARCHIVO DE DESCRIPCION´ ESTRUCTURAL Y

ACTUADORES XACRO (ARM.URDF.XACRO)

1 | <?xml version="1.0"?>
2 | <robot xmlns:xacro="http://www.ros.org/wiki/xacro" name="arm_3gdl">
3
4 | <!-- ==================== Materiales de Visualizacion ==================== -->
5 | <material name="abb_orange">
6 | <color rgba="1.0 0.45 0.0 1.0"/>
7 | </material>
8 | <material name="abb_black">
9 | <color rgba="0.12 0.12 0.12 1.0"/>
10 | </material>
11 | <material name="silver">
12 | <color rgba="0.75 0.75 0.75 1.0"/>
13 | </material>
14 | <material name="graphite">
15 | <color rgba="0.25 0.25 0.25 1.0"/>
16 | </material>
17 | <material name="brass">
18 | <color rgba="0.8 0.6 0.2 1.0"/>
19 | </material>
20 | <material name="laser_red">
21 | <color rgba="1.0 0.0 0.0 0.8"/>
22 | </material>
23
24 | <!-- ==================== Base Fija (Mundo) ==================== -->
25 | <link name="world"/>
26 | <joint name="world_to_base" type="fixed">
27 | <parent link="world"/>
28 | <child link="base_link"/>
29 | <origin xyz="0 0 0" rpy="1.57079632679 0 0"/>
30 | </joint>
31
32 | <!-- ==================== Eslabon Base ==================== -->
33 | <link name="base_link">
34 | <inertial>
35 | <mass value="1.0"/>
36 | <origin xyz="0 0 0" rpy="0 0 0"/>
37 | <inertia ixx="0.005" ixy="0.0" ixz="0.0" iyy="0.005" iyz="0.0" izz="0.005"/>
38 | </inertial>
39 | <visual>
40 | <origin xyz="-0.691316 -0.869483 -1.350860" rpy="0 0 0"/>
41 | <geometry>
42 | <mesh filename="package://arm_simulation/meshes/custom_arm/base.stl" scale=
| "0.001 0.001 0.001"/>
43 | </geometry>
44 | <material name="abb_orange"/>
45 | </visual>
46 | </link>
47
48 | <!-- ==================== Articulacion 1 (Rotacion de Base) ====================
| -->
49 | <joint name="joint1" type="revolute">
50 | <origin rpy="-1.57079632679 0 0" xyz="0 0.060 0"/>
51 | <parent link="base_link"/>
52 | <child link="link1"/>
53 | <axis xyz="0 0 1"/>
54 | <limit lower="-2.87979" upper="2.87979" effort="20.0" velocity="1.0"/>
55 | <dynamics damping="1.0" friction="1.0"/>
56 | </joint>
57
58 | <!-- ==================== Eslabon 1 ==================== -->
59 | <link name="link1">
60 | <inertial>
61 | <mass value="0.5"/>
62 | <origin xyz="0 0 0" rpy="0 0 0"/>
63 | <inertia ixx="0.002" ixy="0.0" ixz="0.0" iyy="0.002" iyz="0.0" izz="0.002"/>
64 | </inertial>
65 | <visual>
66 | <origin xyz="-0.691316 1.350860 -0.929483" rpy="1.57079632679 0 0"/>
67 | <geometry>
68 | <mesh filename="package://arm_simulation/meshes/custom_arm/link1.stl" scale
| ="0.001 0.001 0.001"/>
69 | </geometry>
70 | <material name="abb_orange"/>
71 | </visual>
72 | </link>
73
74 | <!-- ==================== Articulacion 2 (Hombro) ==================== -->
75 | <joint name="joint2" type="revolute">
76 | <origin rpy="1.57079632679 0 0" xyz="0.015 0 0.036"/>
77 | <parent link="link1"/>
78 | <child link="link2"/>
79 | <axis xyz="0 0 1"/>
80 | <limit lower="-1.91986" upper="1.91986" effort="25.0" velocity="1.0"/>
81 | <dynamics damping="1.0" friction="1.0"/>
82 | </joint>
83
84 | <!-- ==================== Eslabon 2 ==================== -->
85 | <link name="link2">
86 | <inertial>
87 | <mass value="0.5"/>
88 | <origin xyz="0 0 0" rpy="0 0 0"/>
89 | <inertia ixx="0.002" ixy="0.0" ixz="0.0" iyy="0.002" iyz="0.0" izz="0.002"/>
90 | </inertial>
91 | <visual>
92 | <origin xyz="-0.706231 -0.965655 -1.350860" rpy="0 0 0"/>
93 | <geometry>
94 | <mesh filename="package://arm_simulation/meshes/custom_arm/link2.stl" scale
| ="0.001 0.001 0.001"/>
95 | </geometry>
96 | <material name="abb_orange"/>
97 | </visual>
98 | </link>
99
100 | <!-- ==================== Articulacion 3 (Codo) ==================== -->
101 | <joint name="joint3" type="revolute">
102 | <origin rpy="0 0 0" xyz="0.075158 0.125169 0"/>
103 | <parent link="link2"/>
104 | <child link="link3"/>
105 | <axis xyz="0 0 1"/>
106 | <limit lower="-1.91986" upper="1.22173" effort="20.0" velocity="1.5"/>
107 | <dynamics damping="1.0" friction="1.0"/>
108 | </joint>
109
110 | <!-- ==================== Eslabon 3 ==================== -->
111 | <link name="link3">
112 | <inertial>
113 | <mass value="0.3"/>
114 | <origin xyz="0 0 0" rpy="0 0 0"/>

115 | <inertia ixx="0.001" ixy="0.0" ixz="0.0" iyy="0.001" iyz="0.0" izz="0.001"/>
116 | </inertial>
117 | <visual>
118 | <origin xyz="-0.781487 -1.090987 -1.350860" rpy="0 0 0"/>
119 | <geometry>
120 | <mesh filename="package://arm_simulation/meshes/custom_arm/link3.stl" scale
| ="0.001 0.001 0.001"/>
121 | </geometry>
122 | <material name="abb_orange"/>
123 | </visual>
124 | </link>
125
126 | <!-- ==================== Acoplamiento de Herramienta (Flange y Tool0)
| ==================== -->
127 | <link name="flange"/>
128 | <joint type="fixed" name="joint_3-flange">
129 | <origin xyz="0.158174 -0.030033 -0.007" rpy="0 0 -0.191392"/>
130 | <parent link="link3"/>
131 | <child link="flange"/>
132 | </joint>
133
134 | <link name="tool0"/>
135 | <joint name="flange-tool0" type="fixed">
136 | <origin xyz="0 0 0" rpy="0 1.57079632679 0" />
137 | <parent link="flange" />
138 | <child link="tool0" />
139 | </joint>
140
141 | <!-- ==================== Controladores y Plugins de Gazebo ====================
| -->
142 | <gazebo>
143 | <plugin name="gazebo_ros2_control" filename="libgazebo_ros2_control.so">
144 | <parameters>$(find arm_simulation)/config/controllers.yaml</parameters>
145 | </plugin>
146 | </gazebo>
147
148 | <ros2_control name="GazeboSystem" type="system">
149 | <hardware>
150 | <plugin>gazebo_ros2_control/GazeboSystem</plugin>
151 | </hardware>
152 | <joint name="joint1">
153 | <command_interface name="position">
154 | <param name="min">-2.87979</param>
155 | <param name="max">2.87979</param>
156 | </command_interface>
157 | <state_interface name="position">
158 | <param name="initial_value">0.0</param>
159 | </state_interface>
160 | <state_interface name="velocity"/>
161 | </joint>
162 | <joint name="joint2">
163 | <command_interface name="position">
164 | <param name="min">-1.91986</param>
165 | <param name="max">1.91986</param>
166 | </command_interface>
167 | <state_interface name="position">
168 | <param name="initial_value">0.0</param>
169 | </state_interface>
170 | <state_interface name="velocity"/>
171 | </joint>
172 | <joint name="joint3">
173 | <command_interface name="position">
174 | <param name="min">-1.91986</param>
175 | <param name="max">1.22173</param>
176 | </command_interface>
177 | <state_interface name="position">
178 | <param name="initial_value">0.0</param>
179 | </state_interface>
180 | <state_interface name="velocity"/>
181 | </joint>
182 | </ros2_control>
183
184 | <!-- ==================== Macro para Sistemas de Referencia (RGB)
| ==================== -->
185 | <xacro:macro name="visualize_frame" params="parent prefix xyz:=’0 0 0’ rpy:=’0 0
| 0’ scale:=0.05">
186 | <!-- Eje X (Rojo) -->
187 | <link name="${prefix}_frame_x">
188 | <inertial>
189 | <mass value="0.0001"/>
190 | <origin xyz="0 0 0" rpy="0 0 0"/>
191 | <inertia ixx="1e-9" ixy="0" ixz="0" iyy="1e-9" iyz="0" izz="1e-9"/>
192 | </inertial>
193 | <visual>
194 | <origin xyz="${scale/4} 0 0" rpy="0 1.57079632679 0"/>
195 | <geometry>
196 | <cylinder radius="${scale*0.01}" length="${scale/2}"/>
197 | </geometry>
198 | <material name="red">
199 | <color rgba="1.0 0.0 0.0 0.8"/>
200 | </material>
201 | </visual>
202 | </link>
203 | <joint name="${prefix}_frame_x_joint" type="fixed">
204 | <origin xyz="${xyz}" rpy="${rpy}"/>
205 | <parent link="${parent}"/>
206 | <child link="${prefix}_frame_x"/>
207 | </joint>
208 | <gazebo reference="${prefix}_frame_x">
209 | <material>Gazebo/Red</material>
210 | </gazebo>
211
212 | <!-- Eje Y (Verde) -->
213 | <link name="${prefix}_frame_y">
214 | <inertial>
215 | <mass value="0.0001"/>
216 | <origin xyz="0 0 0" rpy="0 0 0"/>
217 | <inertia ixx="1e-9" ixy="0" ixz="0" iyy="1e-9" iyz="0" izz="1e-9"/>
218 | </inertial>
219 | <visual>
220 | <origin xyz="0 ${scale/4} 0" rpy="-1.57079632679 0 0"/>
221 | <geometry>
222 | <cylinder radius="${scale*0.01}" length="${scale/2}"/>
223 | </geometry>
224 | <material name="green">
225 | <color rgba="0.0 1.0 0.0 0.8"/>
226 | </material>
227 | </visual>
228 | </link>
229 | <joint name="${prefix}_frame_y_joint" type="fixed">
230 | <origin xyz="${xyz}" rpy="${rpy}"/>
231 | <parent link="${parent}"/>
232 | <child link="${prefix}_frame_y"/>
233 | </joint>
234 | <gazebo reference="${prefix}_frame_y">
235 | <material>Gazebo/Green</material>
236 | </gazebo>
237
238 | <!-- Eje Z (Azul) -->
239 | <link name="${prefix}_frame_z">
240 | <inertial>
241 | <mass value="0.0001"/>
242 | <origin xyz="0 0 0" rpy="0 0 0"/>
243 | <inertia ixx="1e-9" ixy="0" ixz="0" iyy="1e-9" iyz="0" izz="1e-9"/>
244 | </inertial>
245 | <visual>
246 | <origin xyz="0 0 ${scale/4}" rpy="0 0 0"/>
247 | <geometry>
248 | <cylinder radius="${scale*0.01}" length="${scale/2}"/>
249 | </geometry>
250 | <material name="blue">
251 | <color rgba="0.0 0.0 1.0 0.8"/>
252 | </material>
253 | </visual>
254 | </link>
255 | <joint name="${prefix}_frame_z_joint" type="fixed">
256 | <origin xyz="${xyz}" rpy="${rpy}"/>
257 | <parent link="${parent}"/>
258 | <child link="${prefix}_frame_z"/>
259 | </joint>
260 | <gazebo reference="${prefix}_frame_z">
261 | <material>Gazebo/Blue</material>
262 | </gazebo>
263 | </xacro:macro>
264
265 | <!-- Instanciacion de los Sistemas de Referencia en cada Articulacion (D-H
| Secuencial) -->
266 | <xacro:visualize_frame parent="base_link" prefix="system0" xyz="0 0 0" rpy="
| -1.57079632679 0 0" scale="0.08"/>
267 | <xacro:visualize_frame parent="link1" prefix="system1" xyz="0 0 0" rpy="0 0 0"
| scale="0.06"/>
268 | <xacro:visualize_frame parent="link2" prefix="system2" xyz="0 0 0" rpy="0 0
| 1.030041" scale="0.06"/>
269 | <xacro:visualize_frame parent="link3" prefix="system3" xyz="0 0 0" rpy="0 0
| -0.191392" scale="0.06"/>
270 | <xacro:visualize_frame parent="flange" prefix="system4" xyz="0 0 0" rpy="0 0 0"
| scale="0.06"/>
271
272 | <!-- ==================== Camara de Monitoreo (Gazebo) ==================== -->
273 | <link name="camera_link">
274 | <inertial>
275 | <mass value="0.1"/>
276 | <origin xyz="0 0 0" rpy="0 0 0"/>
277 | <inertia ixx="1e-4" ixy="0" ixz="0" iyy="1e-4" iyz="0" izz="1e-4"/>
278 | </inertial>
279 | <visual>
280 | <!-- Cuerpo de la camara -->
281 | <origin xyz="0 0 0" rpy="0 0 0"/>
282 | <geometry>
283 | <box size="0.05 0.05 0.05"/>
284 | </geometry>
285 | <material name="graphite"/>
286 | </visual>
287 | <visual>
288 | <!-- Lente de la camara -->
289 | <origin xyz="0.03 0 0" rpy="0 1.57079632679 0"/>
290 | <geometry>
291 | <cylinder radius="0.015" length="0.02"/>
292 | </geometry>
293 | <material name="abb_black"/>
294 | </visual>
295 | </link>
296
297 | <joint name="camera_joint" type="fixed">
298 | <!-- Ubicada sobre el eje X positivo de system0, conectada a base_link para
| evitar fallos de spawn en Gazebo -->
299 | <origin xyz="0.11 0.025 0.0" rpy="-1.57079632679 0 0"/>
300 | <parent link="base_link"/>
301 | <child link="camera_link"/>
302 | </joint>
303
304 | <!-- Plugin de Gazebo para transmitir la imagen en ROS 2 -->
305 | <gazebo reference="camera_link">
306 | <sensor type="camera" name="work_camera">
307 | <update_rate>15.0</update_rate>
308 | <visualize>true</visualize>
309 | <camera name="head">
310 | <horizontal_fov>1.085595</horizontal_fov>
311 | <image>
312 | <width>640</width>
313 | <height>480</height>
314 | <format>R8G8B8</format>
315 | </image>
316 | <clip>
317 | <near>0.05</near>
318 | <far>8.0</far>
319 | </clip>
320 | </camera>
321 | <plugin name="camera_controller" filename="libgazebo_ros_camera.so">
322 | <frame_name>camera_link</frame_name>
323 | </plugin>
324 | </sensor>

325 </gazebo>
326
327 | <!-- Sistemas de referencia de la camara (Base y Lente) -->
328 | <xacro:visualize_frame parent="base_link" prefix="camera_base" xyz="0.11 0.0 0.0"
rpy="-1.57079632679 0 0" scale="0.04"/>
329 <xacro:visualize_frame parent="base_link" prefix="camera_lens" xyz="0.15 0.025 0.0" rpy="-1.57079632679 0 0" scale="0.02"/>
330
331 | </robot>
Listing 5. | Modelado estructural, cinematico y configuraci ´ | on de ´
ros2 control en Xacro (arm.urdf.xacro).
APENDICE ´ | F

SCRIPT DE AUTOMATIZACION DE CONFIGURACION Y
| COMPILACION (SETUP.SH)
1 | #!/bin/bash
2 | set -e
3 | GREEN=’\033[0;32m’
4 | BLUE=’\033[0;34m’
5 | YELLOW=’\033[1;33m’
6 | RED=’\033[0;31m’
7 | NC=’\033[0m’
8
9 | echo -e "${BLUE}===============================================${NC}"
10 | echo -e "${GREEN} | KiraOne - SETUP & COMPILATION SYSTEM | ${NC}"
11 | echo -e "${BLUE}===============================================${NC}"
12
13 | if ! command -v distrobox &> /dev/null; then
14 | echo -e "${RED}Error: distrobox no esta instalado.${NC}"
15 | exit 1
16 | fi
17
18 | echo -e "${BLUE}[1/4] Verificando contenedor Distrobox...${NC}"
19 | if ! distrobox list | grep -q "ros2-humble"; then
20 | distrobox create -n ros2-humble -i ubuntu:22.04 -y
21 | fi
22 | echo -e "${GREEN}[OK] Contenedor ’ros2-humble’ detectado.${NC}"
23
24 | echo -e "${BLUE}[2/4] Compilando Workspace de ROS2...${NC}"
25 | SCRIPT_DIR="$( cd "$( dirname "${BASH_SOURCE[0]}" )" &> /dev/null && pwd )"
26
27 | distrobox enter ros2-humble -- bash -c "
28 | cd ’$SCRIPT_DIR/ros2_ws’ && \
29 | source /opt/ros/humble/setup.bash && \
30 | colcon build --packages-select arm_simulation
31 | "
32 | echo -e "${GREEN}[OK] Workspace compilado exitosamente.${NC}"
33
34 | echo -e "${BLUE}[3/4] Configurando permisos de ejecucion...${NC}"
35 | chmod +x "$SCRIPT_DIR/ros2_ws/src/arm_simulation/scripts/trajectory_generator.py"
36 | echo -e "${GREEN}[OK] Permisos configurados.${NC}"
37
38 | echo -e "${BLUE}[4/4] Generando scripts de ejecucion rapida...${NC}"
39 | # Generacion automatica de launch_gazebo.sh, run_trajectory.sh y start_ui.sh ...
Listing 6. | Script de inicializacion y compilaci ´ | on del entorno ´
(setup.sh).
APENDICE ´ | G
LANZADORES RAPIDOS DE LA ´ | SIMULACION Y DE LA ´

INTERFAZ WEB

1 | #!/bin/bash
2 | SCRIPT_DIR="$( cd "$( dirname "${BASH_SOURCE[0]}" )" &> /dev/null && pwd )"
3 | echo "Iniciando Gazebo Classic (KiraOne)..."
4 | distrobox enter ros2-humble -- bash -c "
5 | export PATH=\$(echo \$PATH | tr ’:’ ’\n’ | grep -v miniconda | tr ’\n’ ’:’)
6 | source /opt/ros/humble/setup.bash
7 | source ’$SCRIPT_DIR/ros2_ws/install/setup.bash’
8 | ros2 launch arm_simulation gazebo.launch.py
9 | "
Listing 7. Script lanzador de Gazebo Classic (launch gazebo.sh).
1 | #!/bin/bash
2 | SCRIPT_DIR="$( cd "$( dirname "${BASH_SOURCE[0]}" )" &> /dev/null && pwd )"
3 | echo "Ejecutando generador de trayectoria (KiraOne)..."
4 | distrobox enter ros2-humble -- bash -c "
5 | export PATH=\$(echo \$PATH | tr ’:’ ’\n’ | grep -v miniconda | tr ’\n’ ’:’)
6 | source /opt/ros/humble/setup.bash
7 | source ’$SCRIPT_DIR/ros2_ws/install/setup.bash’
8 | /usr/bin/python3 ’$SCRIPT_DIR/ros2_ws/src/arm_simulation/scripts/
trajectory_generator.py’
9 | "
Listing | 8. | Script | ejecutor | de | la | trayectoria | cosenoidal
(run trajectory.sh).
1 | #!/bin/bash
2 | SCRIPT_DIR="$( cd "$( dirname "${BASH_SOURCE[0]}" )" &> /dev/null && pwd )"
3 | echo "Iniciando servidor web y puente ROS 2 para KiraOne en http://localhost
| :8080..."
4
5 | if command -v xdg-open &> /dev/null; then
6 | (sleep 1.5 && xdg-open "http://localhost:8080") &
7 | elif command -v sensible-browser &> /dev/null; then
8 | (sleep 1.5 && sensible-browser "http://localhost:8080") &
9 | fi
10
11 | distrobox enter ros2-humble -- bash -c "
12 | export PATH=\$(echo \$PATH | tr ’:’ ’\n’ | grep -v miniconda | tr ’\n’ ’:’)
13 | source /opt/ros/humble/setup.bash
14 | source ’$SCRIPT_DIR/ros2_ws/install/setup.bash’
15 | python3 ’$SCRIPT_DIR/ui/web_bridge.py’
16 | "
Listing 9. Script de inicio del servidor y de la interfaz de control (start ui.sh).
APENDICE ´ | H
CODIGO DEL ´ | FIRMWARE DE CONTROL DE BAJO NIVEL Y
LASER EN EL ´ | ESP32 (MAIN.CPP)
1 | #include <Arduino.h>
2 | #include <ESP32Servo.h>
3 | #include <math.h>
4
5 | #define SERVO_BASE_PIN | 27
6 | #define SERVO_SHOULDER_PIN 14
7 | #define SERVO_ELBOW_PIN | 21
8 | #define LASER_PIN | 22
9
10 | // Constantes fisicas del brazo (metros)
11 | const float L0 = 0.096f;
12 | const float L1 = 0.146f;
13 | const float L2 = 0.161f;
14
15 | // Limites de las articulaciones (radianes)
16 | const float MIN_THETA1 = -1.5708f; // -90 grados
17 | const float MAX_THETA1 = | 1.5708f; // +90 grados
18 | const float MIN_THETA2 = -0.1745f; // -10 grados
19 | const float MAX_THETA2 = | 1.5708f; // +90 grados
20 | const float MIN_THETA3 = -2.0944f; // -120 grados
21 | const float MAX_THETA3 = | 0.1745f; // +10 grados
22
23 const unsigned long SERIAL_TIMEOUT_MS = 1000; 24
25 | Servo servoBase;
26 | Servo servoShoulder;
27 | Servo servoElbow;
28
29 | // Variables de estado (microsegundos correspondientes a la posicion del servo)
30 | int currentBaseUs = 1500;
31 | int currentShoulderUs = 1500;
32 | int currentElbowUs = 1500;
33
34 | unsigned long lastPacketTime = 0;
35 | bool isEmergency = false;
36
37 | /*
38 | * Convierte un angulo articular en radianes al correspondiente ancho de pulso PWM
| en microsegundos,
39 | * limitando el resultado entre los margenes fisicos y de seguridad del servomotor.
40 | */
41 | int angleToMicroseconds(float angle_rad, float min_rad, float max_rad) {
42 | float clamped = constrain(angle_rad, min_rad, max_rad);
43 | float us = 1500.0f + clamped * (2000.0f / PI);
44 | return constrain((int)us, 500, 2500);
45 | }
46
47 | /*
48 | * Resuelve analiticamente el modelo cinematico inverso para un brazo de 3 GDL bajo
49 | * la configuracion geometrica de codo arriba a partir de una posicion cartesiana (
| x, y, z).
50 | */
51 | bool solveInverseKinematics(float x, float y, float z, float &t1, float &t2, float
| &t3) {
52 | t1 = atan2(y, x);
53
54 | float r = sqrt(x * x + y * y);
55 | float z_prime = z - L0;
56
57 | float psi_numerator = x * x + y * y + z_prime * z_prime - L1 * L1 - L2 * L2;
58 | float psi_denominator = 2.0f * L1 * L2;
59 | float psi = psi_numerator / psi_denominator;
60
61 | if (psi < -1.0f || psi > 1.0f) {
62 | return false;
63 | }
64
65 t3 = atan2(-sqrt(1.0f - psi * psi), psi);
66
67 t2 = atan2(z_prime, r) - atan2(L2 * sin(t3), L1 + L2 * cos(t3)); 68
69 | return true;
70 | }
71
72 | /*
73 | * Activa de forma inmediata el estado de emergencia, apaga el emisor laser de
| corte
74 | * y desacopla la senal de los servomotores para liberar la tension de la
| estructura.
75 | */
76 | void triggerEmergency(const char* reason) {
77 | isEmergency = true;
78 | digitalWrite(LASER_PIN, LOW);
79
80 | servoBase.detach();
81 | servoShoulder.detach();
82 | servoElbow.detach();
83
84 | Serial.print("\n=== PARADA DE EMERGENCIA ACTIVA ===\nMotivo: ");
85 | Serial.println(reason);

86 | Serial.println("Reinicie el ESP32 para reestablecer el sistema.");
87 | }
88
89 | /*
90 | * Mueve todos los servos gradualmente en pasos simultaneos para evitar picos de
| corriente
91 | * bruscos que provoquen el apagado o proteccion de la fuente de alimentacion ATX.
92 | */
93 | void moveToTarget(int targetBaseUs, int targetShoulderUs, int targetElbowUs, int
| stepUs = 15, int stepDelay = 15) {
94 | bool baseMoving = true;
95 | bool shoulderMoving = true;
96 | bool elbowMoving = true;
97
98 | while (baseMoving || shoulderMoving || elbowMoving) {
99 | if (isEmergency) {
100 | return;
101 | }
102
103 | // Alimentar el temporizador del watchdog de seguridad durante el recorrido
104 | lastPacketTime = millis();
105
106 | baseMoving = (currentBaseUs != targetBaseUs);
107 | shoulderMoving = (currentShoulderUs != targetShoulderUs);
108 | elbowMoving = (currentElbowUs != targetElbowUs);
109
110 | if (baseMoving) {
111 | if (abs(targetBaseUs - currentBaseUs) <= stepUs) {
112 | currentBaseUs = targetBaseUs;
113 | } else {
114 | currentBaseUs += (targetBaseUs > currentBaseUs) ? stepUs : -stepUs;
115 | }
116 | servoBase.writeMicroseconds(currentBaseUs);
117 | }
118
119 | if (shoulderMoving) {
120 | if (abs(targetShoulderUs - currentShoulderUs) <= stepUs) {
121 | currentShoulderUs = targetShoulderUs;
122 | } else {
123 | currentShoulderUs += (targetShoulderUs > currentShoulderUs) ? stepUs : -
| stepUs;
124 | }
125 | servoShoulder.writeMicroseconds(currentShoulderUs);
126 | }
127
128 | if (elbowMoving) {
129 | if (abs(targetElbowUs - currentElbowUs) <= stepUs) {
130 | currentElbowUs = targetElbowUs;
131 | } else {
132 | currentElbowUs += (targetElbowUs > currentElbowUs) ? stepUs : -stepUs;
133 | }
134 | servoElbow.writeMicroseconds(currentElbowUs);
135 | }
136
137 | if (baseMoving || shoulderMoving || elbowMoving) {
138 | delay(stepDelay);
139 | }
140 | }
141 | }
142
143 | void setup() {
144 | Serial.begin(115200);
145 | delay(500);
146 | Serial.println("\n=== ESP32 3-GDL Laser Arm Controller (Gradual Move) ===");
147
148 | pinMode(LASER_PIN, OUTPUT);
149 | digitalWrite(LASER_PIN, LOW);
150
151 | ESP32PWM::allocateTimer(0);
152 | ESP32PWM::allocateTimer(1);
153 | ESP32PWM::allocateTimer(2);
154
155 | servoBase.setPeriodHertz(50);
156 | servoShoulder.setPeriodHertz(50);
157 | servoElbow.setPeriodHertz(50);
158
159 | // Inicializar servos y asociar pines
160 | servoBase.attach(SERVO_BASE_PIN, 500, 2500);
161 | servoShoulder.attach(SERVO_SHOULDER_PIN, 500, 2500);
162 | servoElbow.attach(SERVO_ELBOW_PIN, 500, 2500);
163
164 | // Establecer posicion central por defecto al encender
165 | servoBase.writeMicroseconds(currentBaseUs);
166 | servoShoulder.writeMicroseconds(currentShoulderUs);
167 | servoElbow.writeMicroseconds(currentElbowUs);
168
169 | lastPacketTime = millis();
170 | Serial.println("Sistema listo. Esperando comandos seriales (ej: X:0.2,Y:0.0,Z
| :0.25 o X:120,Y:0,Z:100)...");
171 | }
172
173 | void loop() {
174 | if (isEmergency) {
175 | digitalWrite(LASER_PIN, LOW);
176 | delay(100);
177 | return;
178 | }
179
180 | // Watchdog de seguridad: apaga el laser si se pierde la comunicacion serial
181 | if (millis() - lastPacketTime > SERIAL_TIMEOUT_MS) {
182 | digitalWrite(LASER_PIN, LOW);
183 | }
184
185 | if (Serial.available() > 0) {
186 | String line = Serial.readStringUntil(’\n’);
187 | line.trim();
188
189 | if (line.length() > 0) {
190 | // Comando manual para parada de emergencia
191 | if (line.equalsIgnoreCase("ESTOP") || line.equalsIgnoreCase("EMERGENCY")) {
192 | triggerEmergency("Comando manual recibido");
193 | return;
194 | }
195
196 | int idxJ1 = line.indexOf("J1:");
197 | int idxJ2 = line.indexOf("J2:");
198 | int idxJ3 = line.indexOf("J3:");
199 | int idxL | = line.indexOf(",L:");
200
201 | int idxX = line.indexOf("X:");
202 | int idxY = line.indexOf("Y:");
203 | int idxZ = line.indexOf("Z:");
204
205 | if (idxJ1 != -1 && idxJ2 != -1 && idxJ3 != -1) {
206 | int endJ1 = line.indexOf(’,’, idxJ1);
207 | int endJ2 = line.indexOf(’,’, idxJ2);
208 | int endJ3 = (idxL != -1) ? idxL : line.length();
209
210 | String j1Str = line.substring(idxJ1 + 3, endJ1 != -1 ? endJ1 : line.length
| ());
211 | String j2Str = line.substring(idxJ2 + 3, endJ2 != -1 ? endJ2 : line.length
| ());
212 | String j3Str = line.substring(idxJ3 + 3, endJ3 != -1 ? endJ3 : line.length
| ());
213
214 | float j1_deg = j1Str.toFloat();
215 | float j2_deg = j2Str.toFloat();
216 | float j3_deg = j3Str.toFloat();
217
218 | bool laserVal = false;
219 | if (idxL != -1) {
220 | String lStr = line.substring(idxL + 3);
221 | laserVal = (lStr.toInt() > 0);
222 | }
223
224 | float theta1 = j1_deg * PI / 180.0f;
225 | float theta2 = j2_deg * PI / 180.0f;
226 | float theta3 = j3_deg * PI / 180.0f;
227
228 | int base_us = angleToMicroseconds(theta1, MIN_THETA1, MAX_THETA1);
229 | int shoulder_us = angleToMicroseconds(theta2, MIN_THETA2, MAX_THETA2);
230 | int elbow_us = angleToMicroseconds(theta3, MIN_THETA3, MAX_THETA3);
231
232 | lastPacketTime = millis();
233 | if (laserVal) {
234 | digitalWrite(LASER_PIN, HIGH);
235 | } else {
236 | digitalWrite(LASER_PIN, LOW);
237 | }
238
239 | moveToTarget(base_us, shoulder_us, elbow_us);
240
241 | Serial.print("OK | Joints set: J1=");
242 | Serial.print(j1_deg, 1);
243 | Serial.print(" J2=");
244 | Serial.print(j2_deg, 1);
245 | Serial.print(" J3=");
246 | Serial.print(j3_deg, 1);
247 | Serial.print(" | Laser=");
248 | Serial.println(laserVal ? "ON" : "OFF");
249 | } else if (idxX != -1 && idxY != -1 && idxZ != -1) {
250 | int endX = line.indexOf(’,’, idxX);
251 | int endY = line.indexOf(’,’, idxY);
252 | int endZ = line.length();
253
254 | String xStr = line.substring(idxX + 2, endX != -1 ? endX : line.length());
255 | String yStr = line.substring(idxY + 2, endY != -1 ? endY : line.length());
256 | String zStr = line.substring(idxZ + 2, endZ);
257
258 | float raw_x = xStr.toFloat();
259 | float raw_y = yStr.toFloat();
260 | float raw_z = zStr.toFloat();
261
262 | float scale = 1.0f;
263 | if (abs(raw_x) > 2.0f || abs(raw_y) > 2.0f || abs(raw_z) > 2.0f) {
264 | scale = 0.001f;
265 | }
266
267 | float x = raw_x * scale;
268 | float y = raw_y * scale;
269 | float z = raw_z * scale;
270
271 | float theta1 = 0.0f, theta2 = 0.0f, theta3 = 0.0f;
272 | if (solveInverseKinematics(x, y, z, theta1, theta2, theta3)) {
273 | lastPacketTime = millis();
274 | digitalWrite(LASER_PIN, HIGH);
275
276 | int base_us = angleToMicroseconds(theta1, MIN_THETA1, MAX_THETA1);
277 | int shoulder_us = angleToMicroseconds(theta2, MIN_THETA2, MAX_THETA2);
278 | int elbow_us = angleToMicroseconds(theta3, MIN_THETA3, MAX_THETA3);
279
280 | // Movimiento de servos en pasos graduales suaves
281 | moveToTarget(base_us, shoulder_us, elbow_us);
282
283 | Serial.print("OK | Target: X=");
284 | Serial.print(x, 4);
285 | Serial.print(" Y=");
286 | Serial.print(y, 4);
287 | Serial.print(" Z=");
288 | Serial.print(z, 4);
289 | Serial.print(" | Joints: T1=");
290 | Serial.print(theta1 * 180.0f / PI, 1);
291 | Serial.print(" T2=");
292 | Serial.print(theta2 * 180.0f / PI, 1);
293 | Serial.print(" T3=");
294 | Serial.println(theta3 * 180.0f / PI, 1);
295 | } else {
296 | Serial.println("ERR: Posicion cartesiana fuera del area de alcance.");
297 | }
298 | } else {
299 | Serial.println("WARN: Formato invalido. Use ’X:val,Y:val,Z:val’");
300 | }

301 | }
302 | }
303 | }
Listing 10. Firmware embebido en C++ para control de servomotores
y conmutacion l ´ | aser en el ESP32 (main.cpp). ´
APENDICE ´ | I
CODIGO DEL ´ | ALGORITMO DE ADELGAZAMIENTO

ZHANG-SUEN (WEB BRIDGE.PY)

1 | def zhang_suen_thinning(img):
2 | import numpy as np
3 | im = (img > 0).astype(np.uint8)
4 | im = np.pad(im, 1, mode=’constant’, constant_values=0)
5
6 | while True:
7 | # Paso 1
8 | p2 = im[:-2, 1:-1]
9 | p3 = im[:-2, 2:]
10 | p4 = im[1:-1, 2:]
11 | p5 = im[2:, 2:]
12 | p6 = im[2:, 1:-1]
13 | p7 = im[2:, :-2]
14 | p8 = im[1:-1, :-2]
15 | p9 = im[:-2, :-2]
16
17 | B = p2 + p3 + p4 + p5 + p6 + p7 + p8 + p9
18
19 | A = ((p2 == 0) & (p3 == 1)).astype(np.uint8) + \
20 | ((p3 == 0) & (p4 == 1)).astype(np.uint8) + \
21 | ((p4 == 0) & (p5 == 1)).astype(np.uint8) + \
22 | ((p5 == 0) & (p6 == 1)).astype(np.uint8) + \
23 | ((p6 == 0) & (p7 == 1)).astype(np.uint8) + \
24 | ((p7 == 0) & (p8 == 1)).astype(np.uint8) + \
25 | ((p8 == 0) & (p9 == 1)).astype(np.uint8) + \
26 | ((p9 == 0) & (p2 == 1)).astype(np.uint8)
27
28 | cond1 = (B >= 2) & (B <= 6) & (A == 1) & (p2 * p4 * p6 == 0) & (p4 * p6 *
p8 == 0)
29 | inner = im[1:-1, 1:-1]
30 | to_delete_1 = (inner == 1) & cond1
31
32 | im[1:-1, 1:-1] = np.where(to_delete_1, 0, inner)
33
34 | # Paso 2
35 | p2 = im[:-2, 1:-1]
36 | p3 = im[:-2, 2:]
37 | p4 = im[1:-1, 2:]
38 | p5 = im[2:, 2:]
39 | p6 = im[2:, 1:-1]
40 | p7 = im[2:, :-2]
41 | p8 = im[1:-1, :-2]
42 | p9 = im[:-2, :-2]
43
44 | B = p2 + p3 + p4 + p5 + p6 + p7 + p8 + p9
45 | A = ((p2 == 0) & (p3 == 1)).astype(np.uint8) + \
46 | ((p3 == 0) & (p4 == 1)).astype(np.uint8) + \
47 | ((p4 == 0) & (p5 == 1)).astype(np.uint8) + \
48 | ((p5 == 0) & (p6 == 1)).astype(np.uint8) + \
49 | ((p6 == 0) & (p7 == 1)).astype(np.uint8) + \
50 | ((p7 == 0) & (p8 == 1)).astype(np.uint8) + \
51 | ((p8 == 0) & (p9 == 1)).astype(np.uint8) + \
52 | ((p9 == 0) & (p2 == 1)).astype(np.uint8)
53
54 | cond2 = (B >= 2) & (B <= 6) & (A == 1) & (p2 * p4 * p8 == 0) & (p2 * p6 *
p8 == 0)
55 | inner = im[1:-1, 1:-1]
56 | to_delete_2 = (inner == 1) & cond2
57
58 | im[1:-1, 1:-1] = np.where(to_delete_2, 0, inner)
59
60 | if not np.any(to_delete_1) and not np.any(to_delete_2):
61 | break
62
63 | return (im[1:-1, 1:-1] * 255).astype(np.uint8)
Listing 11. Algoritmo de esqueletizacion vectorizada de Zhang-Suen ´ (web bridge.py).
APENDICE ´ | J
CODIGO DE ´ | VERIFICACION´ CINEMATICA Y ´ | DH
| (TEST KINEMATICS.PY)
1 | import numpy as np
2
3 | # Constantes del robot
4 | d1 = 60.0
5 | d2 = 36.0
6 | a2 = 15.0
7 | a3 = 146.0
8 | a4 = 161.0
9 | d4 = -7.0
10
11 | phi2 = 1.030041
12 | phi3 = -0.191392
13
14 | def dh_matrix(theta, d, a, alpha):
15 | alpha_rad = np.radians(alpha) if isinstance(alpha, (int, float)) else alpha
16 | return np.array([
17 | [np.cos(theta), -np.sin(theta)*np.cos(alpha_rad), | np.sin(theta)*np.sin(
| alpha_rad), a*np.cos(theta)],
18 | [np.sin(theta), | np.cos(theta)*np.cos(alpha_rad), -np.cos(theta)*np.sin(
alpha_rad), a*np.sin(theta)],
19 | [0, | np.sin(alpha_rad), | np.cos(alpha_rad),
d],
20 | [0, | 0, | 0,
1]
21 | ])
22
23 | def fk_dh(theta1, theta2, theta3):
24 | theta2_star = theta2 + phi2
25 | theta3_star = theta3 + phi3 - phi2
26
27 | T1 = dh_matrix(theta1, d1 + d2, a2, 90)
28 | T2 = dh_matrix(theta2_star, 0, a3, 0)
29 | T3 = dh_matrix(theta3_star, d4, a4, 0)
30
31 | T = T1 @ T2 @ T3
32 | return T
33
34 | def fk_analytical(theta1, theta2, theta3):
35 | theta2_star = theta2 + phi2
36 | theta3_star = theta3 + phi3 - phi2
37
38 | x_plane = a2 + a3 * np.cos(theta2_star) + a4 * np.cos(theta2_star + theta3_star
)
39 | z_plane = d1 + d2 + a3 * np.sin(theta2_star) + a4 * np.sin(theta2_star +
| theta3_star)
40
41 | x = x_plane * np.cos(theta1) + d4 * np.sin(theta1)
42 | y = x_plane * np.sin(theta1) - d4 * np.cos(theta1)
43 | z = z_plane
44 | return np.array([x, y, z])
45
46 | # Probar con angulos cero
47 | t1, t2, t3 = 0.0, 0.0, 0.0
48 | T_dh = fk_dh(t1, t2, t3)
49 | pos_dh = T_dh[:3, 3]
50 | pos_analyt = fk_analytical(t1, t2, t3)
51
52 | print("D-H End Effector Position (3 matrices):")
53 | print(pos_dh)
54 | print("\nAnalytical End Effector Position:")
55 | print(pos_analyt)
Listing 12. Comparacion de modelos de cinem ´ | atica directa y Denavit- ´
Hartenberg (test kinematics.py).
| APENDICE ´ | K
CODIGO DE ´ | VALIDACION DE ´ | ALINEACION DE ´ | MARCOS TF

(TEST TF ALIGNMENT.PY)

1 | #!/usr/bin/env python3
2 | import rclpy
3 | from rclpy.node import Node
4 | import tf2_ros
5 | import math
6 | import numpy as np
7
8 | class TFAlignmentValidator(Node):
9 | def __init__(self):
10 | super().__init__(’tf_alignment_validator’)
11 | self.tf_buffer = tf2_ros.Buffer()
12 | self.tf_listener = tf2_ros.TransformListener(self.tf_buffer, self)
13
14 | # Esperar un poco a que se llene el buffer de TFs
15 | self.timer = self.create_timer(1.0, self.validate_alignment)
16 | self.get_logger().info("Validator node started. Waiting for TF data...")
17
18 | def validate_alignment(self):
19 | self.timer.cancel()
20
21 | frames = [’system1’, ’system2’, ’system3’, ’flange’]
22 | base_frame = ’link1’
23
24 | print("\n" + "="*70)
25 | print(" VALIDACION DE ALINEACION DE EJES X (VISTA LATERAL / PLANO X-Z de
link1)")
26 | print("="*70)
27
28 | all_parallel = True
29
30 | for frame in frames:
31 | try:
32 | # Obtener la transformacion de link1 al sistema
33 | now = rclpy.time.Time()
34 | trans = self.tf_buffer.lookup_transform(base_frame, frame, now,
timeout=rclpy.duration.Duration(seconds=2.0))
35
36 | # Obtener cuaternion
37 | q = trans.transform.rotation
38
39 | # Convertir cuaternion a matriz de rotacion
40 | R = self.quaternion_to_matrix(q.x, q.y, q.z, q.w)
41
42 | # El eje X del frame en coordenadas de link1 es la primera columna
de R
43 | x_axis = R[:, 0]
44
45 | # Calcular angulo en el plano vertical X-Z de link1
46 | angle_rad = math.atan2(x_axis[2], x_axis[0])
47 | angle_deg = math.degrees(angle_rad)
48
49 | print(f"\nFrame: {frame}")
50 | print(f" | Vector eje X (en frame link1): [{x_axis[0]:.6f}, {x_axis
[1]:.6f}, {x_axis[2]:.6f}]")

51 | print(f" | Desviacion lateral (Y): {x_axis[1]:.6f} (debe ser aprox
0)")
52 | print(f" | Angulo en plano X-Z (Pitch): {angle_deg:.4f} deg")
53
54 | if abs(x_axis[1]) > 0.005:
55 | print(" | [WARN] ADVERTENCIA: El eje X no esta en el mismo plano
de movimiento (Y != 0)")
56 | all_parallel = False
57 | elif abs(angle_deg) > 0.1:
58 | print(f" | [WARN] ADVERTENCIA: El eje X no es paralelo al eje X
horizontal (Angulo = {angle_deg:.4f} deg)")
59 | all_parallel = False
60 | else:
61 | print(" | [OK] ALINEACION PERFECTA (eje X paralelo y horizontal)
")
62
63 | except Exception as e:
64 | self.get_logger().error(f"No se pudo obtener la transformacion para
{frame}: {str(e)}")
65 | all_parallel = False
66
67 | print("\n" + "="*70)
68 | if all_parallel:
69 | print(" RESULTADO FINAL: [OK] TODOS LOS EJES X SON PARALELOS Y
HORIZONTALES!")
70 | print(" El brazo esta perfectamente recto y alineado en la pose cero de
la simulacion.")
71 | else:
72 | print(" RESULTADO FINAL: [ERR] EXISTEN DESALINEACIONES O DESVIACIONES
FUERA DE LIMITES.")
73 | print("="*70 + "\n")
74
75 | rclpy.shutdown()
76
77 | def quaternion_to_matrix(self, x, y, z, w):
78 | return np.array([
79 | [1 - 2*(y**2 + z**2), 2*(x*y - w*z), 2*(x*z + w*y)],
80 | [2*(x*y + w*z), 1 - 2*(x**2 + z**2), 2*(y*z - w*x)],
81 | [2*(x*z - w*y), 2*(y*z + w*x), 1 - 2*(x**2 + y**2)]
82 | ])
83
84 | def main(args=None):
85 | rclpy.init(args=args)
86 | node = TFAlignmentValidator()
87 | try:
88 | rclpy.spin(node)
89 | except SystemExit:
90 | pass
91
92 | if __name__ == ’__main__’:
93 | main()
Listing 13. Validacion de paralelismo de ejes longitudinales en base ´
al arbol de transformadas TF (test ´ | tf alignment.py).
APENDICE ´ | L
CODIGO DE ´ | VERIFICACION´ ANALÍTICA DE URDF

(TEST URDF TF ALIGNMENT.PY)

1 | #!/usr/bin/env python3
2 | import math
3 | import numpy as np
4
5 | def rpy_to_matrix(r, p, y):
6 | cr, sr = math.cos(r), math.sin(r)
7 | cp, sp = math.cos(p), math.sin(p)
8 | cy, sy = math.cos(y), math.sin(y)
9
10 | Rx = np.array([[1, 0, 0], [0, cr, -sr], [0, sr, cr]])
11 | Ry = np.array([[cp, 0, sp], [0, 1, 0], [-sp, 0, cp]])
12 | Rz = np.array([[cy, -sy, 0], [sy, cy, 0], [0, 0, 1]])
13
14 | return Rz @ Ry @ Rx
15
16 | # Datos de origen de las articulaciones de la simulacion (URDF actual)
17 | R_w_base = rpy_to_matrix(1.57079632679, 0, 0)
18 | R_base_l1 = rpy_to_matrix(-1.57079632679, 0, 0)
19 | R_l1_l2 = rpy_to_matrix(1.57079632679, 0, 0)
20 | R_l2_l3 = rpy_to_matrix(0, 0, 0)
21 | R_l3_flange = rpy_to_matrix(0, 0, 0)
22
23 | # Marcos de referencia visuales (visualize_frame) en el URDF actual
24 | R_base_sys0 = rpy_to_matrix(-1.57079632679, 0, 0)
25 | R_l2_sys1 = rpy_to_matrix(0, 0, 0)
26 | R_l3_sys2 = rpy_to_matrix(0, 0, 0)
27 | R_flange_sys3 = rpy_to_matrix(0, 0, 0)
28
29 | transforms = {
30 | "system1": R_l1_l2 @ R_l2_sys1,
31 | "system2": R_l1_l2 @ R_l2_l3 @ R_l3_sys2,
32 | "system3": R_l1_l2 @ R_l2_l3 @ R_l3_flange @ R_flange_sys3,
33 | "flange": R_l1_l2 @ R_l2_l3 @ R_l3_flange
34 | }
35
36 | print("\n" + "="*75)
37 | print(" CALCULO ANALITICO DE ALINEACION DE EJES X (DESDE LA SIMULACION URDF)")
38 | print(" Plano de referencia: vista lateral (plano X-Z de link1)")
39 | print("="*75)
40
41 all_parallel = True
42
43 | for name, R_l1_S in transforms.items():
44 | x_axis_in_l1 = R_l1_S[:, 0]
45 | y_deviation = x_axis_in_l1[1]
46 | angle_rad = math.atan2(x_axis_in_l1[2], x_axis_in_l1[0])
47 | angle_deg = math.degrees(angle_rad)

48
49 | print(f"\nSistema: {name}")
50 | print(f" | Direccion del eje X en link1: [{x_axis_in_l1[0]:.6f}, {x_axis_in_l1
[1]:.6f}, {x_axis_in_l1[2]:.6f}]")
51 | print(f" | Desviacion lateral (Y): {y_deviation:.6f} (debe ser 0 para estar
coplanar)")
52 | print(f" | Angulo lateral (Pitch): {angle_deg:.4f} deg (debe ser 0 deg para
estar horizontal)")
53
54 | if abs(y_deviation) > 1e-5:
55 | print(" | [ERR] ERROR: El eje X se sale del plano vertical (desviacion Y no
es cero).")
56 | all_parallel = False
57 | elif abs(angle_deg) > 1e-5:
58 | print(f" | [ERR] ERROR: El eje X no es horizontal en la vista lateral (
Angulo = {angle_deg:.4f} deg).")
59 | all_parallel = False
60 | else:
61 | print(" | [OK] PERFECTO: El eje X es coplanar, paralelo y horizontal.")
62
63 | print("\n" + "="*75)
64 | if all_parallel:
65 | print(" VERIFICACION EXITOSA: [OK] TODOS LOS EJES X SON PARALELOS Y
PERFECTAMENTE ALINEADOS!")
66 | else:
67 | print(" VERIFICACION FALLIDA: [ERR] Existen desalineaciones entre los marcos.")
68 | print("="*75 + "\n")
Listing 14. Verificacion anal ´ | ítica de la rotacion y coplanaridad de las ´
articulaciones en el modelo URDF (test urdf tf alignment.py).
APENDICE ´ | M
CODIGO DE ´ | LECTURA DE DISTANCIAS DE MARCOS TF EN

GAZEBO (GET TF DISTANCES.PY)

1 | #!/usr/bin/env python3
2 | import rclpy
3 | from rclpy.node import Node
4 | import tf2_ros
5 | import sys
6
7 | class TFEchoAll(Node):
8 | def __init__(self):
9 | super().__init__(’tf_echo_all’)
10 | self.tf_buffer = tf2_ros.Buffer()
11 | self.tf_listener = tf2_ros.TransformListener(self.tf_buffer, self)
12 | self.timer = self.create_timer(1.0, self.query_all_tfs)
13 | self.run_once = False
14
15 | def query_all_tfs(self):
16 | if self.run_once:
17 | return
18
19 | frames = [’link1’, ’link2’, ’link3’, ’flange’]
20 | base = ’base_link’
21
22 | print("\n=== COORDENADAS DE LAS ARTICULACIONES DESDE TF EN GAZEBO ===")
23 | print(f"Sistema de referencia base: {base}\n")
24
25 | success = True
26 | for frame in frames:
27 | try:
28 | trans = self.tf_buffer.lookup_transform(base, frame, rclpy.time.
Time())
29 | translation = trans.transform.translation
30 | rotation = trans.transform.rotation
31 | x, y, z, w = rotation.x, rotation.y, rotation.z, rotation.w
32
33 | print(f"-> {frame} respecto a {base}:")
34 | print(f" | Traslacion: [{translation.x:.6f}, {translation.y:.6f}, {
translation.z:.6f}] m")
35 | print(f" | [{translation.x*1000:.3f}, {translation.y
*1000:.3f}, {translation.z*1000:.3f}] mm")
36 | print(f" | Rotacion (Quaternion): xyzw = [{x:.6f}, {y:.6f}, {z:.6f
| }, {w:.6f}]\n")
37
38 | except Exception as e:
39 | print(f"Error buscando transformada de {base} a {frame}: {str(e)}")
40 | success = False
41
42 | if success:
43 | self.run_once = True
44 | sys.exit(0)
45
46 | def main(args=None):
47 | rclpy.init(args=args)
48 | node = TFEchoAll()
49 | try:
50 | rclpy.spin(node)
51 | except SystemExit:
52 | pass
53 | except KeyboardInterrupt:
54 | pass
55 | finally:
56 | node.destroy_node()
57 | rclpy.shutdown()
58
59 | if __name__ == ’__main__’:
60 | main()
Listing 15. Script de lectura y visualizacion de transformadas de ´ articulaciones desde TF en Gazebo (get tf distances.py).

APENDICE ´ | N
CODIGO DEL ´ | PARSER Y ANALIZADOR DE PARAMETROS ´

XACRO (GET GAZEBO DISTANCES.PY)

1 | import xml.etree.ElementTree as ET
2 | import math
3 | import os
4
5 | def parse_urdf():
6 | urdf_path = "/home/reve/Documents/UC/robotica/finalProject/ros2_ws/src/
arm_simulation/urdf/arm.urdf.xacro"
7 | if not os.path.exists(urdf_path):
8 | print(f"Error: No se encontro el archivo URDF en {urdf_path}")
9 | return
10
11 | tree = ET.parse(urdf_path)
12 | root = tree.getroot()
13
14 | print("=== DISTANCIAS Y LONGITUDES EXTRAIDAS DEL MODELO URDF EN GAZEBO ===\n")
15
16 | joint_world = root.find(".//joint[@name=’world_to_base’]")
17 | if joint_world is not None:
18 | origin = joint_world.find("origin")
19 | print(f"world_to_base:")
20 | print(f" | xyz: {origin.attrib.get(’xyz’)}")
21 | print(f" | rpy: {origin.attrib.get(’rpy’)}\n")
22
23 | joint1 = root.find(".//joint[@name=’joint1’]")
24 | if joint1 is not None:
25 | origin = joint1.find("origin")
26 | print(f"joint1 (Base a Link1):")
27 | print(f" | xyz: {origin.attrib.get(’xyz’)} (Desfase vertical base height d1
| = 60 mm)")
28 | print(f" | rpy: {origin.attrib.get(’rpy’)}\n")
29
30 | joint2 = root.find(".//joint[@name=’joint2’]")
31 | if joint2 is not None:
32 | origin = joint2.find("origin")
33 | xyz = [float(x) for x in origin.attrib.get(’xyz’).split()]
34 | print(f"joint2 (Link1 a Hombro):")
35 | print(f" | xyz: {origin.attrib.get(’xyz’)} (Desfase radial a2 = {xyz
[0]*1000:.3f} mm, Desfase vertical d2 = {xyz[2]*1000:.3f} mm)")
36 | print(f" | rpy: {origin.attrib.get(’rpy’)}\n")
37
38 | joint3 = root.find(".//joint[@name=’joint3’]")
39 | if joint3 is not None:
40 | origin = joint3.find("origin")
41 | xyz = [float(x) for x in origin.attrib.get(’xyz’).split()]
42 | length = math.sqrt(xyz[0]**2 + xyz[1]**2) * 1000
43 | angle = math.atan2(xyz[1], xyz[0]) * 180 / math.pi
44 | print(f"joint3 (Hombro a Codo):")
45 | print(f" | xyz: {origin.attrib.get(’xyz’)}")
46 | print(f" | Longitud del brazo (Link2) a3: {length:.3f} mm")
47 | print(f" | Angulo de inclinacion phi2: {angle:.6f} deg ({math.atan2(xyz[1],
xyz[0]):.6f} rad)\n")
48
49 | joint_flange = root.find(".//joint[@name=’joint_3-flange’]")
50 | if joint_flange is not None:
51 | origin = joint_flange.find("origin")
52 | xyz = [float(x) for x in origin.attrib.get(’xyz’).split()]
53 | length = math.sqrt(xyz[0]**2 + xyz[1]**2) * 1000
54 | angle = math.atan2(xyz[1], xyz[0]) * 180 / math.pi
55 | print(f"joint_3-flange (Codo a Brida):")
56 | print(f" | xyz: {origin.attrib.get(’xyz’)}")
57 | print(f" | Longitud del antebrazo (Link3) a4: {length:.3f} mm")
58 | print(f" | Angulo de inclinacion phi3: {angle:.6f} deg ({math.atan2(xyz[1],
xyz[0]):.6f} rad)")
59 | print(f" | Desfase transversal d4: {xyz[2]*1000:.3f} mm\n")
60
61 | if __name__ == "__main__":
62 | parse_urdf()
Listing 16. Script parser XML para extraer dimensiones y angulos del ´ archivo URDF/Xacro (get gazebo distances.py).

REFERENCIAS

[1] J. Craig, Introduction to Robotics: Mechanics and Control, 4th ed. Pearson, 2017.
[2] I. Hinojosa, “Repositorio de Codigo del Proyecto FP ´ | Robotics”, GitHub,
2026. Disponible en: https://github.com/Reve7339/FP Robotics. (https://github.com/Reve7339/FP_Robotics)
