Reve7339/FP_Robotics/ros2_ws/src/arm_simulation/materials/textures/target_draw.png

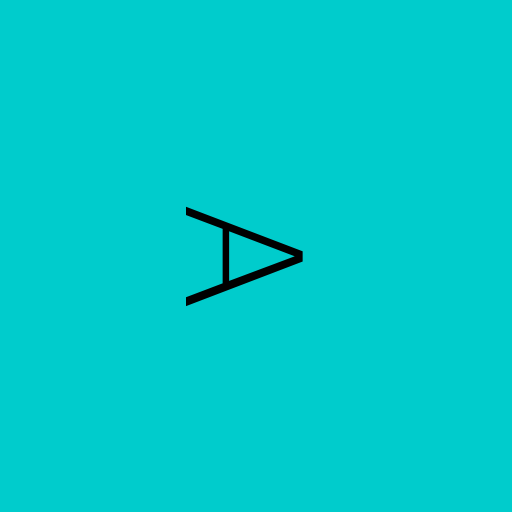
ros2_ws/src/arm_simulation/materials/textures/target_draw.png
