Reve7339/FP_Robotics/CAD/MG996R.SLDASM

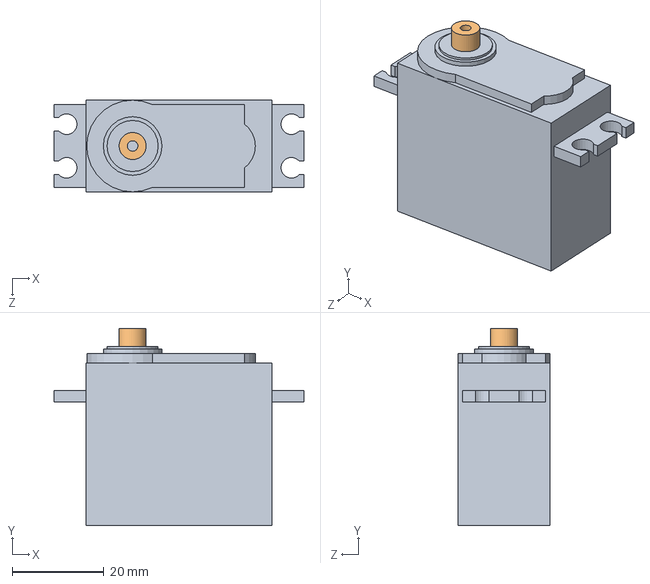
[picture p4: CAD file, 2026-06-23]
CAD/MG996R.SLDASM
54.5 x 43.0 x 20.0 mm
servo
shaft
