Reve7339/FP_Robotics/CAD/Assem-T.SLDASM

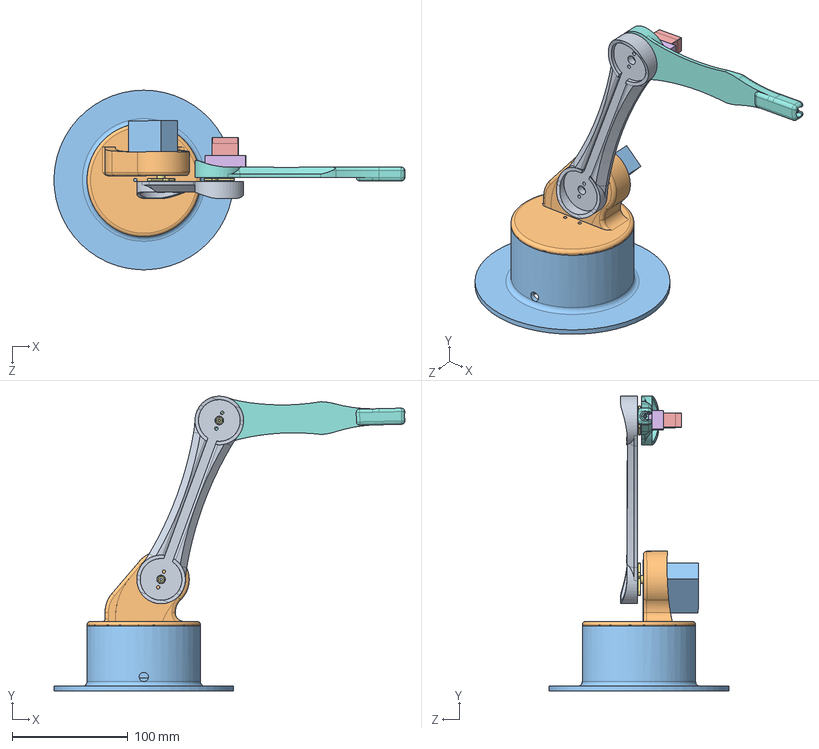
[picture p5: CAD file, 2026-06-23]
CAD/Assem-T.SLDASM
303.1 x 254.5 x 155.1 mm
Base
Articulación_rotacional
Articulación-1
Articulación-2
acople_servo x 2
complemento de_articulación
MG90servo_body
MG90servo_shaft
servo x 2
shaft x 2
Laser
