Reve7339/FP_Robotics/CAD/MG90servo_assembly.SLDASM

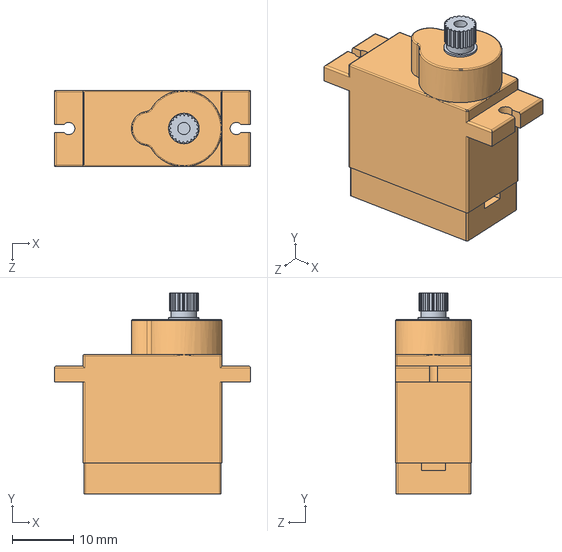
[picture p6: CAD file, 2026-06-23]
CAD/MG90servo_assembly.SLDASM
32.0 x 32.8 x 12.5 mm
MG90servo_body
MG90servo_shaft
