Reve7339/FP_Robotics/CAD/complemento de_articulación.SLDPRT

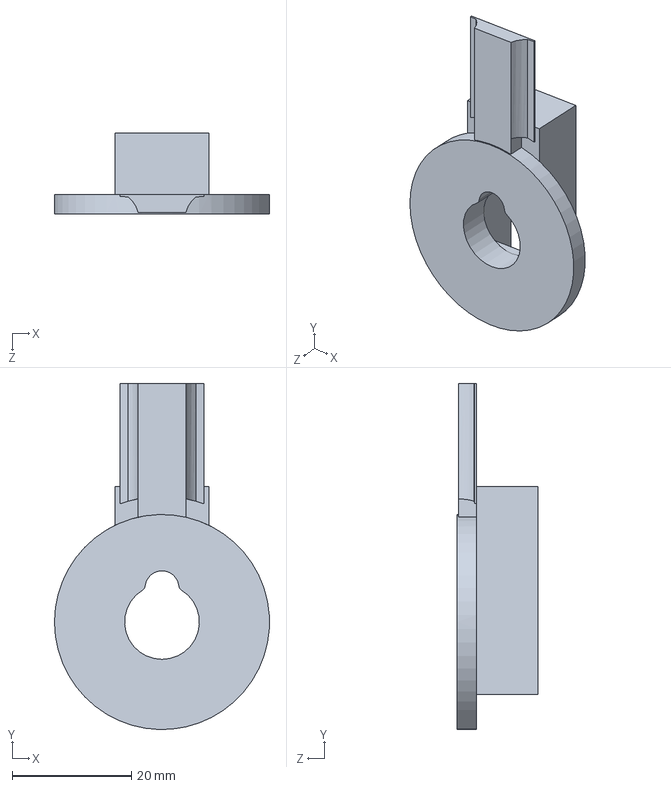
[picture p7: CAD file, 2026-06-23]
CAD/complemento de_articulación.SLDPRT
36.0 x 57.9 x 13.5 mm
