Reve7339/FP_Robotics/ros2_ws/src/arm_simulation/meshes/custom_arm/link3.stl

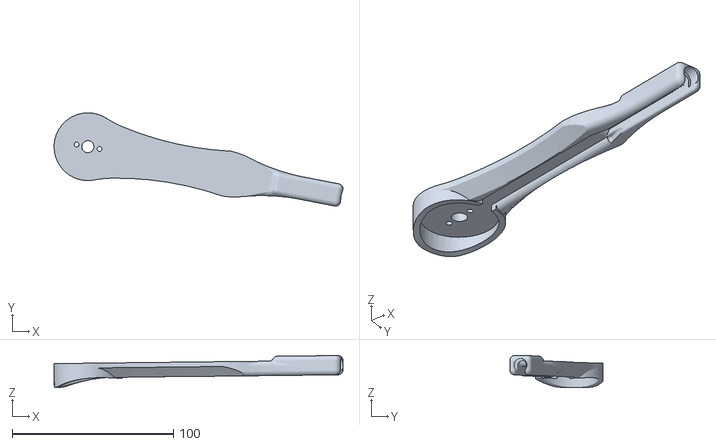
[picture p8: CAD file, 2026-06-03]
ros2_ws/src/arm_simulation/meshes/custom_arm/link3.stl
179.3 x 57.9 x 19.9
