Reve7339/FP_Robotics/ros2_ws/src/arm_simulation/meshes/irb120/collision/link_6.stl

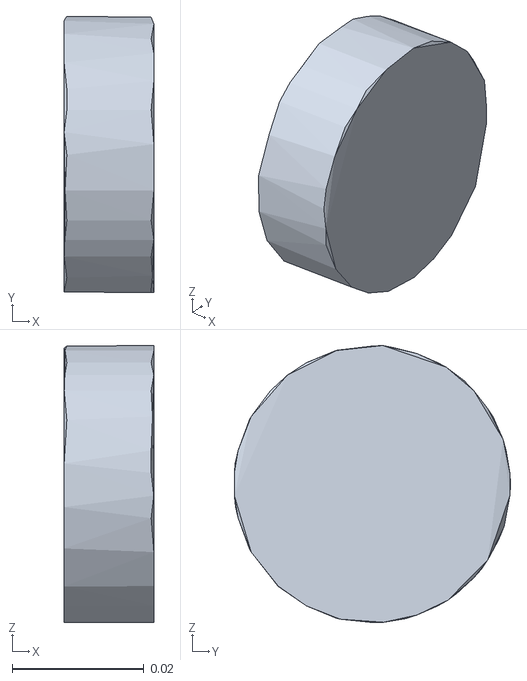
[picture p9: CAD file, 2026-05-28]
ros2_ws/src/arm_simulation/meshes/irb120/collision/link_6.stl
0.0136 x 0.042 x 0.0421
