Reve7339/FP_Robotics/ros2_ws/src/arm_simulation/meshes/irb120/visual/link_3.stl

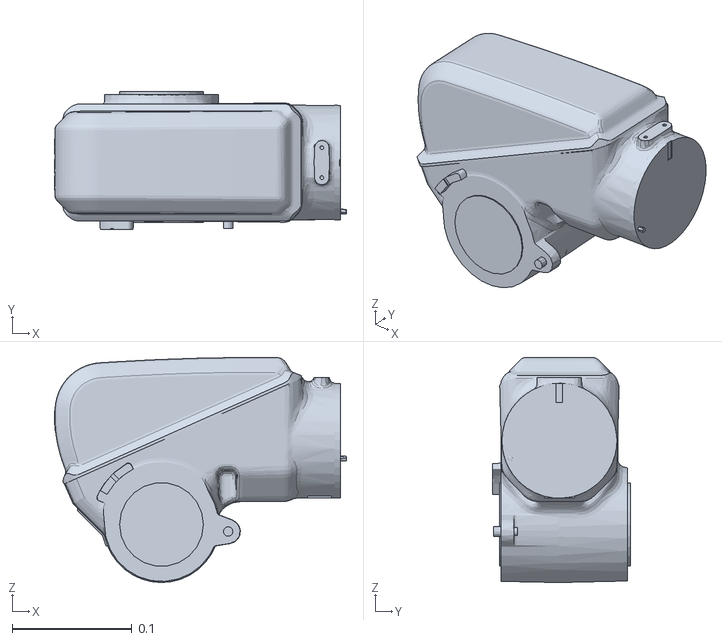
[picture p10: CAD file, 2026-05-28]
ros2_ws/src/arm_simulation/meshes/irb120/visual/link_3.stl
0.244 x 0.116 x 0.188
