Reve7339/FP_Robotics/STL/Assem-T - Base-1.STL

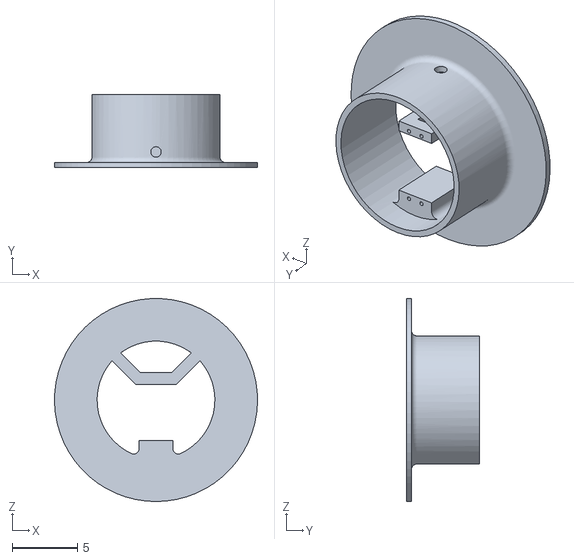
[picture p11: CAD file, 2026-06-23]
STL/Assem-T - Base-1.STL
15.5 x 5.60 x 15.5
