Reve7339/FP_Robotics/CAD/shaft.SLDPRT

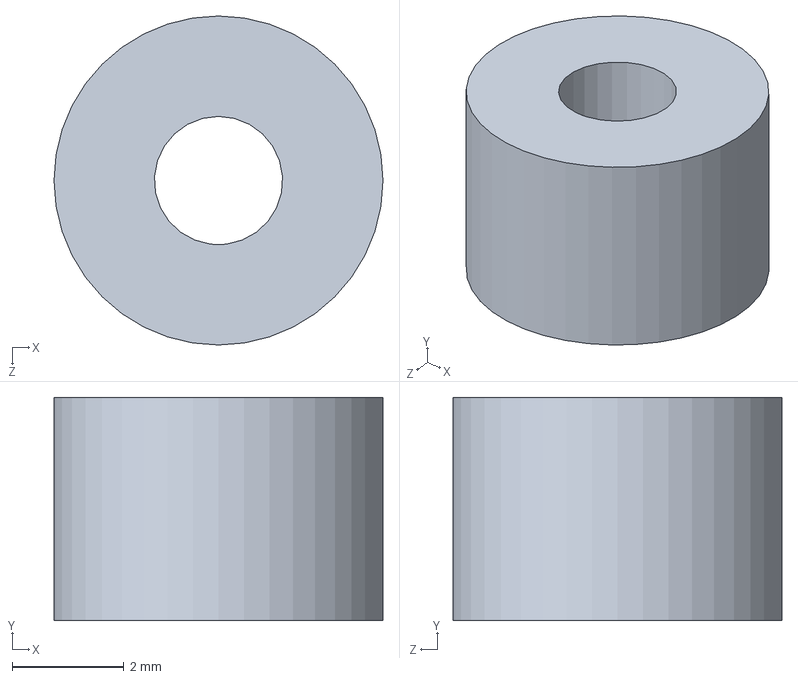
[picture p12: CAD file, 2026-06-23]
CAD/shaft.SLDPRT
5.90 x 4.00 x 5.90 mm
