Reve7339/FP_Robotics/ros2_ws/src/arm_simulation/meshes/custom_arm/mg996r.stl

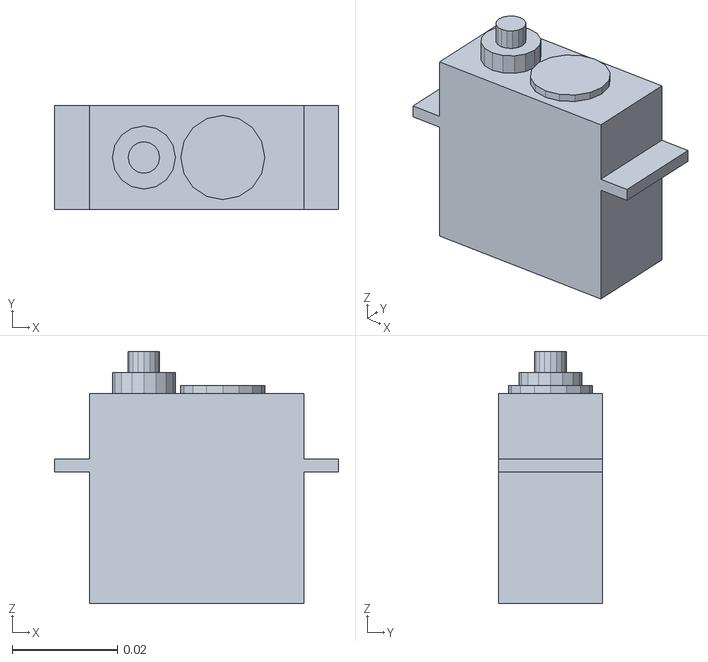
[picture p13: CAD file, 2026-06-03]
ros2_ws/src/arm_simulation/meshes/custom_arm/mg996r.stl
0.054 x 0.0197 x 0.048
