Reve7339/FP_Robotics/ros2_ws/src/arm_simulation/meshes/irb120/collision/link_1.stl

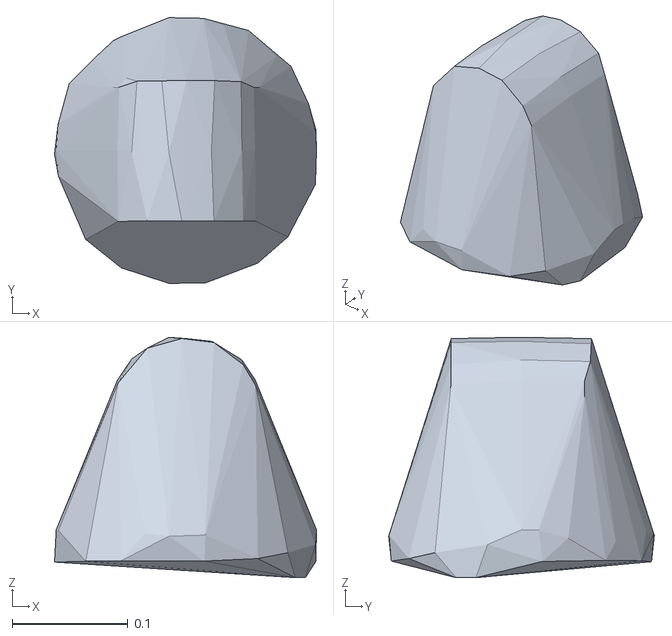
[picture p14: CAD file, 2026-05-28]
ros2_ws/src/arm_simulation/meshes/irb120/collision/link_1.stl
0.227 x 0.23 x 0.208
