Reve7339/FP_Robotics/ros2_ws/src/arm_simulation/meshes/irb120/visual/link_1.stl

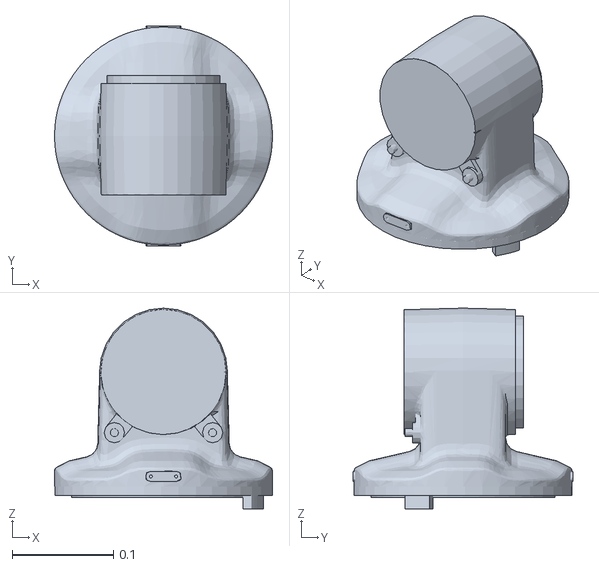
[picture p15: CAD file, 2026-05-28]
ros2_ws/src/arm_simulation/meshes/irb120/visual/link_1.stl
0.215 x 0.217 x 0.198
