Reve7339/FP_Robotics/STL/Assem-T - Articulación_rotacional-1.STL

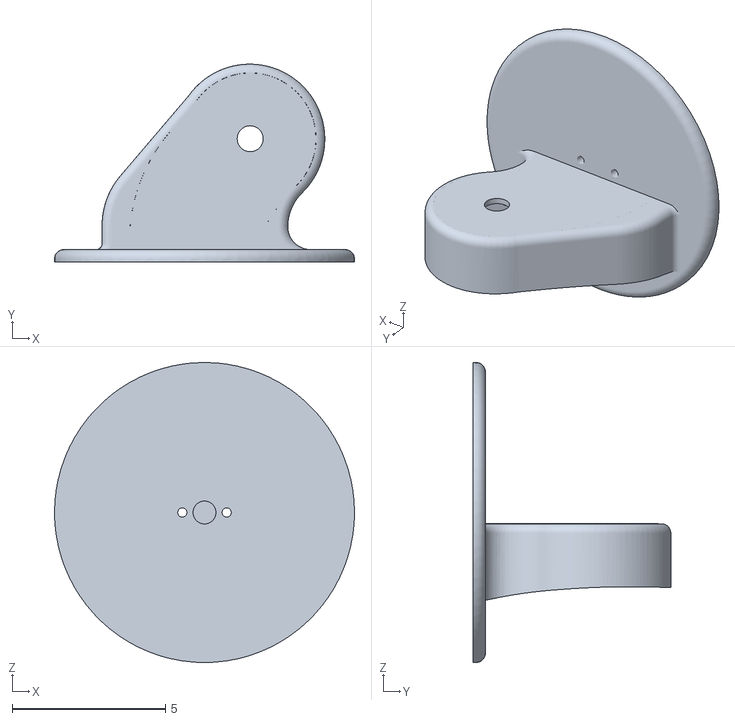
[picture p16: CAD file, 2026-06-23]
STL/Assem-T - Articulación_rotacional-1.STL
9.80 x 6.46 x 9.80
