Reve7339/FP_Robotics/CAD/Base.SLDPRT

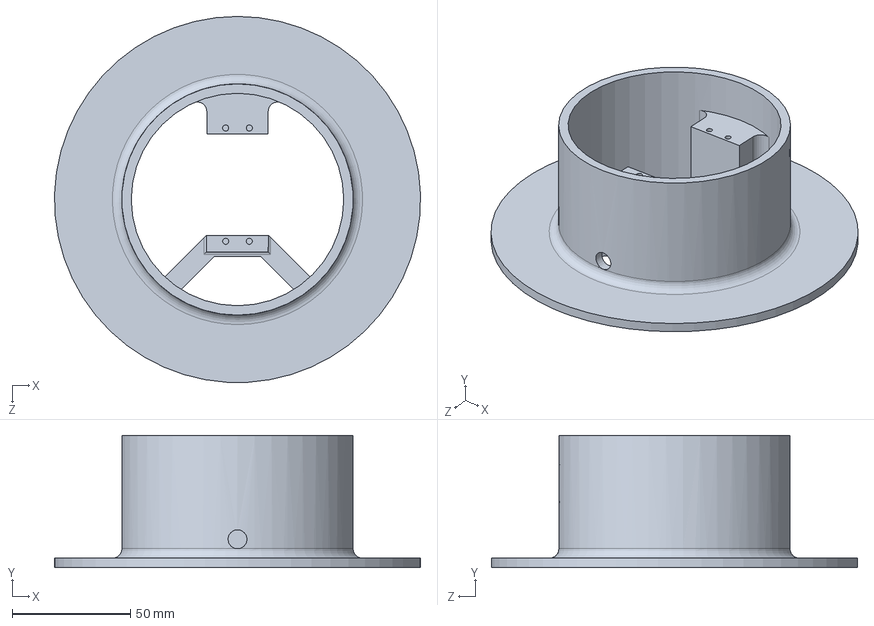
[picture p17: CAD file, 2026-06-23]
CAD/Base.SLDPRT
155.1 x 56.0 x 155.1 mm
