Reve7339/FP_Robotics/ros2_ws/src/arm_simulation/meshes/custom_arm/link1.stl

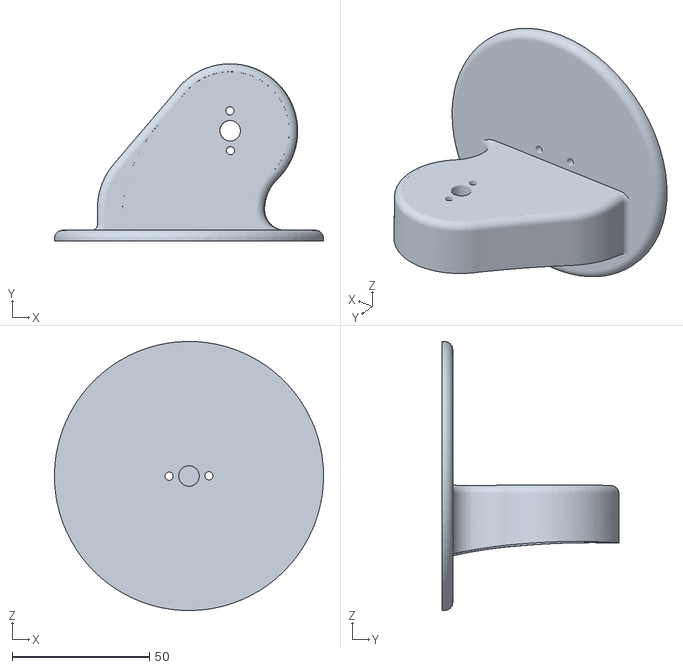
[picture p18: CAD file, 2026-06-03]
ros2_ws/src/arm_simulation/meshes/custom_arm/link1.stl
98.0 x 64.6 x 98.0
