Reve7339/FP_Robotics/ros2_ws/src/arm_simulation/meshes/irb120/collision/link_4.stl

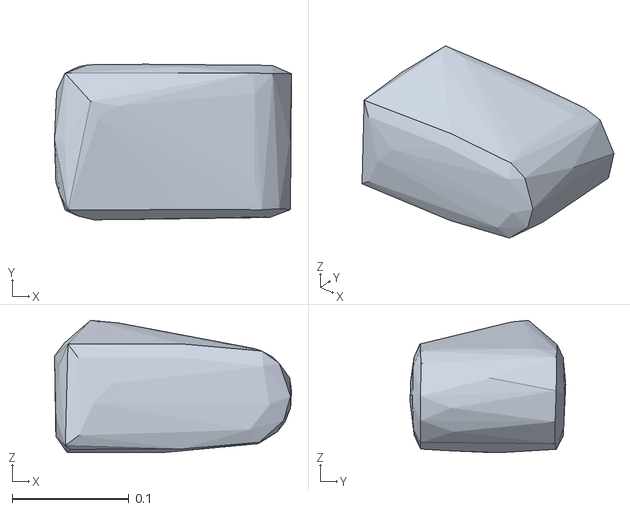
[picture p19: CAD file, 2026-05-28]
ros2_ws/src/arm_simulation/meshes/irb120/collision/link_4.stl
0.203 x 0.133 x 0.113
