Reve7339/FP_Robotics/ros2_ws/src/arm_simulation/meshes/irb120/visual/base_link.stl

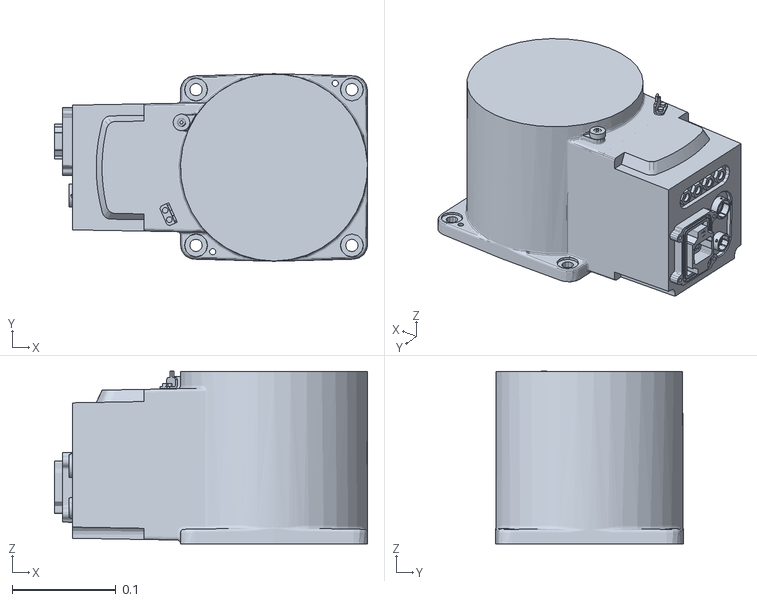
[picture p20: CAD file, 2026-05-28]
ros2_ws/src/arm_simulation/meshes/irb120/visual/base_link.stl
0.301 x 0.181 x 0.166
