Reve7339/FP_Robotics/STL/Assem-T - Articulación-1-1.STL

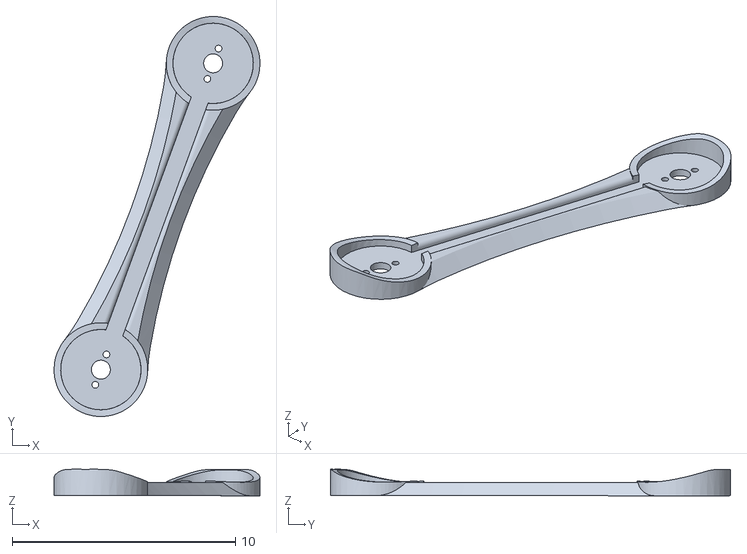
[picture p21: CAD file, 2026-06-23]
STL/Assem-T - Articulación-1-1.STL
9.23 x 17.9 x 1.19
