Reve7339/FP_Robotics/ros2_ws/src/arm_simulation/meshes/custom_arm/mg90s.stl

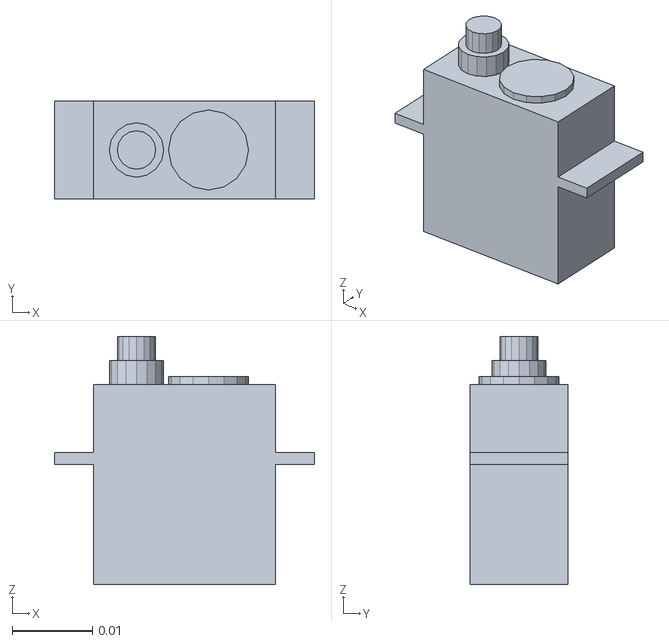
[picture p22: CAD file, 2026-06-03]
ros2_ws/src/arm_simulation/meshes/custom_arm/mg90s.stl
0.0325 x 0.0122 x 0.031
