Reve7339/FP_Robotics/ros2_ws/src/arm_simulation/meshes/irb120/collision/link_3.stl

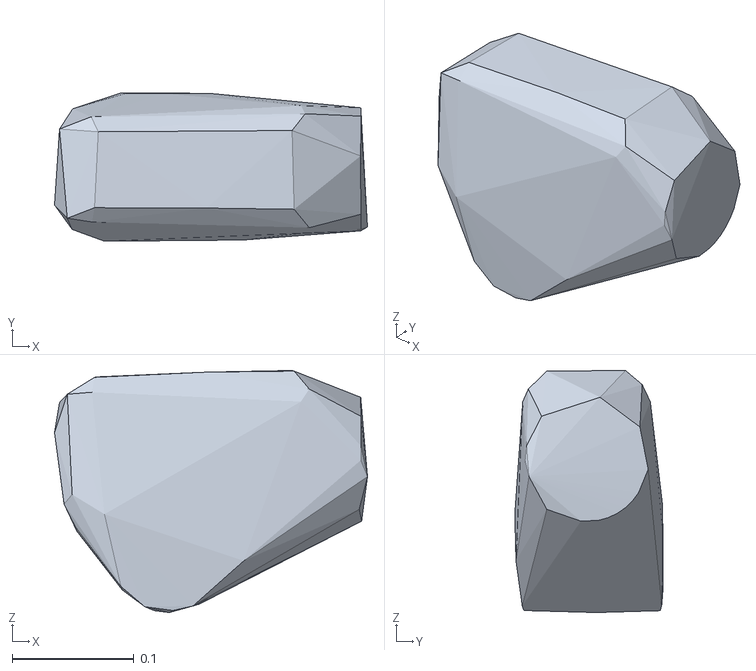
[picture p23: CAD file, 2026-05-28]
ros2_ws/src/arm_simulation/meshes/irb120/collision/link_3.stl
0.257 x 0.122 x 0.199
