Reve7339/FP_Robotics/ros2_ws/src/arm_simulation/meshes/irb120/visual/link_4.stl

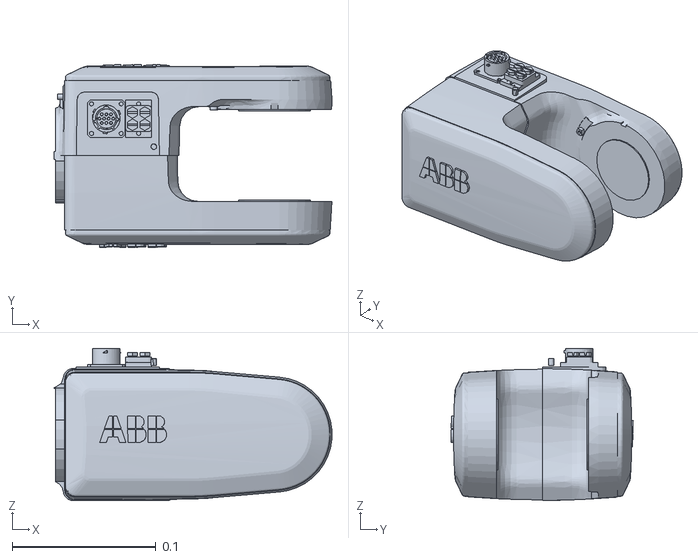
[picture p24: CAD file, 2026-05-28]
ros2_ws/src/arm_simulation/meshes/irb120/visual/link_4.stl
0.193 x 0.127 x 0.106
