Reve7339/FP_Robotics/STL/Assem_Union_Art.STL

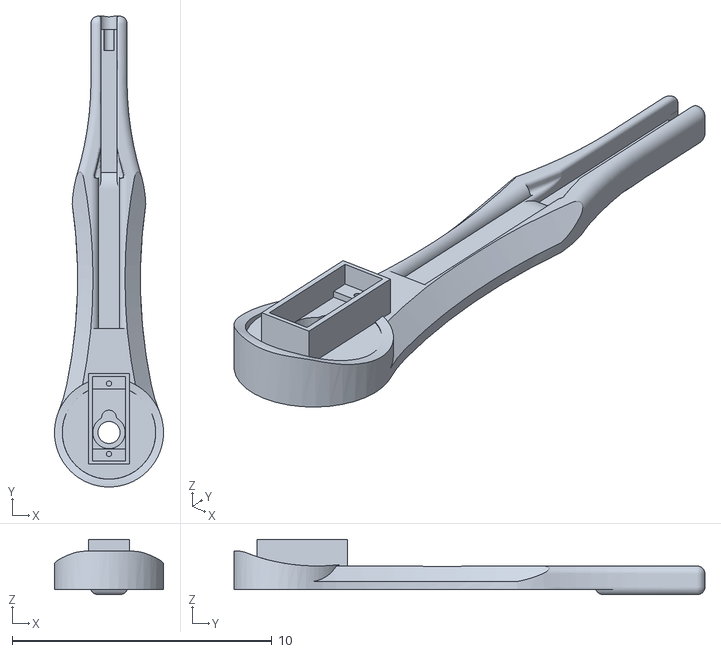
[picture p25: CAD file, 2026-06-23]
STL/Assem_Union_Art.STL
4.20 x 18.1 x 2.13
