Reve7339/FP_Robotics/CAD/Laser.SLDPRT

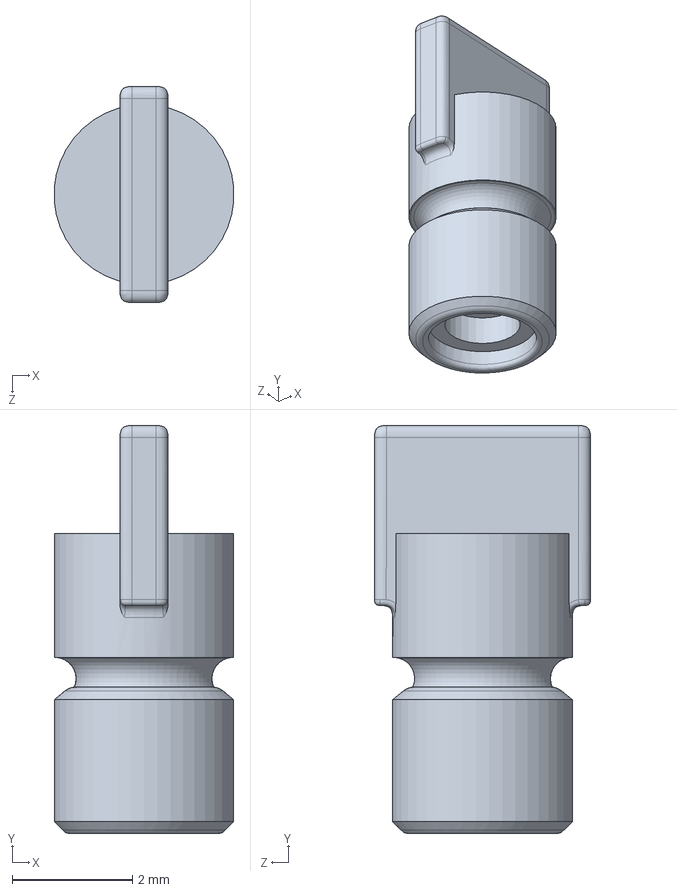
[picture p26: CAD file, 2026-06-23]
CAD/Laser.SLDPRT
2.99 x 6.80 x 3.60 mm
