Reve7339/FP_Robotics/ros2_ws/src/arm_simulation/meshes/custom_arm/link2.stl

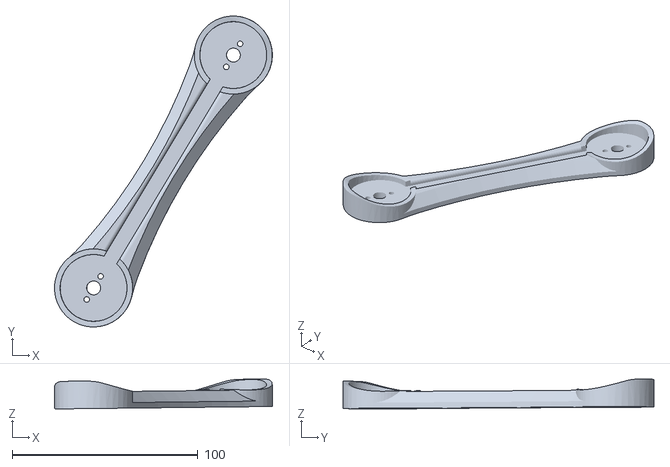
[picture p27: CAD file, 2026-06-03]
ros2_ws/src/arm_simulation/meshes/custom_arm/link2.stl
117.3 x 167.4 x 16.1
