Reve7339/FP_Robotics/ros2_ws/src/arm_simulation/meshes/irb120/collision/link_2.stl

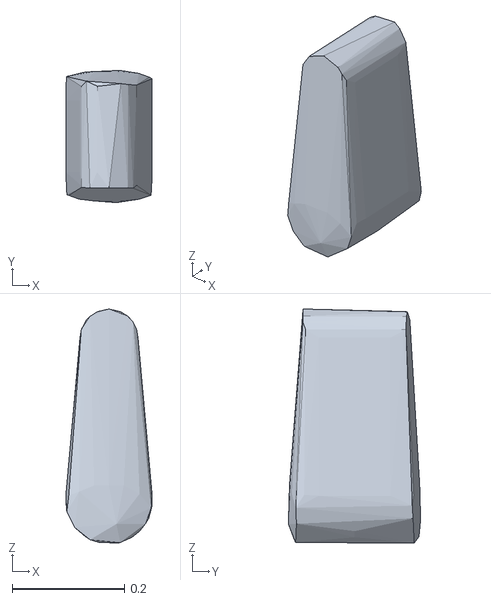
[picture p28: CAD file, 2026-05-28]
ros2_ws/src/arm_simulation/meshes/irb120/collision/link_2.stl
0.154 x 0.236 x 0.418
