Reve7339/FP_Robotics/ros2_ws/src/arm_simulation/meshes/irb120/visual/link_2.stl

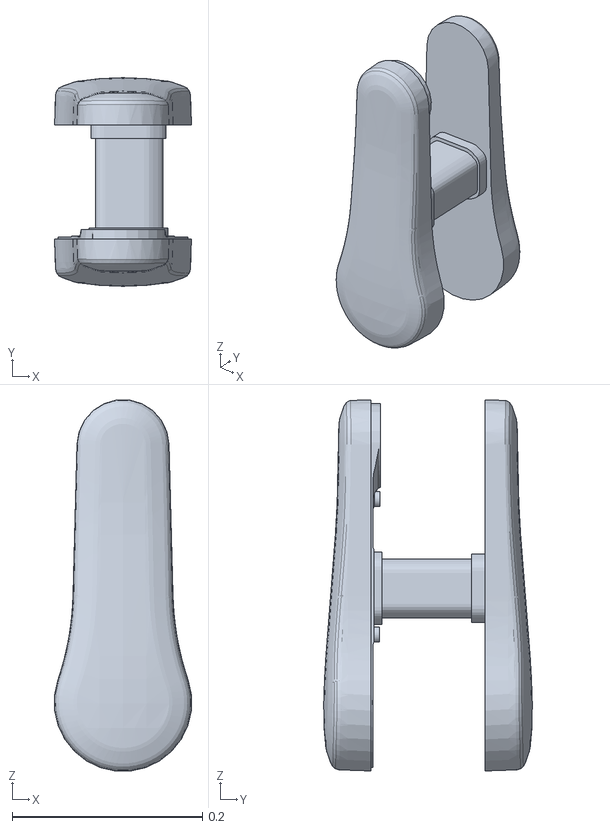
[picture p29: CAD file, 2026-05-28]
ros2_ws/src/arm_simulation/meshes/irb120/visual/link_2.stl
0.144 x 0.219 x 0.39
