Reve7339/FP_Robotics/ros2_ws/src/arm_simulation/meshes/custom_arm/laser_diode.stl

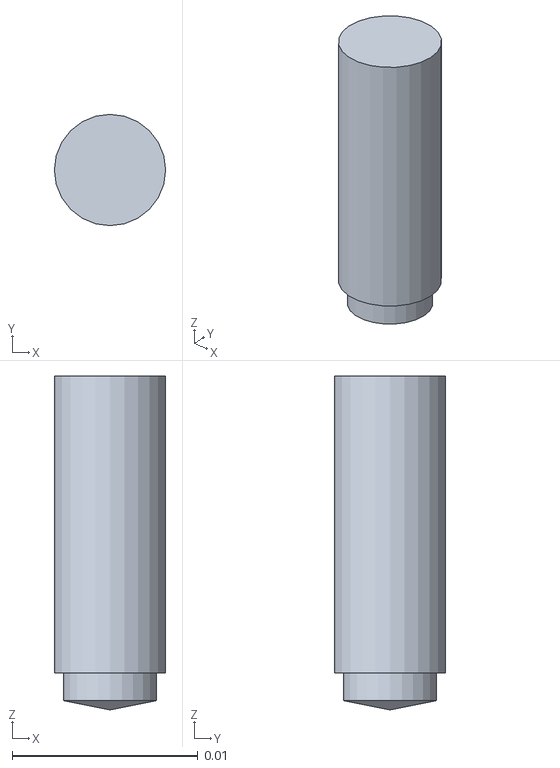
[picture p30: CAD file, 2026-06-03]
ros2_ws/src/arm_simulation/meshes/custom_arm/laser_diode.stl
0.006 x 0.006 x 0.018
