Reve7339/FP_Robotics/ros2_ws/src/arm_simulation/meshes/irb120/collision/link_5.stl

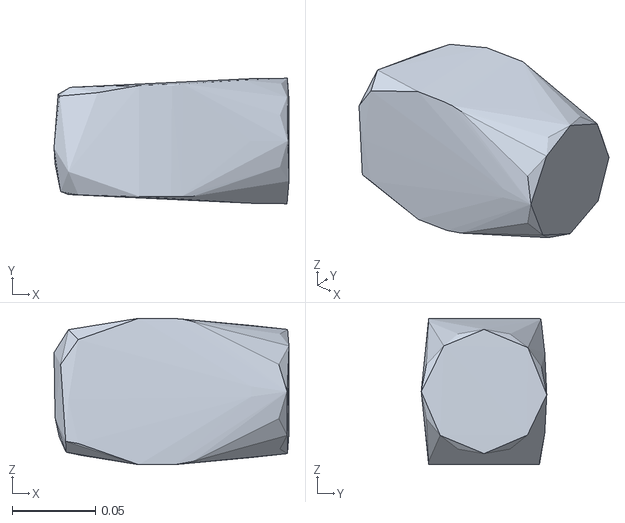
[picture p31: CAD file, 2026-05-28]
ros2_ws/src/arm_simulation/meshes/irb120/collision/link_5.stl
0.141 x 0.0752 x 0.0877
