Reve7339/FP_Robotics/ros2_ws/src/arm_simulation/meshes/irb120/visual/link_5.stl

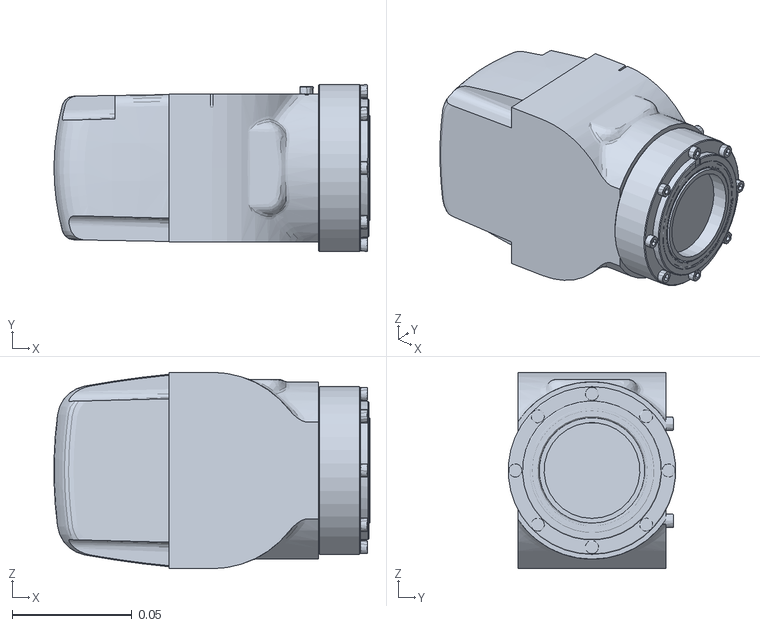
[picture p32: CAD file, 2026-05-28]
ros2_ws/src/arm_simulation/meshes/irb120/visual/link_5.stl
0.132 x 0.0698 x 0.082
