Reve7339/FP_Robotics/CAD/Articulación-2.SLDPRT

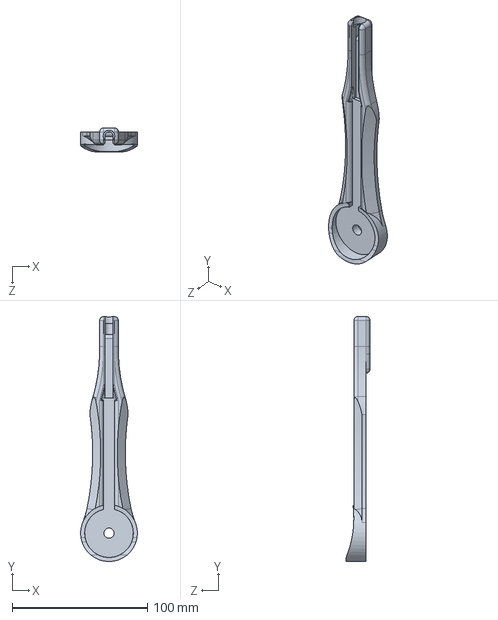
[picture p33: CAD file, 2026-06-23]
CAD/Articulación-2.SLDPRT
42.0 x 181.3 x 17.8 mm
