Reve7339/FP_Robotics/ros2_ws/src/arm_simulation/meshes/irb120/collision/base_link.stl

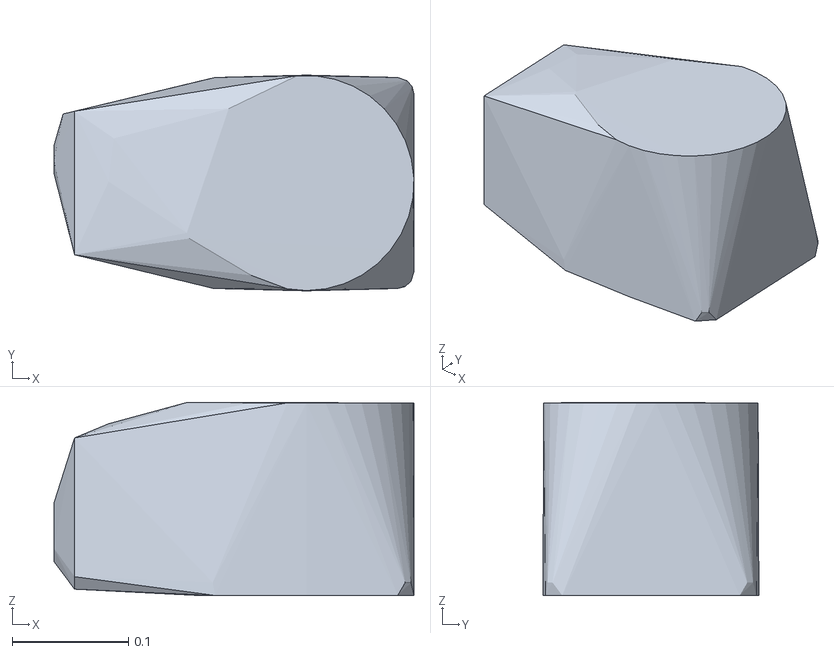
[picture p34: CAD file, 2026-05-28]
ros2_ws/src/arm_simulation/meshes/irb120/collision/base_link.stl
0.31 x 0.186 x 0.166
