Reve7339/FP_Robotics/ros2_ws/src/arm_simulation/meshes/irb120/visual/link_6.stl

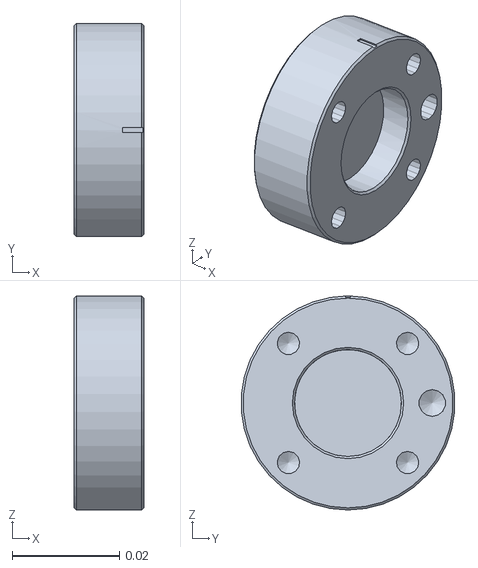
[picture p35: CAD file, 2026-05-28]
ros2_ws/src/arm_simulation/meshes/irb120/visual/link_6.stl
0.013 x 0.0399 x 0.04
