Reve7339/FP_Robotics/CAD/MG90servo_body.SLDPRT

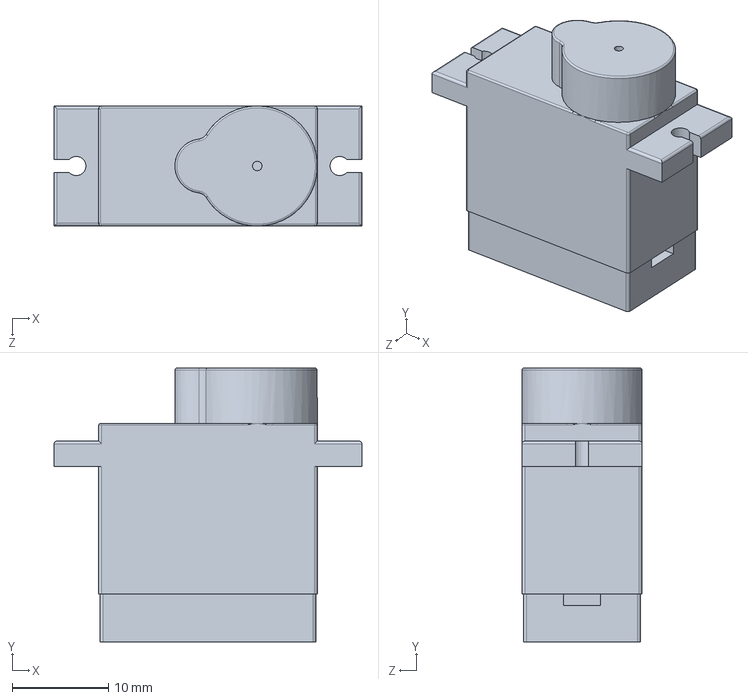
[picture p36: CAD file, 2026-06-23]
CAD/MG90servo_body.SLDPRT
32.0 x 28.5 x 12.5 mm
