Reve7339/FP_Robotics/CAD/MG90servo_shaft.SLDPRT

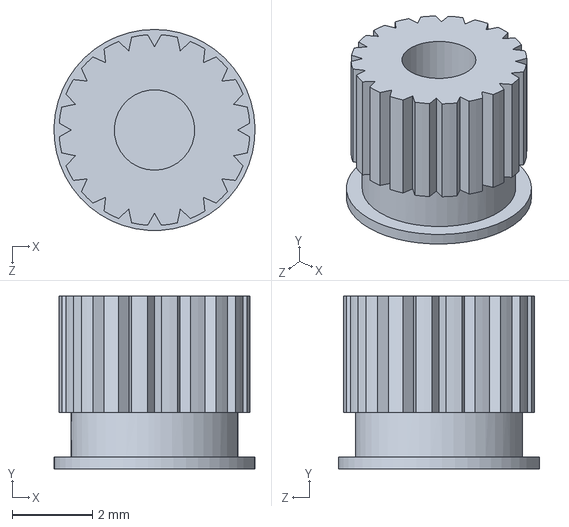
[picture p37: CAD file, 2026-06-23]
CAD/MG90servo_shaft.SLDPRT
5.00 x 4.30 x 5.00 mm
