Reve7339/FP_Robotics/CAD/servo.SLDPRT

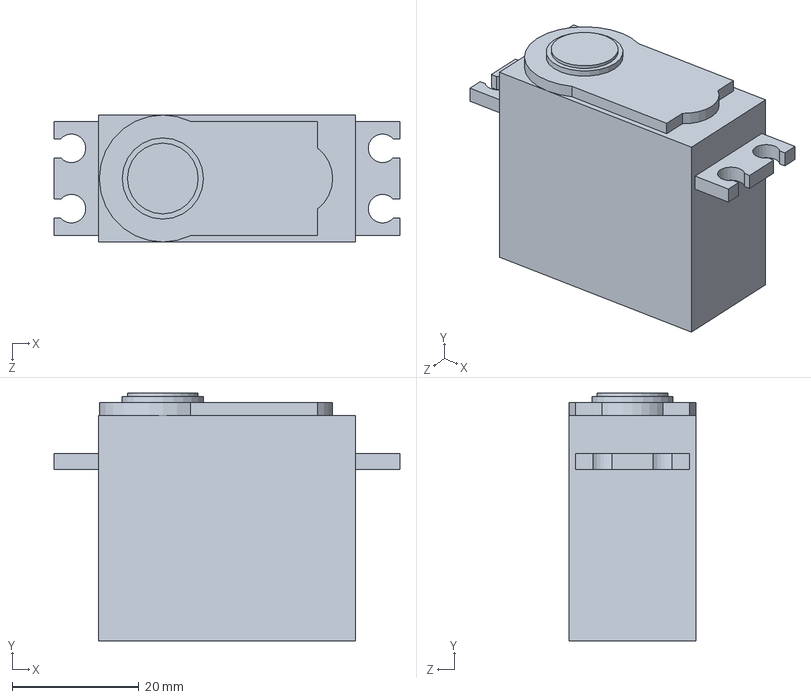
[picture p38: CAD file, 2026-06-23]
CAD/servo.SLDPRT
54.5 x 39.0 x 20.0 mm
