Reve7339/FP_Robotics/CAD/acople_servo.SLDPRT

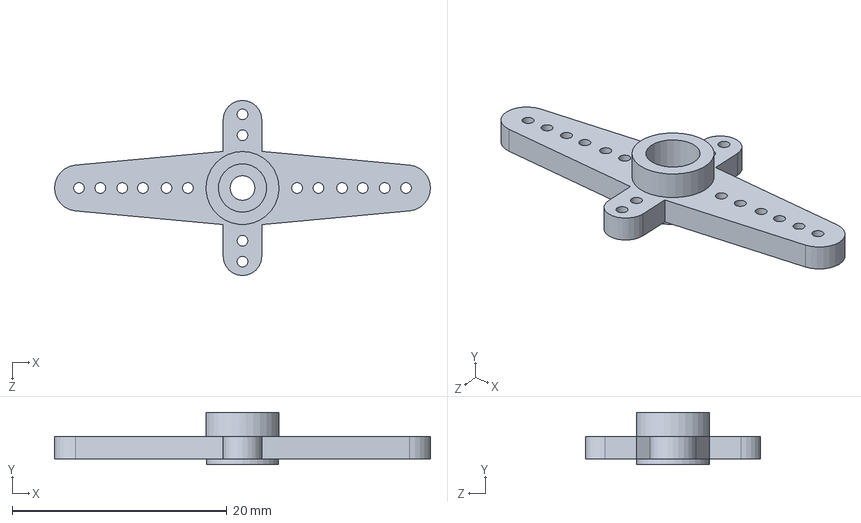
[picture p39: CAD file, 2026-06-23]
CAD/acople_servo.SLDPRT
35.0 x 4.85 x 16.3 mm
