Reve7339/FP_Robotics/CAD/Articulación-1.SLDPRT

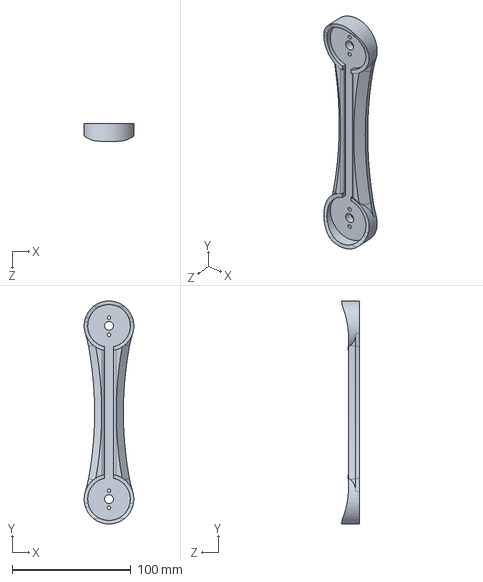
[picture p40: CAD file, 2026-06-23]
CAD/Articulación-1.SLDPRT
42.0 x 188.2 x 14.8 mm
