Reve7339/FP_Robotics/(list of files, cad)

Other CAD files:
CAD/Articulación_rotacional.SLDPRT
ros2_ws/src/arm_simulation/meshes/custom_arm/base.stl
