Reve7339/FP_Robotics/diagrama.pdf

a3 = 146 mm | a4 = 161 mm

# a2 + a3 + a4 = 322 mm

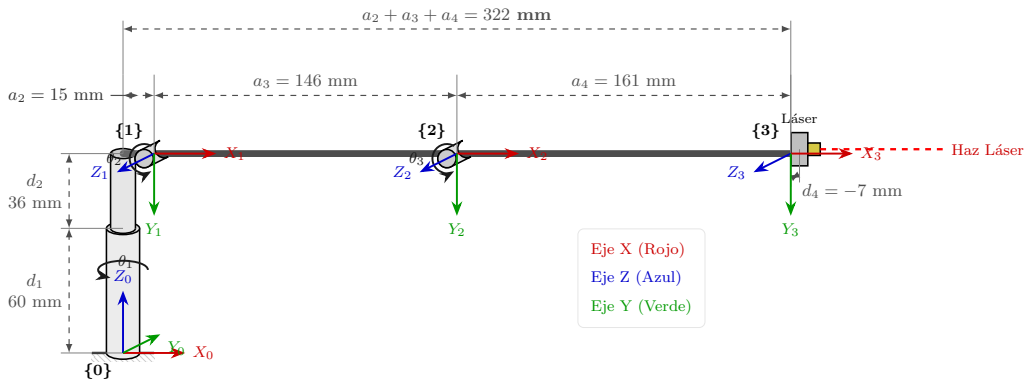
[picture p41: page 1]
L´aser; Haz L´aser; Eje X (Rojo); Eje Z (Azul); Eje Y (Verde)

U1

# Esquema El´ectrico de Conexiones

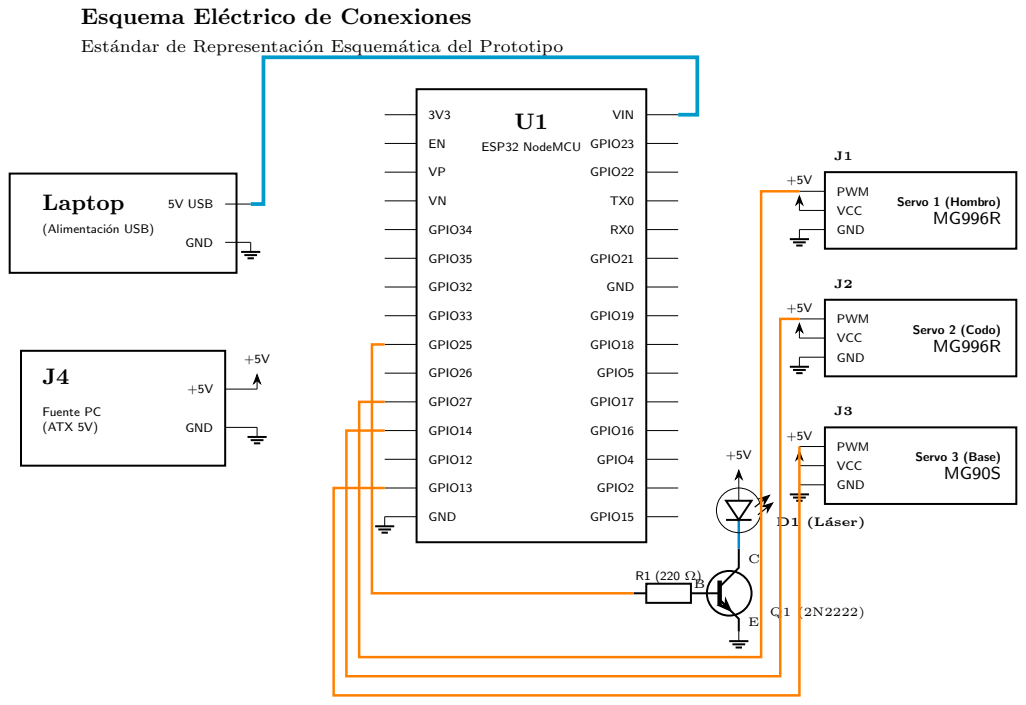
[picture p42: page 2]
Laptop; 5V USB; GND; Fuente PC (ATX 5V); ESP32 NodeMCU; GPIO13; GPIO12; GPIO14; GPIO27; GPIO26; GPIO25; GPIO33; GPIO32; GPIO35; GPIO34; GPIO15; GPIO2; GPIO4; GPIO16; GPIO17; GPIO5; GPIO18; GPIO19; GPIO21; GPIO22; GPIO23; VIN; Servo 1 (Hombro) MG996R; PWM; VCC; Servo 2 (Codo) MG996R; Servo 3 (Base) MG90S; D1 (L´aser)

Est´andar de Representaci´on Esquem´atica del Prototipo

(Alimentaci´on USB)
