Reve7339/FP_Robotics/(commit log)

2026-05-28 Initial commit: simulation
    [arm.urdf.xacro, base_link.stl, controllers.yaml, link_1.stl, link_2.stl, link_3.stl, link_4.stl, link_5.stl]
2026-05-28 Concepto de interfaz de usuario
2026-05-28 Implementación de sh
2026-05-28 Conexión de ROS con la UI
2026-06-03 Cambio de modelo y se agregaron los sistemas de referencias
    [arm.urdf.xacro, base.stl, laser_diode.stl, link1.stl, link2.stl, link3.stl, mg90s.stl, mg996r.stl]
2026-06-03 docs: remove ESP32 firmware mentions, add communication flow details, and format listings in white borderless style
2026-06-03 docs: remove webcam references, camera calibration subsection, and OpenCV objectives
2026-06-03 docs: remove remaining camera/vision references in intro and methodology
2026-06-03 docs: add ROS 2 launch script and URDF/Xacro robot description to appendices
2026-06-03 docs: explain simulation launch and URDF model in section V and detail controllers.yaml
2026-06-03 fix: update UI kinematics, IK, and canvas drawing to use exact 5-system DH model offsets
2026-06-10 Esp32 implementado
    [arm.urdf.xacro, conveyor_belt.urdf, cutting_target.urdf, cutting_target_A.urdf, cutting_target_D.urdf, cutting_target_E.urdf, cutting_target_I.urdf, cutting_target_N.urdf]
2026-06-19 docs: Actualización de informe, cinematica, trayectorias e implementacion de firmware y simulacion
    [arm.urdf.xacro, laser_beam.urdf]
2026-06-22 fix: calibracion codo invertida offset 60, limites UI J2/J3 y redondeo de angulos para evitar zumbido en MG90S
    [esp32_firmware.ino, main.cpp]
2026-06-22 fix: resolver tope de límites J2/J3 en la UI y acotar rango PWM de codo para evitar chirrido de motor
    [esp32_firmware.ino, main.cpp]
2026-06-22 fix: desactivar cache HTTP en el servidor para evitar que el navegador cargue el index/js antiguo
    [web_bridge.py]
2026-06-22 fix: remover etiquetas de 0 grados centralizadas en J2/J3 para evitar confusion visual
